notMarque/RomiOnSpeed/BOM.md

# Hardware
[4x Encoders](https://www.amazon.com/WWZMDiB-Measurement-Module%EF%BC%8CMainly-Information-Progressive/dp/B0CM3C8KFT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)
[20x V-Groove Bearings](https://www.amazon.com/uxcell-V623ZZ-Bearing-3x12x4mm-Bearings/dp/B0DBQWDBWD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)
[20x Support Bearings](https://www.amazon.com/uxcell-Groove-Bearing-1080095-Bearings/dp/B07FVYR9S5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)
[10x Axle Bearings](https://www.amazon.com/uxcell-R168ZZ-Groove-Bearing-Shielded/dp/B0CLVFJ4CR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)
[M4 Countersink Bolts](https://www.amazon.com/HELIFOUNER-Countersunk-Screws-Kit-Threaded/dp/B0BKSH8MDN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)
[M4 Socket Bolts](https://www.amazon.com/Kadrick-Assortment-Metric-Washers-Upgrade/dp/B0BZ6XG8PT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)
[Grub Screws](https://www.amazon.com/Matrelt-Assortment-Stainless-Precision-Instrument/dp/B0CN1JYRY8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)
[O-Rings](https://www.amazon.com/uxcell-Rings-Nitrile-Rubber-Diameter/dp/B07DG6CW6R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)
