notMarque/RomiOnSpeed/Mechanical/Diffy Swerve v1 Notes.md

# Assembly
## Bearing Stack
More vertical clearance
Expand horizontally
## Super frame
Make Holes for bearing bolts self-tap diameter
## Standoffs
Make holes self-tap diameter
