notMarque/RomiOnSpeed/Mechanical/CAD Process.md

# Diffy Swerve Module
## Wheel + Axle
Small Bevel Gear: 11t 1.5mm module
### Bearings
#### 1/4 x 3/8 x 1/8 In bevel gear
[R168ZZ](https://www.amazon.com/FOCMKEAS-R168ZZ-Industrial-Mechanical-Equipment/dp/B0BMW2P61D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)
[Other Option](https://www.amazon.com/uxcell-4-inchx3-8-inchx1-Shielded-Bearings/dp/B0828JXX4N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)
#### 1/4 x 1/2 x 3/16 in main wheel
[R188ZZ](https://www.amazon.com/uxcell-R188ZZ-Groove-Bearings-Shielded/dp/B082PQ9FSY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)
## Big Bevels
https://www.chiefdelphi.com/t/involute-gear-design-tutorial/387230
[Bearings](https://www.amazon.com/uxcell-V623ZZ-Bearing-3x12x4mm-Bearings/dp/B0DBQWDBWD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)
## Mounting Plate
[Bearings](https://www.amazon.com/uxcell-Groove-Bearing-1080095-Bearings/dp/B07FVYR9S5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)
