notMarque/RomiOnSpeed/Electrical/Top down requirements.md

# Main stuff
- ESP-32 Based, likely using an esp-32 s3 Wroom
- using an rp2040 for low level control of motors and encoders at high speed
- broken out connectors for line sensors, ultrasonic, at least a few servos, and everything else that we have room to break out
- 4x fuckass motor controllers to make romi go brrrr
- leds and oled diplsay
- Enough sensors to know where tf you are
