notMarque/RomiOnSpeed/PCBs/ModuleBoard/Motor Controller Board Design.md

# Parts
## Drivers
[DigiKey(shipping?)](https://www.digikey.com/en/products/detail/texas-instruments/DRV8244HQRYJRQ1/18182849)
[DigiKey12a](https://www.digikey.com/en/products/detail/texas-instruments/DRV8243HQDGQRQ1/18159292)
[Simpler Controller](https://www.digikey.com/en/products/detail/stmicroelectronics/VNH7100BASTR/7691017)
[Two in one](https://www.digikey.com/en/products/detail/texas-instruments/DRV8262DDVR/23331378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)
[DRV8263-Q1](https://www.ti.com/product/DRV8263-Q1)
[Real](https://www.ti.com/product/DRV8245-Q1/part-details/DRV8245HQRXZRQ1)
## Connectors
[XT30](https://www.digikey.com/en/products/detail/sparkfun-electronics/PRT-10474/8258064)
# Driver Settings
Diag: LVL5 Off-state Diagnostics disabled
Slew Rate: LVL5 Randomly Chosen
# Notes
gpio 6-9 for encoders
GPIO 10 for n_sleep
# BOM
- [x] 100x 100nf 0603 Caps
- [x] 6-12x [10uf Electrolytic Cap](https://www.digikey.com/en/products/detail/nic-components-corp/NACE100M35V5X5-5TR13F/22320440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)
- [x] 3x [DRV8245HQRXZRQ1](https://www.digikey.com/en/products/detail/texas-instruments/DRV8245HQRXZRQ1/15926671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)
- [x] 3x [NCP1117 Lin Reg](https://www.digikey.com/en/products/detail/onsemi/NCP1117IST33T3G/14545464)
- [x] 3x [W25Q128JVSIQ](https://www.digikey.com/en/products/detail/winbond-electronics/W25Q128JVSIQ/5803943)
- [x] 10x [RP2040](https://www.digikey.com/en/products/detail/raspberry-pi/SC0914-13/14306010?s=N4IgTCBcDaIEoAUwAYAsyQF0C%2BQ)
- [x] 4x [ABM8-272-T3](https://www.digikey.com/en/products/detail/abracon-llc/ABM8-272-T3/22472366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)
- [x] 10x [Micro USB horizontal modified](https://www.digikey.com/en/products/detail/amphenol-cs-fci/10103594-0001LF/2350351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)
- [x] 5x [XT30 these ones are 60A peak]()

[Digikey Order](https://www.digikey.com/short/719qh9n4)
