notMarque/RomiOnSpeed/Camera Improvements.md

Try finding black blobs because all walls are white
Trying to call numerical values
Can set diff frame sizes. If don't find full size tag, double resolution and search sub-area
