notMarque/RomiOnSpeed/Goals.md

# Mechanical
## Performance
Top Speed: $8mph$ or $3.6\tfrac{m}{s}$
Twist Speed: $150rom$   ($100-300rpm$ /$0.6s-0.2s$ per rev)
