notMarque/RomiOnSpeed/Code Shit/IRP I2C Communication.md

# Sources
[Pico to Pico Communication via I2C](https://forum.dronebotworkshop.com/raspberry-pi/pico-to-pico-communication-via-i2c/https://forum.dronebotworkshop.com/raspberry-pi/pico-to-pico-communication-via-i2c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)
