notMarque/RomiOnSpeed/PCBs/Main Board/Notes.md

Just started, nowhere near done
# Sizing
(8mm + 20mm)*2=56mm
# Shape
==Looks goofy as fuck, please advise==
![[Pasted image 20250424031044.png]]
