notMarque/RomiOnSpeed/Excalidraw/RomiOnSpeed Horizontal Lower.md

---

excalidraw-plugin: parsed
tags: [excalidraw]

---
==⚠  Switch to EXCALIDRAW VIEW in the MORE OPTIONS menu of this document. ⚠== You can decompress Drawing data with the command palette: 'Decompress current Excalidraw file'. For more info check in plugin settings under 'Saving'

# Excalidraw Data

## Text Elements
Rigid Caster ^bgVhg6Tt

Compliant Caster ^HxKlhEez

Swerve Modules ^P1vYqv42

## Embedded Files
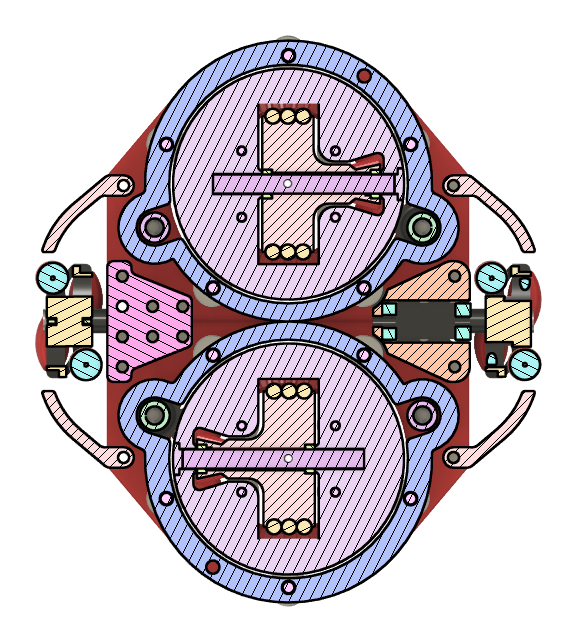
[picture p1: Pasted Image 20250506162951_264.png]
f13c5fbc5453cff97808ef78f08e42022ff3a2b7: 

%%
## Drawing
```compressed-json
N4KAkARALgngDgUwgLgAQQQDwMYEMA2AlgCYBOuA7hADTgQBuCpAzoQPYB2KqATLZMzYBXUtiRoIACyhQ4zZAHoFAc0JRJQgEYA6bGwC2CgF7N6hbEcK4OCtptbErHALRY8RMpWdx8Q1TdIEfARcZgRmBShcZQUebQBGeO0ABho6IIR9BA4oZm4AbXAwUDBSiBJuCAAtKuIAaXoABRgAZQBmAEcANQBZGABWAE0AUQBxABkADgA5UjTSyFhESsJ9

aKR+MsxuZx4AdgBObT34/p59vb2eSb3kgBY2zcgYHbb45O0DycmANniD/ptZInA5tfpPCAUEjqbh3SZ3bQ3QHxQ6JO4/MEQyQIQjKaTcQH9bR3E7JZJtHj9G7ovYQ6zKYLcZIQ5hQUhsADWCAAwmx8Gw5hI2dZmHBcIEcvMyppcNgOcp2UIOMRefzBehhRxReLslApZAAGaEfD4FqwRkSQQefUQVnsrkAdWhkm4fCKAjZnIQZpgFvQVoqEMVeI44

TyaHiELYYuwaheEbJEIVwjgAEliOHUPkALoQg3kLLp7gcIQmiGEZVYSq4VJB4TK0PMTMlsvu20IBDEbjxHinclAu7MtuMFjsLgJ2nDpisTjTThibuTA77SYovY/cvMAAiGSgne4BoIYQhmnrxGGwSyOUzhQWxXdZQqEn6pEIAHlxph9Mw38QfgAhN9BgAKw5fRMHhKp9TKJZxHQcV2SoB8AF8nnvO9ICfDV/zuTRuQQDkAA0AFVxjqPYAAl6DgRo

zUCABFaDFngOCIAQtgkLvZD3VzNshDgYhcD3LsIz2dF+gxO4eGXB4ISIDgOWLUt8Dktg5X3NBD3wY821ZIShEzCBEGVCtlBtI1giLCQDXiNpsH6A1NHsu5AWwA0DQOPZJmSSYEANLyDR8hApOSc53LaXAeE0PYbWYdw4NvBZIwfeIeIhbB2TgJSTSKVCihKR8RPQTRlC6SRlB+AAVPUIVgyo90wGq222NBnBcvYUh+ZdTh+MT4juUEIXjVBnB7Dr

QQeULewODFJjdBZIWdbtB20H5KSxHE8T1NAeDuOkOAZOChwWu0vVVAVKgAYniBAbpum0ZTlZMlRVPkLqFcgtTFCUmoWizTXNViAy7FlPUdJadtB+1vUBypgZtYNJEbTNkoW6NZTjbtEzbZ60wzApeL+gsECs1AWxUtsK2IKsJFweIEbPZHsopk6OyK2z4S+ZIZohEcZ3HVB0UeKdR1nec4P+H4fJ8gaN0p7ddw01AtJ0hbTxei9Ml1G8HwKhasOg

HC8IIkiyMo6jaLZBBGLQ5jllp0hEIgFC0r4gShKVlFxIxM5ubOOSK0UtBydU9SipVhBaqwbb0AAJVxEhUG5UI9zmINKEq6PKnj1RiCTlOmHMzgoBaQgjDgnhjrKA1i4AMVwfRjWG4WFoaqAAEEiGUAWIGCA1frKEcoHMAhO9xHuoGjG09ByXAKyYUmQ7bAUE44AhM8a7OE7z5PWULukhEn2PwjLuC2SESO23khAKM2/EI20Hhcs2PXyiKiAKMwOp

8EkYYECMG0dUhRZwhC1XgZxPg+RuHsM4bQKQohbmUYazg1raH6O8XaPxAReX6ugiEUJiAwgjDcNBG1cT314HtNs9I/RVw9NDc66oIDXVuqwh6sp5SKmVIw+qn1tQ/XMsaAGvogZ8kDLpMGCAnSEJdJDCR0MfR+ltGIkGbZEZMwjFGGMmMEx0IgLjdMN5CbV2JovZS5ZKxgLYjwBmL0NFk3MbpNmBJyRzS6suXm04xzcClnLBafMxxzg4AuCMvZxI

uR7JuHcwRhIHiPJfNWZ5NZXlyAUXWD5MLvxfO+T835fwASAqBcCkEmLQBYtWR2HFnZcVdgtfiglYmiW9m0AaldBwBwUszUOXJw7xKjpvCQvJ9A+CcFAfOe805qIzlnQZBgRnWDGbvVORccil3Lq6PRNccj10bvgZu/SO5dx7n3AekAh4j3wGPbu9Up7pWLnPUMpAzGtjRq+fw68ZnoCGfMnI4zlkHyPifdZaBz4JLKNfW+5CY5JCfqUPKpRX4G2y

R+L8P4/yARAmBCCdwoK1XKQ7J2oDXRSQSHcAa651w/DhFSRBzwdhkoSFSB4tkrhwJ4GtfBENUB/FWucS4bQ5rSUmOg3aZCtqwkRIkGa/R1zcy8skSJ1CDq0KhmdN6TCWF3Q2G2R6nCzw8I+iKb6upBEmkUaI60qrwYyNdFamGIi4YqNsSGMMTItEY1gFjPRBj8ZoBzHmUxRUl760sdWNotiGyurQHrO2Fd3TwrKGET2kw2iXEuH8Pxg8vGcG7FcT

xosOBBJCagfqA5bJkkmFExWvTtJgsgOrZUyTtZdLdg0z2YksGSQBDSjpQcHEvPBWpHpcTa0QjgGwCsqS/UPkSgsOhpRkgPmMaUWdpQUFJDWhcAV5wvgiqoRhBEq5JYyqlp5byPYl21PBSnIZjcZCdkaBOyUwdHEnSiKQKA/4qamW4DGjAl5dSkw/l/H+f8AFoQgDXbABkdgfD+G8ZcPlK4Ah4KmzNZRlC4CygmY4GIDhkhgT8FN/RQSTHjRCbIxA

v0mQOr+h8/6tY5CAzUeoTRWidF6AMEYEwZiTLvJBtSMG0AfGBNJCSyQqTxFXCmgcEHMPYcoatVN3wQT9G5qhg45GJHig7pUig2JcBBtfWUSj7c9MGffuxKgFH8CngoErCOz98qU3fp+3C+EiKkXIlRGidFraAPxfBPTNowHODeBuyWLSri/DmjKoaOx3htERLcLBwqXKoYVfusoBCiGoAgecSkbQDiJErhS2lUg74x36Ie641wSSEd6kR/ah03Xy

LVWqK6Wr7ong4c9bh6reFGp1JKPMQjzWOstW161uX5qJskeNy0Tq6x+CRlG1Aej0axk9bopMio8ZGIDQ3EmRmB2YVDbTO4EbiD2L/UA3gWnWaexI+WqlcJ83827P0cEIt+ZForq4taWDFX6wVjEhzfSdVJIA9eFtdT3aNJLR2iSYJdpzUrVfQOsPB1hxHarMo47J06zvKusA87SdLrQiT/L5xATFZ7MCXqtLSjVcRLV+ElwJKNbI3ebMV7ID4BvQ

YO9wlH2Tqxx6HT1HHC0ejfRjIKSgMlTKhVaq0EBPQczM4D4ew4FgkBCSa4SJ0f8fkxKuaLlvIHBcuiH4tu7gPZM8qKXP7Zf8fl4B9+LGGjNHaN0PoQwxhTFmGrqDQmRofAeNVikanki29OHA9DkBTc7Q+G8Vc8CJLspcjNB3EuP1mcQhZ8XGBlQF44kXglVSbN2fB7WpzCKXOVEaPEeggwOj0CkgF+2GoQHNVhLtFIZxVylYeFLcryCeyTGOAcTy

qGThfbTehxaNqIxUs6utNs2IoXEuayqqbPIBsSE1WwnrT0uGvQ64ar6w3TmQbG7DRbk233Q2kTNu1C3/RLbUcIF1TZuzuq22GneG9T20MQJkO0LBOxZkfHO3gn6Cu3sWDUTWcQnB7DeFCiyzOWzQFlwXe0CXFm7F6hTS6nhD0UIFBwQARwjhPCh0YynSzHSQwjfkqAeHwAAH0eh4hmBcAqhKpJgWh25+g6h/wDQhBa58BTkYJAs2JgsUI0IY1MlK

gOQORbh/wHQOgqNxgKJiBsBRh/wfgWhlA2hiJw1bYylu8ZCnYXYFhl0IB6kPZ2YkcfZbIENe1i9+QcdNIIdW5PkIAWh7NSBGBUAeg2BiBSxwgEZpkBl0B/CmAgiQiwjgg8g8xi41l/sUjtkG4m5uBys24rljk/Jb9zl3B8ibkso7lZ554nkoCow3kKwPloi/CAj4jQjwjkjqFD42Bj5WBgVUBQUOkb5KtuxH5690JCoWC2h2DODuDeD+DBDhDRDx

Db87tLCq8+80A1MER0RzgM1Msvhx8dgAQEgxJQpbchULcl8ctZFUABUp9ThDgqQvgHgYFUYygt9xUU8fhksXCvJ8M1pvsFoaEjo7UDV0Bj9usdVetz9QToA+FjURs2x/oP9lEn85sX8uVZt6EvRkT4Zltf9MwNttFtsS1sYFofUDtETA1i8qYaZ4IfgEC1tbtAtYU4UWQUDUAdcx8MtMCGBsDXQ8Eft8DgkJYh8+xzgeTyDolKDa88d61aCUlmxj

NIB7CEcvZO0wRgQE83CX1Tte4h0ZS60jIn16DV0ScydF0edKcMldgOp7hepPJ8NpJfEWlbYXCUhBxQRexyRStdoKcZ1rTbjGUHilx4RU0BSMJK4vibgfilxY9KRL0bC5JBd9BhcH1jS0k7wwtvggyAQQznjwyFhIzvi4Ffi4z+g+dbR31P1v0ZdUA/13cmN35m9W929O8INQ9NcRMKR2d2U2lK4aVMSk8sNuAjh/iupbhhUdd/hc8S8qMayzIdTo

C89dNC8Qgai2xTNzM1yKlCUNzbMOIDTRjEV35lDVD1DNDtDdD9DDDjDTC2wVirMQsCREhjgrgoF8M7gexPIl8J8WlVp6t3hSDU1exLiuUpIktvzAQiMyQvhGsxUKElwEhh900s8isURd9gT98YTwTtU1YoT9VD8NQ4Sb9TVhElFcT99X9rjMTKyFEH9P9UTIB1E1tCSPUgDSSMNQDfUsxbD8wjtnklzyhYC2IYpltI0/9XdW5mSZyk0ipoKJNQQl

8Akc1Qljcs0C0/tYQh9PJuyq0wca1ZSIAG1zxod6CkDlT4d21ml0E4F/htT+1BKPDh0vDR02wCcYdp1icMlzS/SvKMJRoBVEQVMO1SQzhE8wBnA5pVpQo3hPyZpbIBpfKFgSc2pUNPh1woLvJuZfh1xbZIqjgpMxp1xULis9gEzShbCBdWRb01ARd0zPKFhUqIKMq2h5LYLcqHx8qkKirAcHhSqKy9IP1ndaz6zTKgNmy28O8bF2zBMCTtAWllw7

dyRyQvJUMN8TdhyNjEQSQvgThdpDgyUZzKNhqFyHLQYdMy99NtzFyKNS8tzDMdy1iFogga8DKEBcpwBCY2I4A4AzQPY6MYJsQshKgu58RNgGBCAEAKB/x8KXpsL3IEaDQpQIBoNHZAM9x9A6J2t3owSutcLIBUafpUwMaYaz8CLL8iKhsBFwbCb0bMha578HVH9xEyhaamMMasbptqKaaRAiaOb5t6KUSWaCbea6b9BY4f9VsJL1sea0b2bMg3wi

T2Kq4UbRb5b9Ba464si9kcjZa+b6bUjT4Nk9axaN5Dlx4QbCjka2aoBibMg/r897r1zWa1bbaMbhg7rVyHrK9rMihVa5a3bMhLrKppDz9ka4p2QTRCJuBDg4h0FQQoKZ92UJJwaI6+R8BBhYRELU1FL9hbc1NOdwajA2ADAAbB4CAL4mRjhyzWS/aba7bxbGY1sIAw7waFQSA0jja/b27iAzQEAFMASk9XxiAEiEAPbcBNBgg3q27h7QTX5/w+R3

5SBlAZQAAKXsWkXgdCrezej4foAAShtGPmUFLHFEqGXrXoy2oF4CBGvqvvWzQUPtGP9p+k5oQEVuHk4EVIHUg2JmPkrFfBGo3LXknqVn6LbGwCIAU3AYWjXmBpBVIAvijEPmvm4FBWfrsGAgQGwFyBaDXjgFHvHtAenr9tlGHkYEqhLvwDLtjThgyBwe8XSgMknn0BDu73Mr1M8L6MQcNPzAMBaHoc/oFmoKvhTnbgYYoaoeZg+rAHhTvySN/W4m

QiAA
```
%%
