notMarque/RomiOnSpeed/Excalidraw/RomiOnSpeed Side Profile.md

---

excalidraw-plugin: parsed
tags: [excalidraw]

---
==⚠  Switch to EXCALIDRAW VIEW in the MORE OPTIONS menu of this document. ⚠== You can decompress Drawing data with the command palette: 'Decompress current Excalidraw file'. For more info check in plugin settings under 'Saving'

# Excalidraw Data

## Text Elements
Battery ^UHLA0zpS

Mainboard ^HnPc4Sg0

OpenMV ^pUpjU26c

Rigid Caster ^xbQSwX9h

Compliant Caster ^qkthdMDI

## Embedded Files
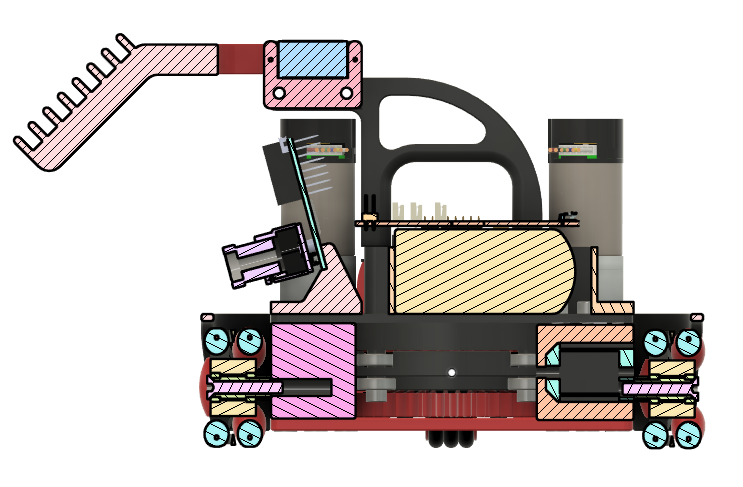
[picture p2: Pasted Image 20250506162554_531.png]
9ef8d6fa3cdbedeb506a24360c639e40fbb60c4d: 

%%
## Drawing
```compressed-json
N4KAkARALgngDgUwgLgAQQQDwMYEMA2AlgCYBOuA7hADTgQBuCpAzoQPYB2KqATLZMzYBXUtiRoIACyhQ4zZAHoFAc0JRJQgEYA6bGwC2CgF7N6hbEcK4OCtptbErHALRY8RMpWdx8Q1TdIEfARcZgRmBShcZQUebQBGeO0ABho6IIR9BA4oZm4AbXAwUDBSiBJuCABmXABNAGsADnrSGAoAOQBxAE5iABkKACUAdmVOgGVhtNLIWERKwn1opH4y

zG5nKsa44caq4eSANmGAVm7kqpPh1cgYDfjDw5ThqvieYeGAFkOT7YubiAUEjqbhXYbaRrxRrJHhbQ7dQ5VKrdAGSBCEZTSbj7RraF7xKo8bqwxrdN7xAHWZTBbjJAHMKCkNj1BAAYTY+DYpEqjOszDguECOWmZU0uGw9WUTKEHGI7M53IkvI4/MF2SgIsgADNCPh8ONYDSJIIPJqIAymSyAOrAyTcPhFASM5kIA0wI3oE0VAHSzEccJ5NAUx0QN

gC7BqO5B5J0kNS4RwACSxEDqHyAF0AVryFlk9wOEI9QDCLKsJVcKkfcJZf7mKmC0WQ2EEMRuA9PrCCR3PgDGCx2Fw0J9gzMGExWJx2pwxPaCcNiYTocXmAARDJQFvcLUEMIAzTV4gAUWCWRyqYzAKEcGIuA3raDXx+iKJVUOPFjo6IHHq+cL+ABnISpuaDbvgu5NlEUBCKmECILKJbKGaOrBHmEjdAgWqNMQhzblU2DEJoLYIJoJxHLgPCfK+yTY

Ii6GfMkWqaJohzUZ8rb0u44hpo6YAjjM8SOpmIbYEycC/nqRQAL6rCUZQVBIACqAASfQAILJEYcDjGacxcdAWAagC6wPsk2ivgSb6fFc7wnD2IZRqgmxJOchyfI0PyJLCySfNcIZAsQIJoNsKSvDwJyouimIamgFGUhw1JcR+ZQWi68pcpUADE8QINl2VmmKErxjKcoculSrkCqApCoZIbIfqhp6V67EQZaCA2gFdoxfSzosm6Hrmhy3ohr6ki1q

mfGQGG4qRm2MYAkVSYpgUQmjtmuC5veqANv+IYlsQZYSORZrSjWAbiTto7Npt8TdLZWyfJRDqjn2E6DqgN2+c944DlOHAzkG8RHMS3kIsua7BHeW47gge4HsemTquePGyaO8noAAUjAuCHgFABWJwUKp3Toyc2CJiukhKQAYmSmplLp5akEyVA8ZJgmXtet7Ae9j4nM+8LbOFIZfj+aDbQBbBAZtoHgaOG6YNF6AAEK3hurTHZQAAqBmVCrMhMHc

WacFA4yEEYXHvkbORU+tuoOVUALy1AqlEMob0QMEWo1V9pBQOYBAuxi7tQGGZp6DkuAlkwqFbX+AJchiJYENrCu66rBtmrgQgh4M4Rm1xjJCDDwtR0pkVYkG2g8FJMm7ZtEBKRwAAK2CfOMyiViGDNKjrRnYtoHnvN0D3D2+pJHACDnOFC3QpFZlzHKRbnbI0AL+YF73JCc2jfI0pwRRiFe8HZo5Uh6SVOq1aWKugWU5ff+XipKJ0lQqPIVaq1VI

bq9Xuo1g3NUuj1Nqtp7TdVan1f+poqx+FGmdIM8dwwzWjBfCAC1kznhWmUNaG1zrFlLMZdAuAqjHQPGNPBTYEDcyJIib4yRV4hhegOWchxezfUnNOLihwCTxF2EcE+clVzrm5jLYuo59zFXhqeXIBRkY8UgGjCAVMrTEGwAAWUkIcNgSsyaEAQAAeU+EYGALQ2CdDprMeAelBTMwgKzdmIYrw3khg+b4fNCTDB4I8VhJdvwUM/JLFk0toaOx1hIN

RkcOD7kFIAso5AKAp0VhACJJZomkFidqY2ptzb2lQVqY2Nt9B22xKEhWgc3aVE9t7MofY/buHKcHUOAJw5RCjqQGO4sQwJ38MnMJ6AUlRLYDEzO2c2C51YDktAhcxFlC/AgMuh9FZJGrqUaSRQUblHrnABScBcYKS8dgHSVieS9xDIQpy4I96uTJLZR4VR6E+NHA5HguJXhXDBCceI3w3IPTXqAtABwzJvCFqONEiz7QCMgGfRK4DUqlRvhAO+uU

VghgKs/A819358iquqb+epIGVCamaFK1p/m8Fhb1BqhKAGkNgeQhBXSkGwFmqg9BS00AXlqjmBAHS467QIeWT4tLTp1n8clKh11ugfHxC81BTDOD2mJGw/sHC/pcShAcGELzXJg2EcEsCMzIASNlFIxGsiZjFHkZsyoMB2iJlxs4eg6NaiqVIFqdoTdDxN1xu0ZwmtboWOgMcw6TM2AswtWzGYWDIBOK5tdXm/MKJ8wAiWUWsdGwBKllDA1pSkn6

LgmogAahrBJfSID5uyEWpCWT865KtlAQpxS0AOy7gZBplSMLVMgLU/2+B21KiacJY2kTo6bU6aObpSd8CJMqBWjgVbKSjPGbWqZpAi4pv9AsqKbYq413WXXSomBNAAEVxgUAABrdDtI7YN6AnZmnOe+XE8RbIviOBcGELxJ72l+BCYYbwtgHEaJ8BEE1ARkq+aZN8IKyhgu3TFSFEBoW0gpWyeFmVkV5T3E/IqspMXlWxWqYUWYf4EuNDS1D7UN5

PWSsAsjnoKPDWEH6eB71EHTWZSg+a0pFqYKzNy3lGa5ICsOicYVxB6XpouuK6hFkTheMaAwn2r1uD0Rg929hHBfr/Xetcliw9Yq7SERDERITUVwxPGajlciLUKPrkpJShxL36GGFABSzhhia1kIeK8iZlCfCboG7uRDQ3hpmJG0o0aICxpcTzNxz5GifPohutN47ZmBNMzm1tqcJCDETsQVArJQhqxLTO3L+XCvFaYNWnI2SLZ5IKbbfA9tc39vQ

FUs0Pb6mu0aWJZpw62mCek5NUgicOC9Jy+gPLqgCtFYZNVxdOc86TNQNMjd8zy5LN3as2uqN64AEd6jqGIGolciYjnzB7qnPuaBTJ70uPQ+er4yT0UeWUZ5LEq4sR4BZV4vDkgoj8hBve2h1NSE2xCuKCUUMtThW/CQSKH7YcKi/fDd6P44uI7VUjVLyPQNh6SjqYCCeulxwx/Ho4RqSbA1NCMnHN6sp4xg5a/H1o8rHXy1GImiGHHE5JtLAgJWz

VeIl35jDNOqbfMq162muJVEoj8WynjdUmf1bLUUFmEZnnNTMFGcl67dETOMVkh5C31HPckVkzgYAnFIJoT4gxj1CEOM4ILt6kOhbsRGhxo4Yvc14fFwk3RoTK98alzn6Ws0gTM3LMt7J9A+CcFASr83uQ+i1nHgwifrDJ7myV+tdW621Ua0U5rJTsvOx6x2r2nWmB1IDlXgdfWh0R0GxzoTI2xsTaSfH7POQU/55DFnJbEyC5rsNR7UuEPK4rLAG

s0oGzFG2vtY651rr3Weu9b6/1Ymb2XZC7Ym7jkKKmS3icS4pFPEwi+Up972JZ5vgJKSB4K8LgttHOvTqvBcQ+R4H/84FwLkYUB88GqAUGw8HYXw5wsIlE+8Q+8U58qGaOiKmGKK4iOGqO6GBGlURGXaEAdU9GA0FOtGrUVGX+NGl8LohBRKMCLGoqt27GdODkgMjOCYzOHKUWOC7OYqCi3OSGUwMCIqqYeuQa++s+c+9IQuQYpEUIi8hwt+GmKqb

0YuymP0nCbYpIiIiWXwiGhAxmCAsWoisMkilm2uYsEeManMsWAeT48u849CgOn4qaPBHsGWauE+cAbAJYMi1mFqhQtmF8pQyQPE0aYA/hFqLyO8ni/+MYyIRwwB8i4BD07wIGMI8u+wJwIRPusyxW8eRS+sxATcXhwo5hHe5oUQvsSse0CE3AIhGQ0iMcsEOyeyBydM+Bks0EGwpkXY3Q+w8uXi/6dhjwNwkAyguAYkAKoODyr4PkdCvRpwjo8+Z

Q2QxAVR8E8ULhDIgozsoWaIuA7ew2GAsorqzMex9cNiYaZoQQ+4FAmWYQe6C+B6EgmM2MeMBMRMJMZMFM1MtMe+1inuR+7YCQiQ9yXyf+iQL236aA084IhI9y8hewt0hIvCfyRO0h28JwmJtkN0xIGqYOcGR8rkoOew6RpEvwZwWwUOiBJOyBiOWGqKGBGKWB6OhGX8JG+KZORBQ0QCpBZKFB5RECnJNBTGdKrGqCtOyCDO3GbB7KaYnBAmBx+C+

0hCSGjQfOrGIhwW4hSxgu/u842w8hUqb2ihKmaA5+0uahaq3A0I8m3kCJKuBhdxE+xqR4phPhUmHMziepgePk5wpIKWLhgEQS2a6ukAnh3hSMfhiRIxYAwRFqoR4RMw08mJoOWJw43QuJe86mpQRJvwSIlEZJiWvRjQWRUaAEuRBg+Rd4RR3hmxFRUAaxjgGxaAdRbpjRykakGkWkbR+S2AnRt2xJBwbwim5+Xy+IE0ox4x3ATwYUMY3CFwnyfMY

UixAIKxjZNRpRhxWxvsJxYaZxLhKxu5FA+5Iah+IY1xYaTpDxlqe2lQyiqiGiWiOiiYeihixipi5ifxjMZ5o4hCrwURJItk/Cw8XyUJjkL64ILE9CyIewS5Zw/Jn+qms89ymJ6ZmZcBoK0+70nyZkimI5IG0Iu8ChSGCBMKNJzJKB989J6BKOTJ8OLJOBbJ2OHJf81KxBlBhO1GqG1BjGlOzGcC9BYBjBkpLB0pvmspnKq0CpLhe0B0RC3Q6pglm

pt62pkh3MnipIIGNCFpCqQ4YG8qWm6hZpZImlLwxp5Q+hhhMeGuJhWu7pAu0WVh3pthvpDhAZm5EsUeqARhIY4ZZh3EUZARMZcZZZPEiZpQzgIGZkZ+aFP2WZMZL6SQWweFtkwedpimpZkW5ZDIeRag1ZxRisDl25DZ1RzZqArZdljRjcLcbcHcPZHRqYpki4MImhL63wN03kIxaCU5kxD0VkDwL27ksIb4K555so65ZVRV9ZR5J5HpY1xAM1IQ5

xAJ55+ANxV5O2+6t5aERuJuZuFuVuNuduDuTuLuF2/xP5aw3AxIQKdy7w3kf+eFYFYUs8Xi1+r4f2BwjhZQiFQYVQ0VrwSIf+Pw7kLwxFBJisIOVk9EiWoUew+pVJZFPJcOZUt8qBj8tFxUyByon8uK7Jv8/UwpyNnF5B3FQpvFcS/Fkm4pTKzBc0cYTOEl8pbOQ2SpclSGqkilwhPEohFso1l0Uh70j18uwGOq4uSh2IyW4tMuRl2FiWUID0Ytq

MllTpxhJqbp9YFhjlXp8aPp9h/pYegZbhIZHhBVkZMw4VsZwVIRIxltBIANBIhIXivwxwlJ8izgUNQFsNw5+wwemVYAUW+AFZ+gVZLYNZJRc1QC2xE1iELZPN9R6ojRh2x2p252XVvZ/Zjkp+D02w0Rc5FJjwt0XVYxEx70/Nyx41pVsdkdtG2xi1+xB5xxuxS135lxq5a1l57h15i+9mjmzmrm7mnm3mvm/mgWX5p5bdZy9wiIVcbwINABlwC4z

18mEIEF7kkGvRjwiGv1PMq9bko8VwGZFw4NWFXw0VqFOJcVpw5lyGDB5F9FlFyKGN6KWNFFONmOeBBB5N7FApLoZBxOxNpOrFeO3JlNopglNNHGdNrB4lfGXKLNip/Kyp5YSsXNtRPNWp5dup10I8yIweya0tzCMU8mOlhlVpAMgM8hyQuwuhKt7hatrpdlmtZRfuutLl+t31kAIsRtXlPlo4fl7p4VltgRsZNtYV7tvCe9mlPw845wbttmHmnw5

92JGZV9fM/tgdwdodhRBVdZ0dVd6DFqGAbZ9cR6p6F6V69VfZqYzgpkLypwc5mqXiN0Sto4Jd05KQqF8mfMpwZwnyVQWDRxqxBjHlEEddzdDdoTo4h5ETy1l1kAF5txXdqy4AK0SGcAWkkEXEsk0AaIWQlS4KqwDAeiFAKsmNeGFFGUWo1TNTIoEAfZTMidG4+gBoV8lT6NRTDT1UiYzTZTL9FTD979uBdTXTTTmQVMOOwD5OoD9TIg3TzTrTf9f

JnTczYzLTdG39MzozOQPTmQgwVNYpKzjTOzzT+aUDLKRz8z4zJeTaqA7+kA2zUAuz+gVMNaK2lsRQszxzTzzTiSbWHsnaIzqzJzmQBo4TpxLdUTDzwLPzmQh4TdELkTB+k9ZQjzzzR5ms7uL8dTzAIkHI+A5605KZkIW8u8GFAgeLeotQ2IbwCQ+pYUpIbyPkn0kARgbABghjNSBARcbY15XzVz+g+zxUkmEA2LRTUoJAheMUSUaCo2xABoCApdM

GsrJAaibA+08LuAmgwQ9DnzErr8qNGySsHI9cpAygYoAAFD9tcLwCibaza6ZCcAAJRmi5zKCFiCiVBmuWteTUC8D3J+u+tgGg4ut8uPOLMsj5p+ycDMPSb4Hcq5ylijZlUbLZBas6vcBrbCRECl1Zujjjb5OrrrpdLZxzKZvj58t2C4wIDYC5DjDjZwBqsavjbauq2fPih+yMCazsv4CcuWL77mgZC1vMLNLQQhz6CYv74OVBncx5vYJMgtNDvRt

vR8M5EMiqTDtds9vnRSTgDz74G6jhC1FsySRAA==
```
%%
