notMarque/RomiOnSpeed/Pasted image 20250407233751.png

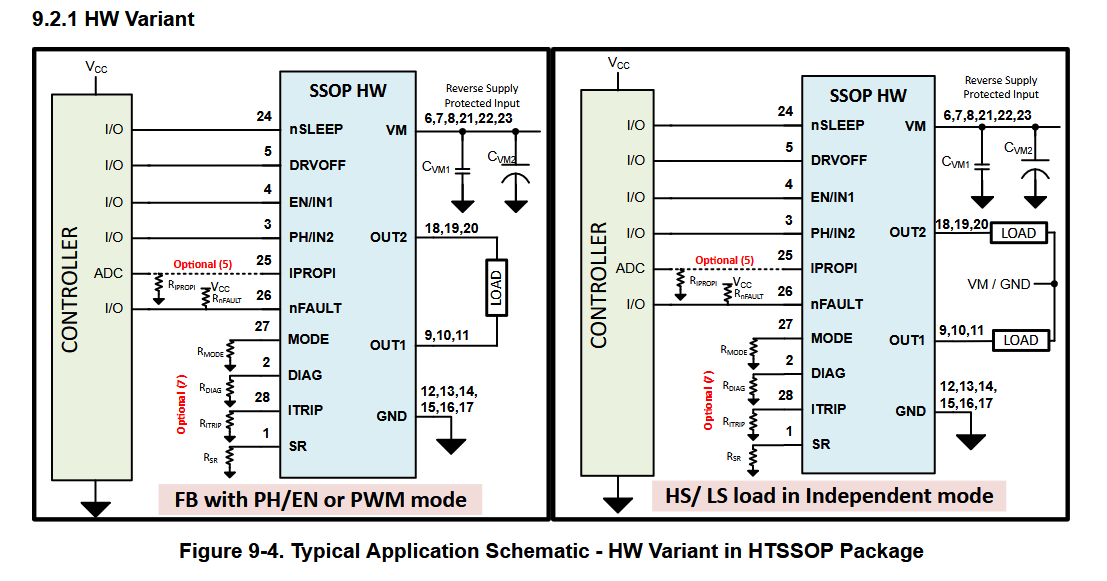
Pasted image 20250407233751.png
