notMarque/RomiOnSpeed/Pasted image 20250424031044.png

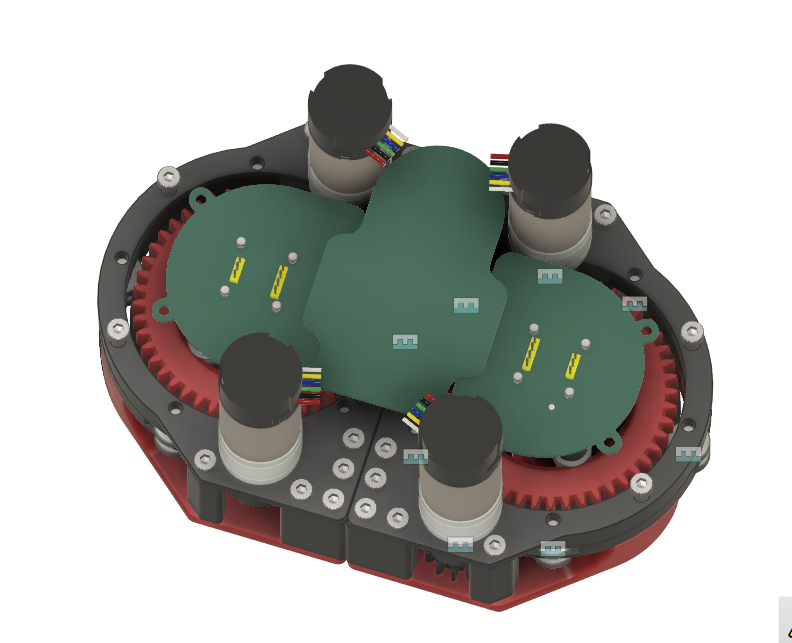
Pasted image 20250424031044.png
