notMarque/RomiOnSpeed/Pasted image 20250506014508.png

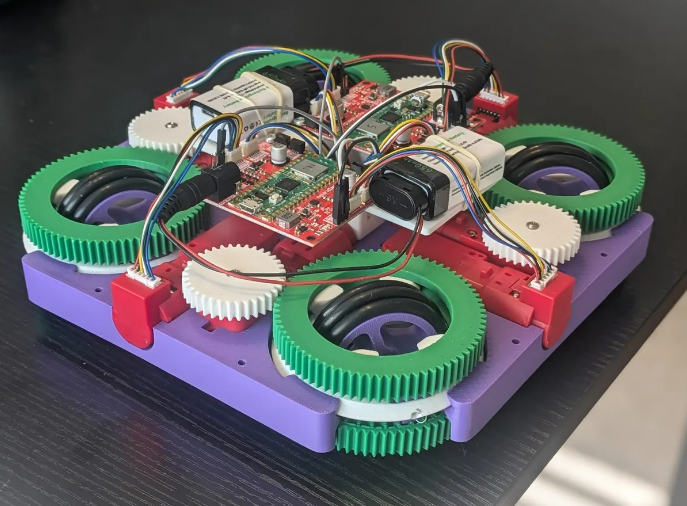
Pasted image 20250506014508.png
