notMarque/RomiOnSpeed/Pasted image 20250506014532.png

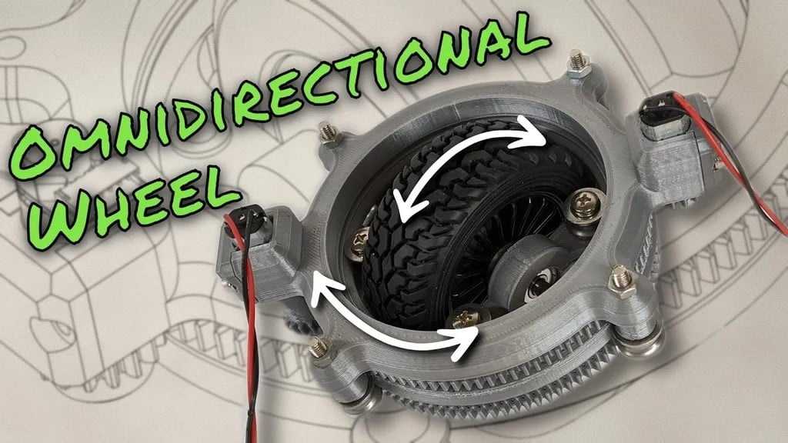
Pasted image 20250506014532.png
