notMarque/RomiOnSpeed/Pasted image 20250506014714.png

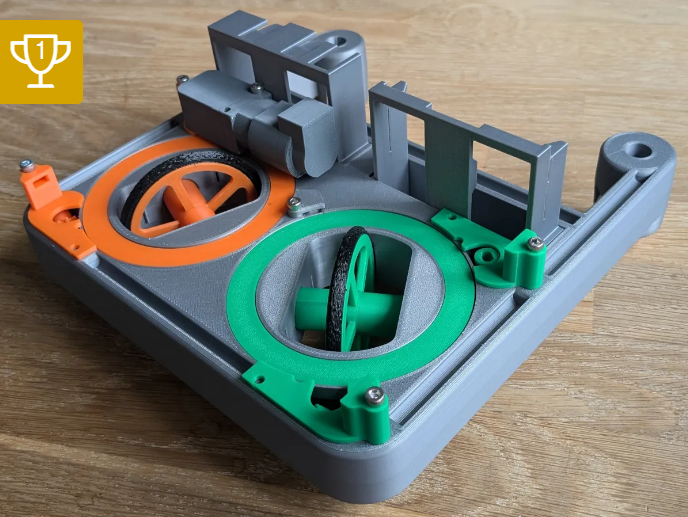
Pasted image 20250506014714.png
