notMarque/RomiOnSpeed/Pasted image 20250506021302.png

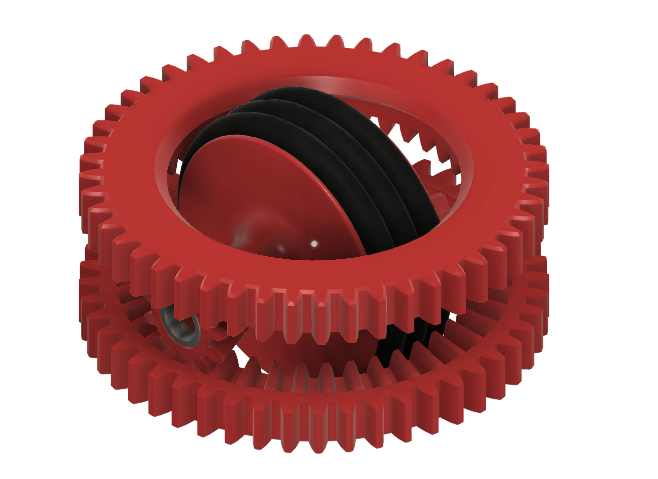
Pasted image 20250506021302.png
