notMarque/RomiOnSpeed/Pasted image 20250506021351.png

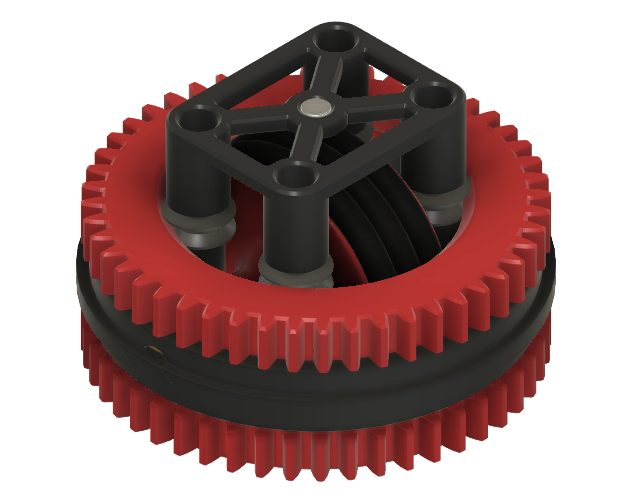
Pasted image 20250506021351.png
