notMarque/RomiOnSpeed/Pasted image 20250506021433.png

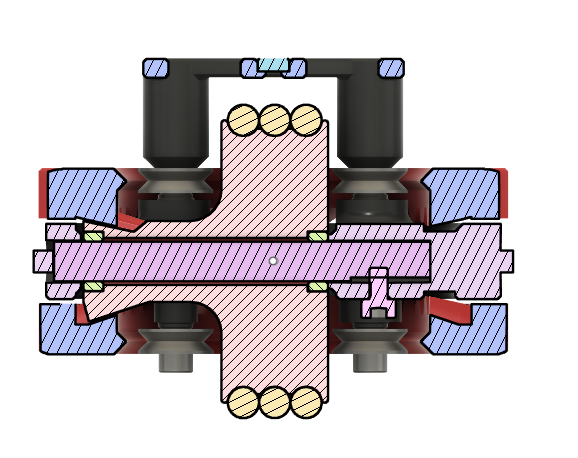
Pasted image 20250506021433.png
