notMarque/RomiOnSpeed/Pasted image 20250506124521.png

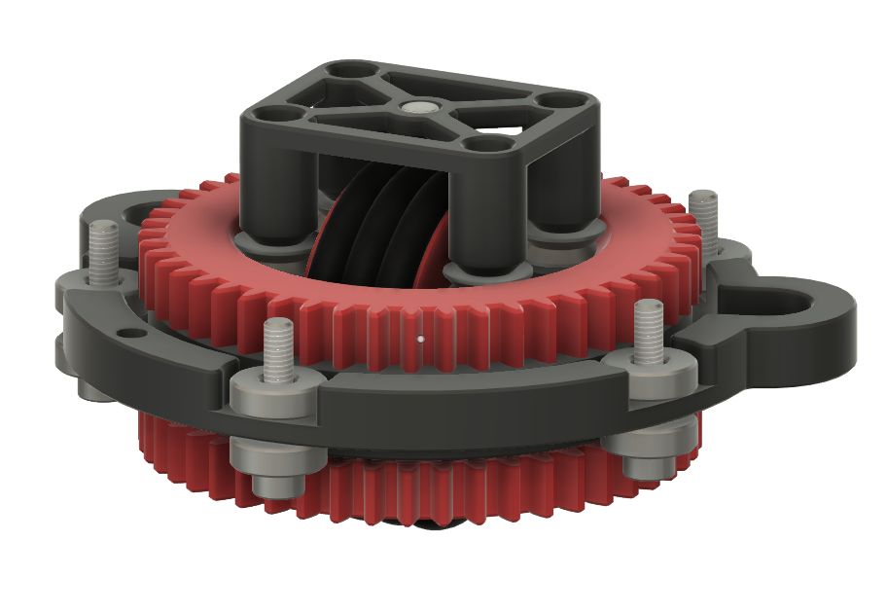
Pasted image 20250506124521.png
