notMarque/RomiOnSpeed/Pasted image 20250506124746.png

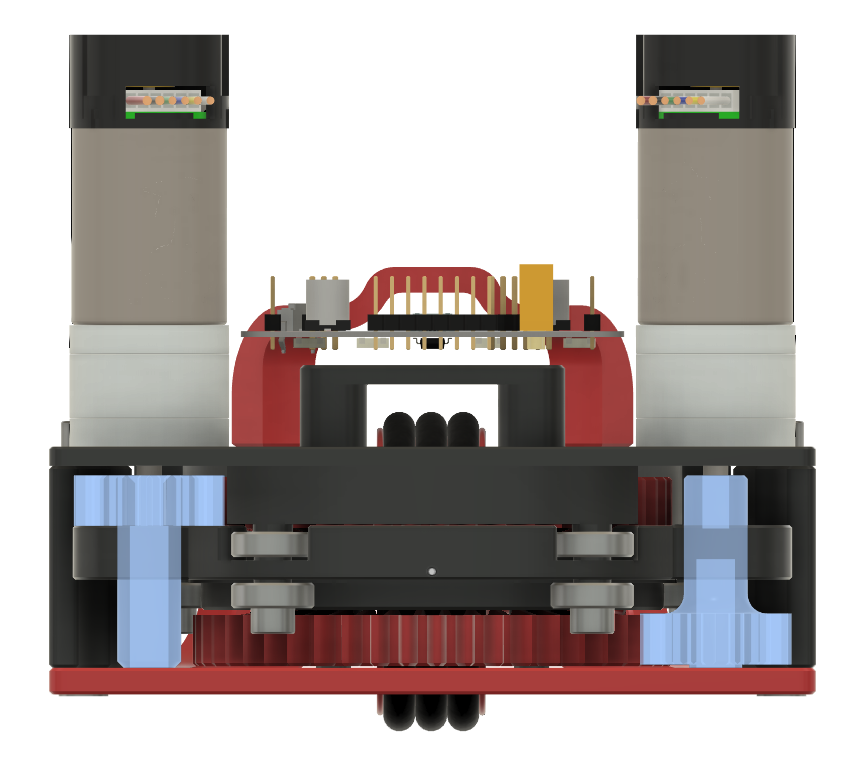
Pasted image 20250506124746.png
