notMarque/RomiOnSpeed/Pasted image 20250506153958.png

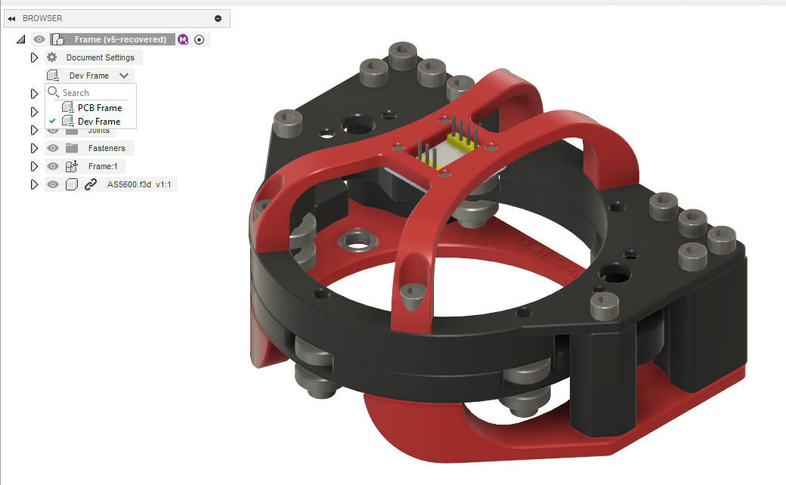
Pasted image 20250506153958.png
