notMarque/RomiOnSpeed/Pasted image 20250506154139.png

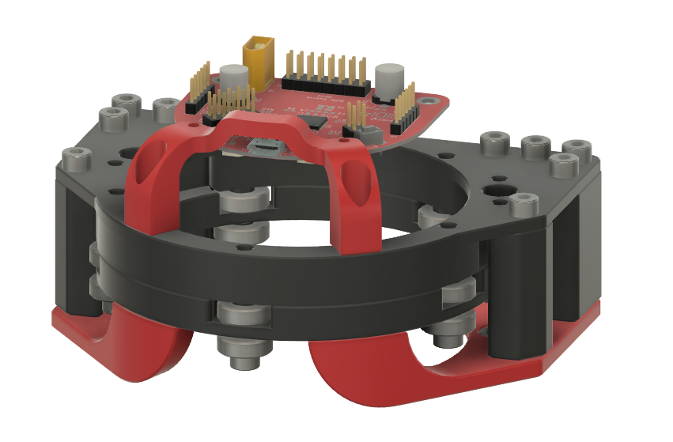
Pasted image 20250506154139.png
