notMarque/RomiOnSpeed/Pasted image 20250506154311.png

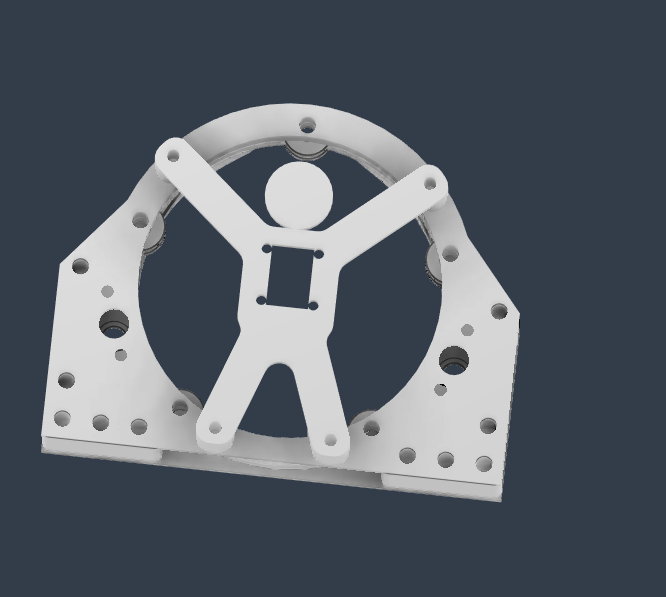
Pasted image 20250506154311.png
