notMarque/RomiOnSpeed/Pasted image 20250506154807.png

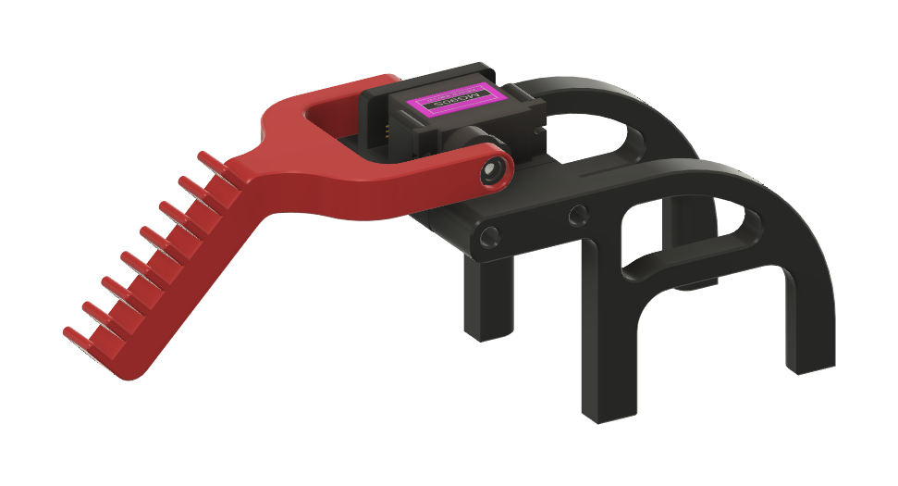
Pasted image 20250506154807.png
