notMarque/RomiOnSpeed/Pasted image 20250506155516.png

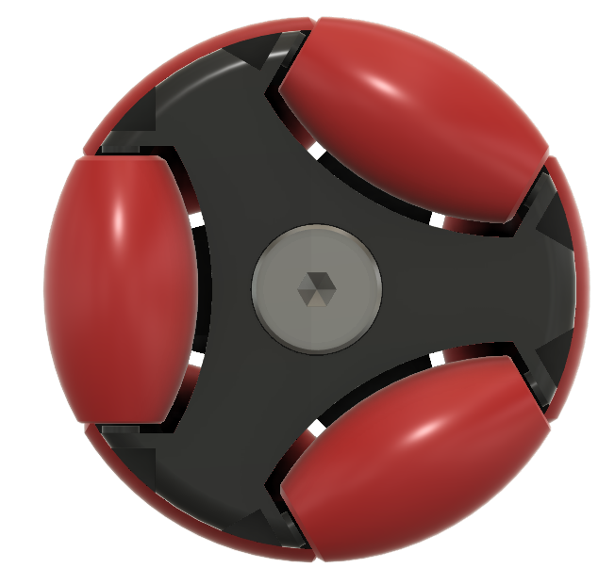
Pasted image 20250506155516.png
