notMarque/RomiOnSpeed/Pasted image 20250506160151.png

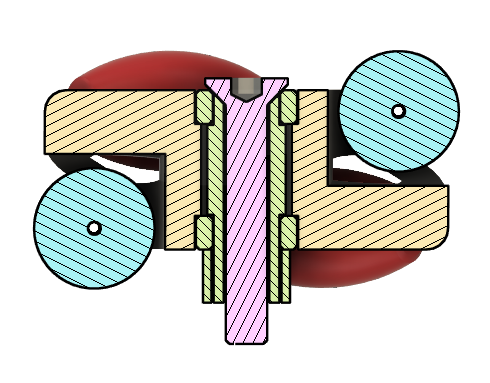
Pasted image 20250506160151.png
