notMarque/RomiOnSpeed/Pasted image 20250506160838.png

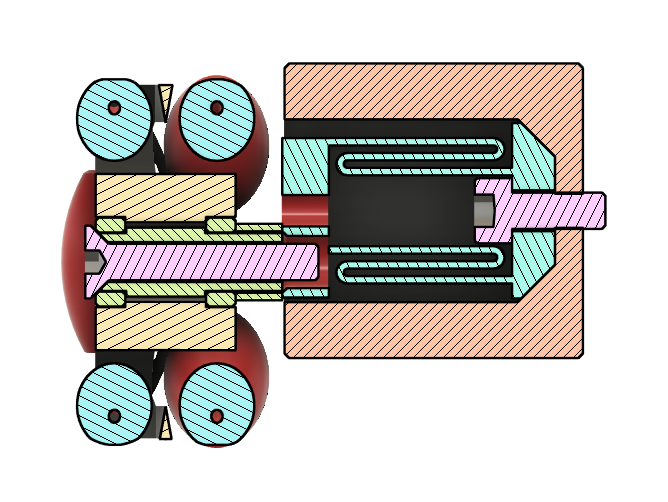
Pasted image 20250506160838.png
