notMarque/RomiOnSpeed/Pasted image 20250506160932.png

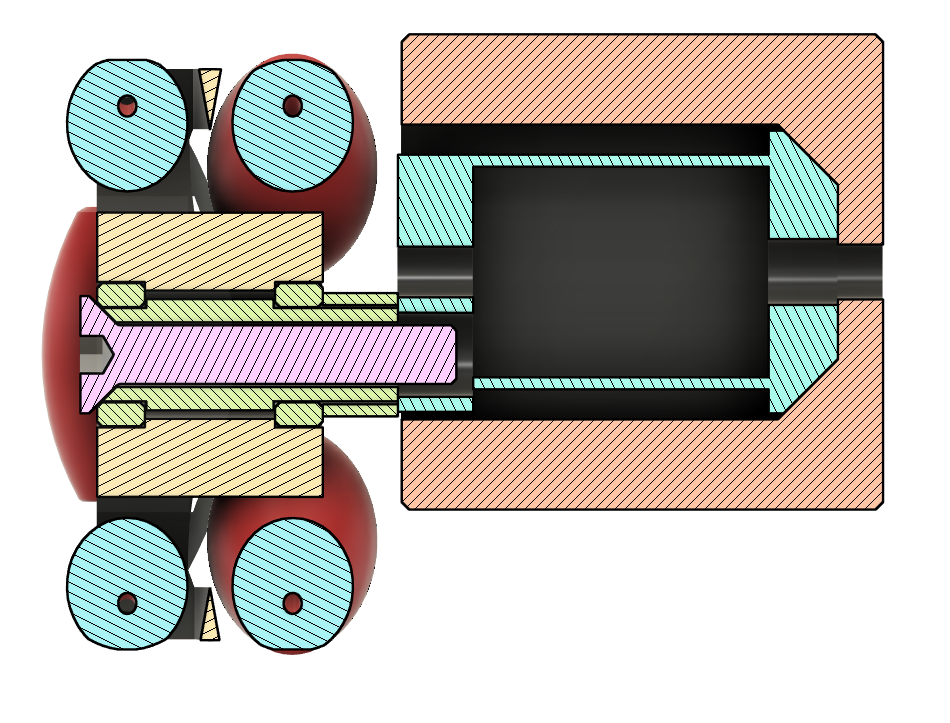
Pasted image 20250506160932.png
