notMarque/RomiOnSpeed/Pasted image 20250506161116.png

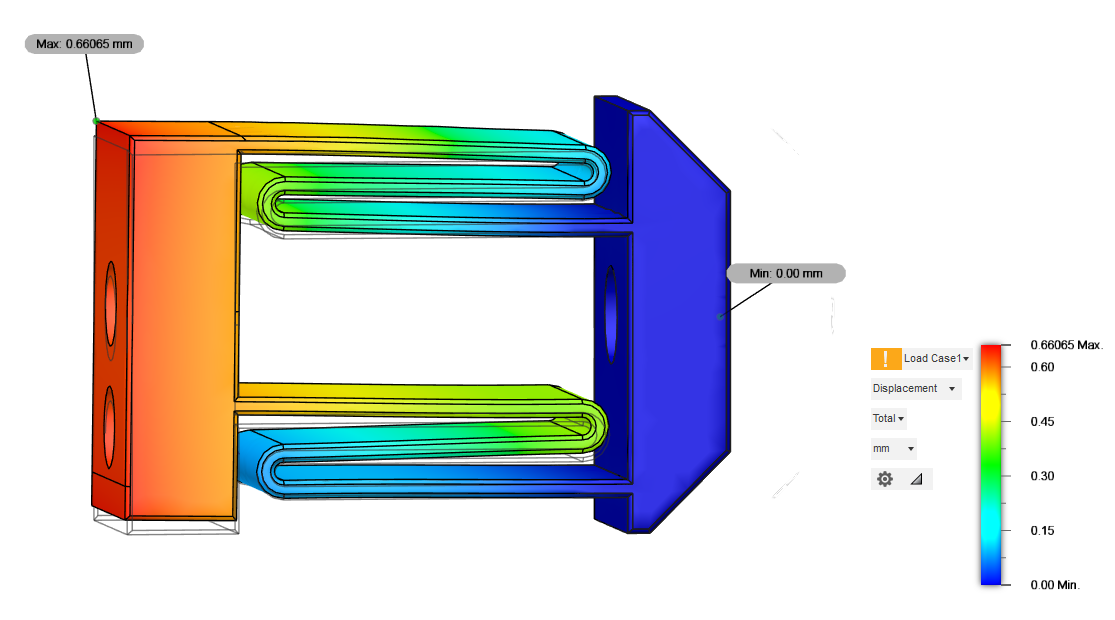
Pasted image 20250506161116.png
