notMarque/RomiOnSpeed/Pasted image 20250506161520.png

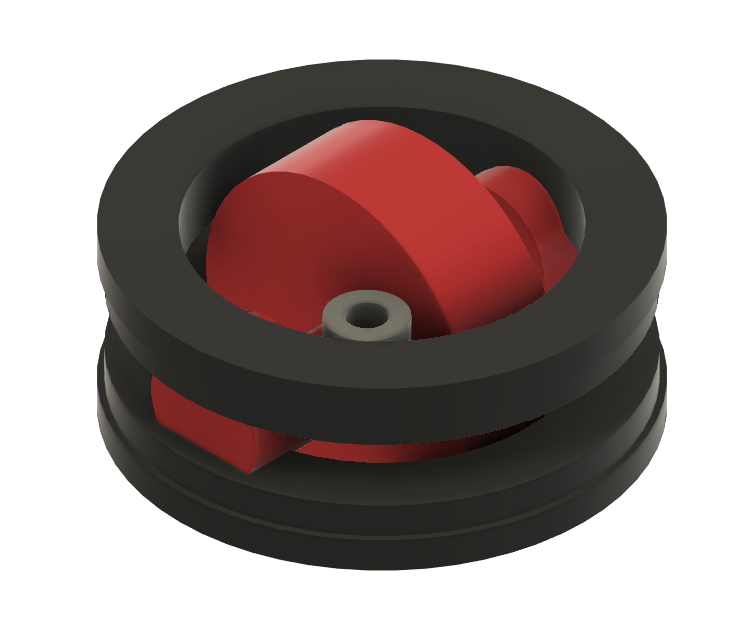
Pasted image 20250506161520.png
