notMarque/RomiOnSpeed/Pasted image 20250506161541.png

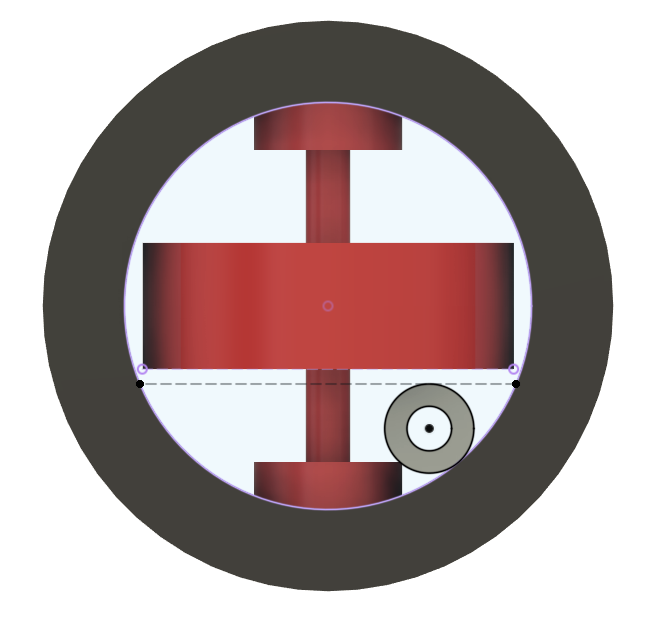
Pasted image 20250506161541.png
