notMarque/RomiOnSpeed/Pasted image 20250506161708.png

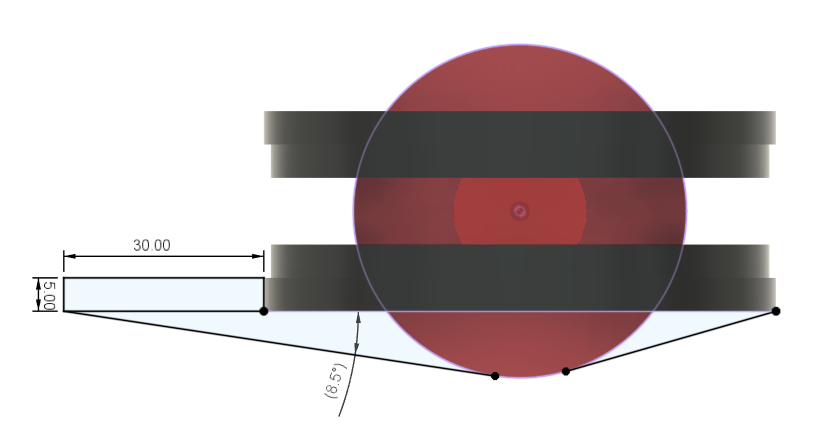
Pasted image 20250506161708.png
