notMarque/RomiOnSpeed/Pasted image 20250506162141.png

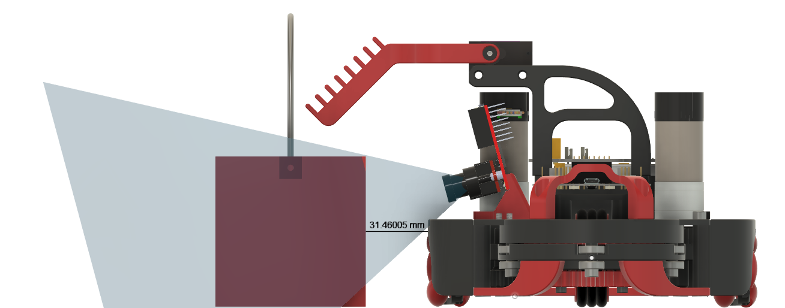
Pasted image 20250506162141.png
