notMarque/RomiOnSpeed/Pasted image 20250506163248.png

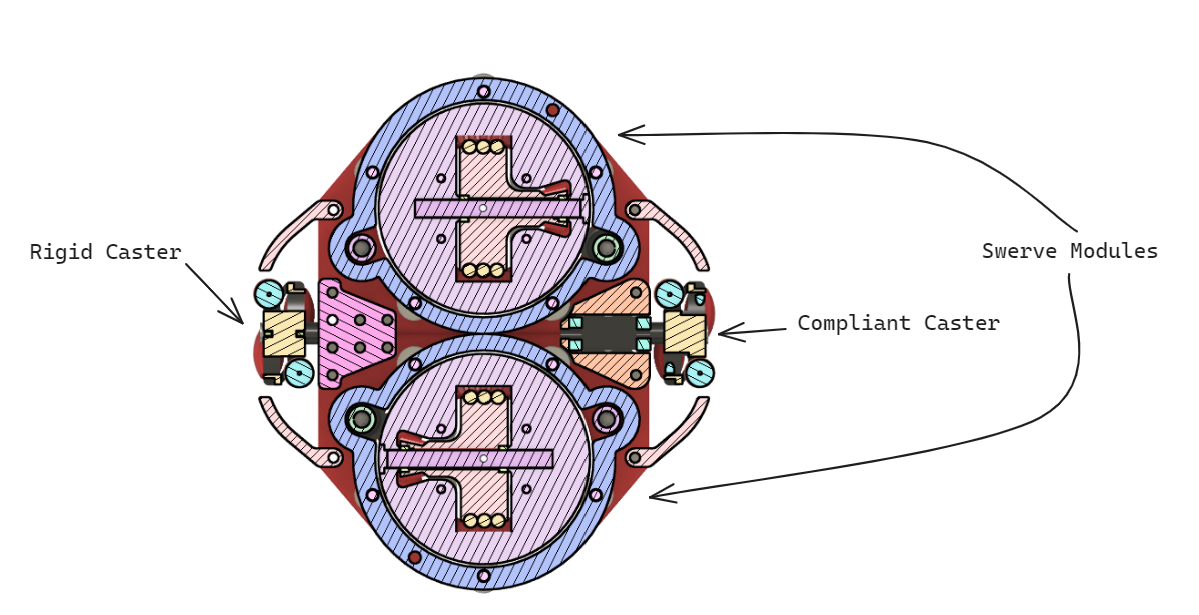
Pasted image 20250506163248.png
