notMarque/RomiOnSpeed/System/Images/Pasted image 20250407162528.png

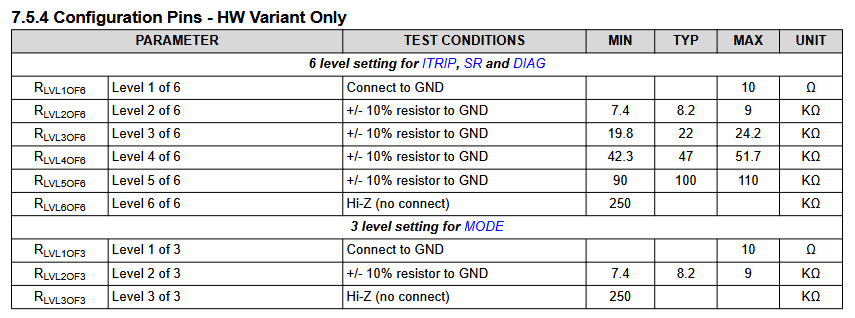
System/Images/Pasted image 20250407162528.png
