notMarque/RomiOnSpeed/System/Images/Pasted image 20250407211738.png

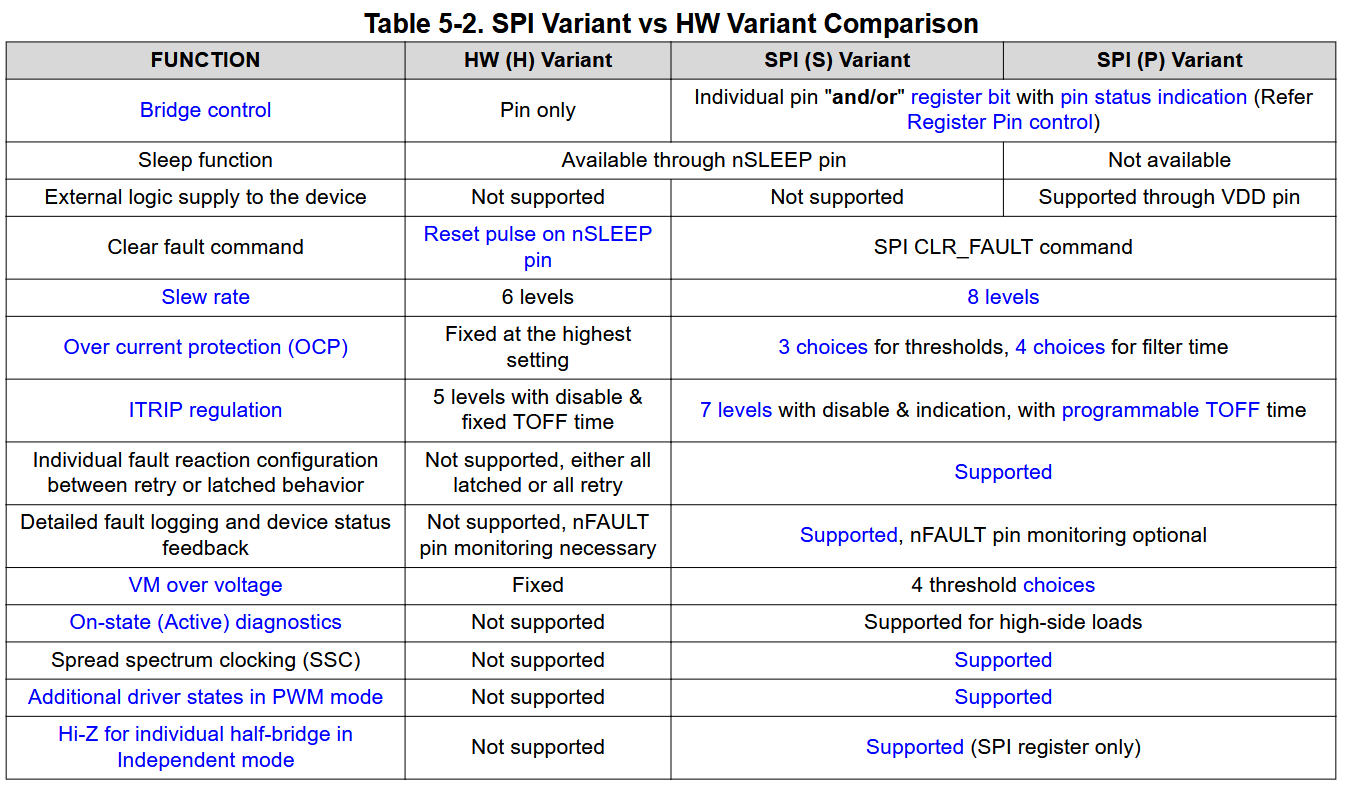
System/Images/Pasted image 20250407211738.png
