notMarque/RomiOnSpeed/System/Images/Pasted image 20250407212306.png

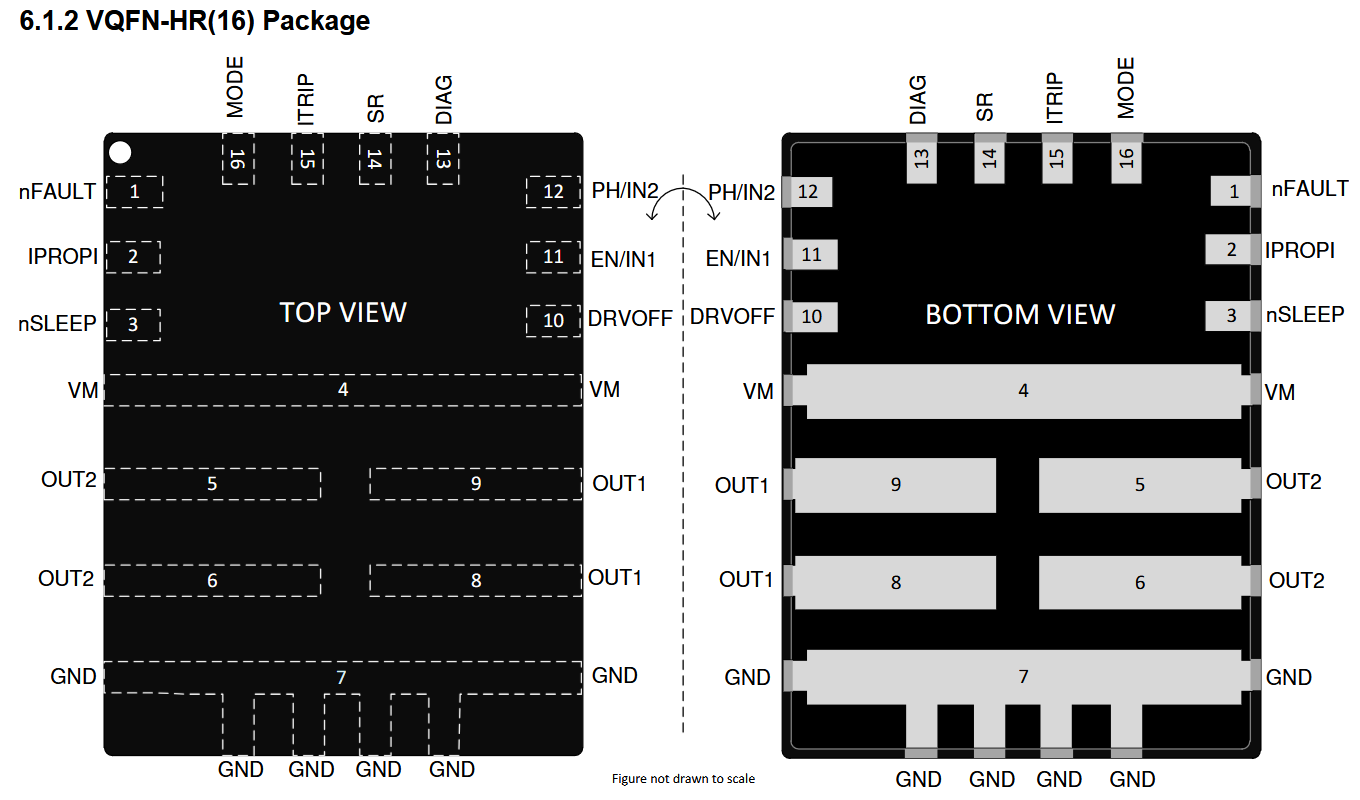
System/Images/Pasted image 20250407212306.png
