notMarque/RomiOnSpeed/System/Images/Pasted image 20250407212355.png

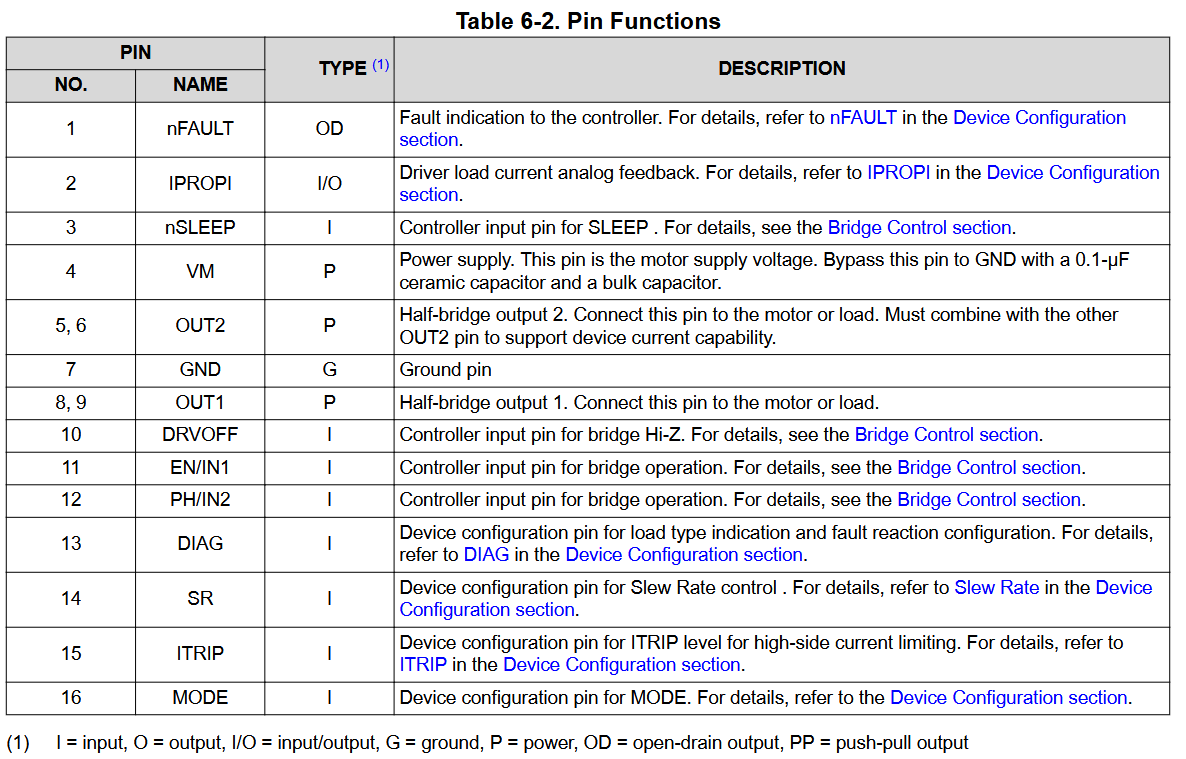
System/Images/Pasted image 20250407212355.png
