notMarque/RomiOnSpeed/System/Images/Pasted image 20250407212842.png

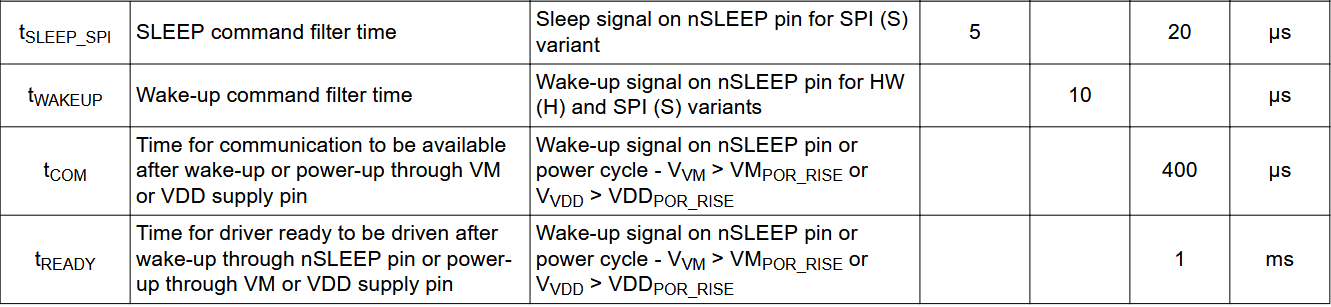
System/Images/Pasted image 20250407212842.png
