notMarque/RomiOnSpeed/System/Images/Pasted image 20250407213141.png

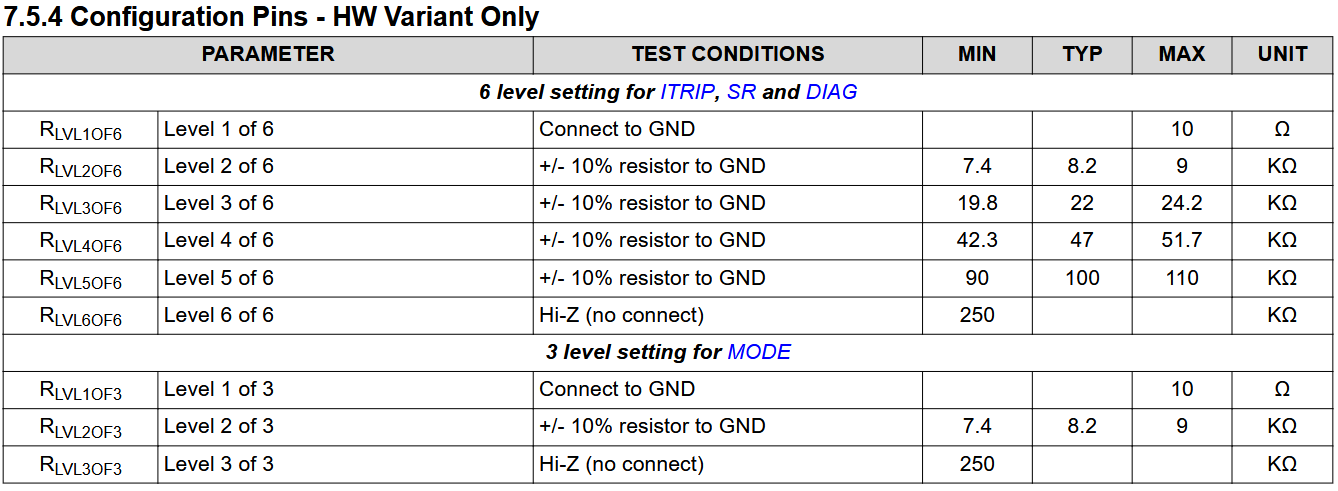
System/Images/Pasted image 20250407213141.png
