notMarque/RomiOnSpeed/System/Images/Pasted image 20250407213203.png

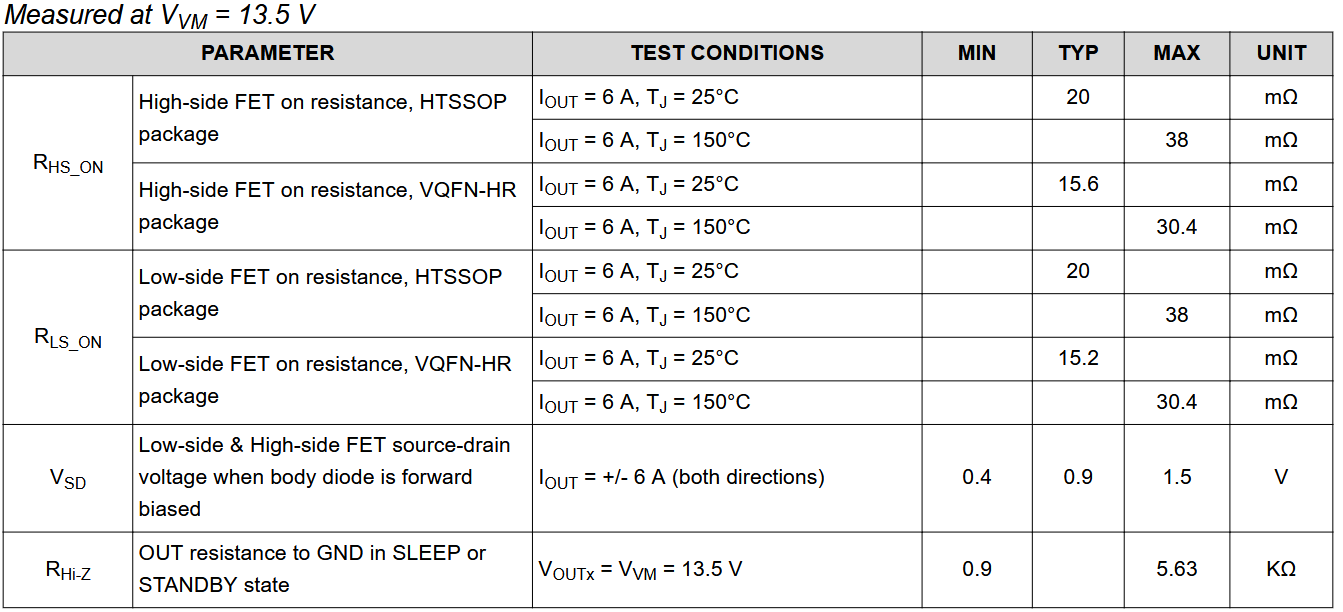
System/Images/Pasted image 20250407213203.png
