notMarque/RomiOnSpeed/System/Images/Pasted image 20250407213224.png

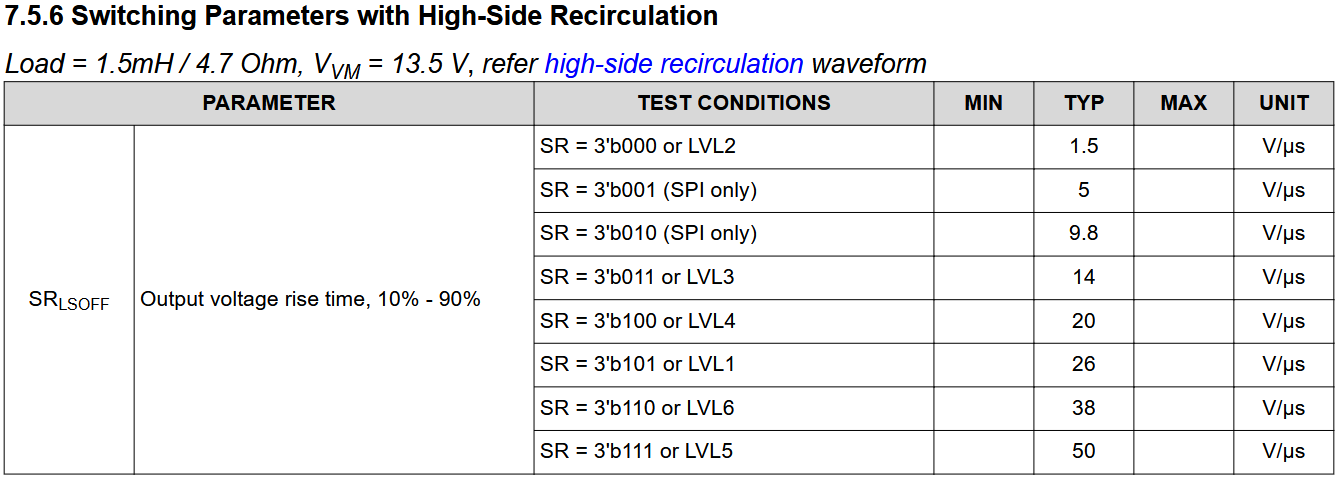
System/Images/Pasted image 20250407213224.png
