notMarque/RomiOnSpeed/System/Images/Pasted image 20250407213239.png

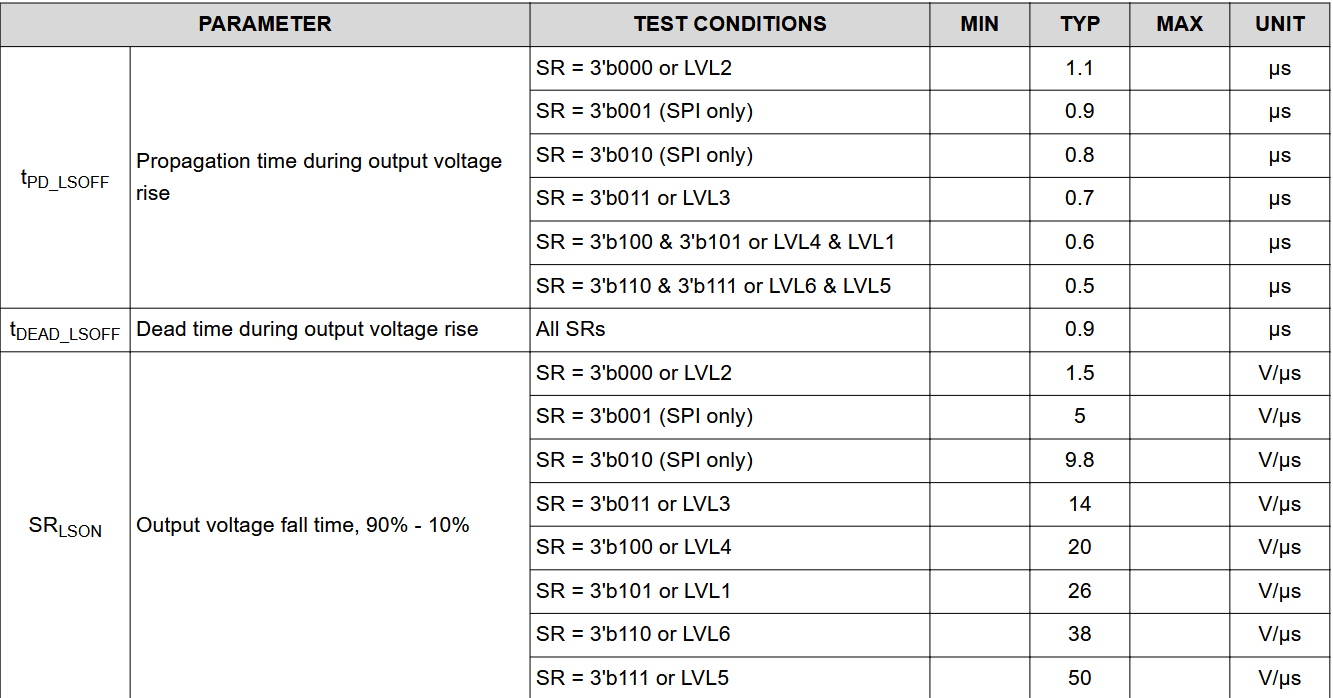
System/Images/Pasted image 20250407213239.png
