notMarque/RomiOnSpeed/System/Images/Pasted image 20250407213257.png

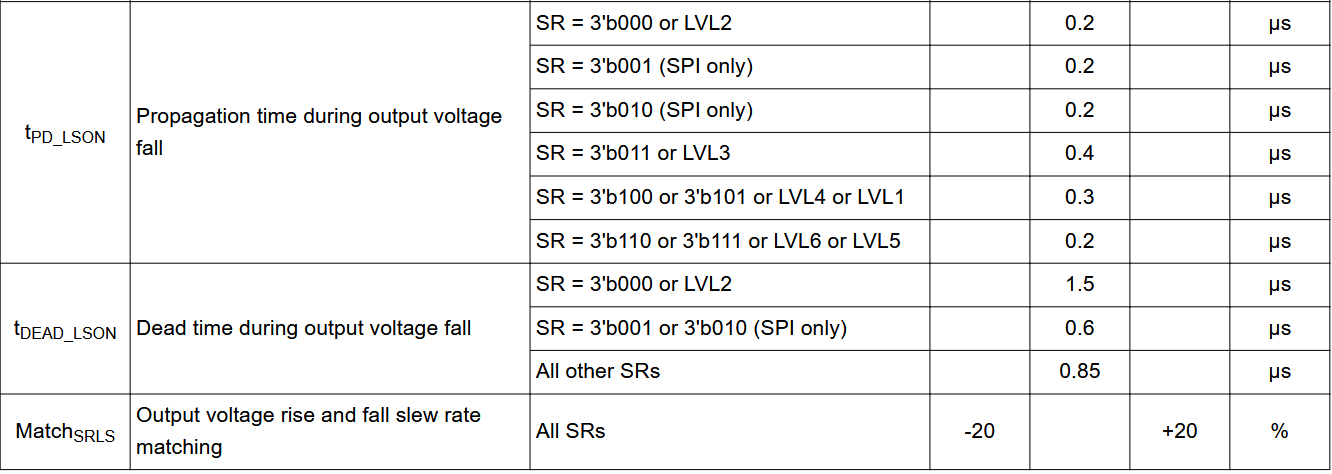
System/Images/Pasted image 20250407213257.png
