notMarque/RomiOnSpeed/System/Images/Pasted image 20250407213844.png

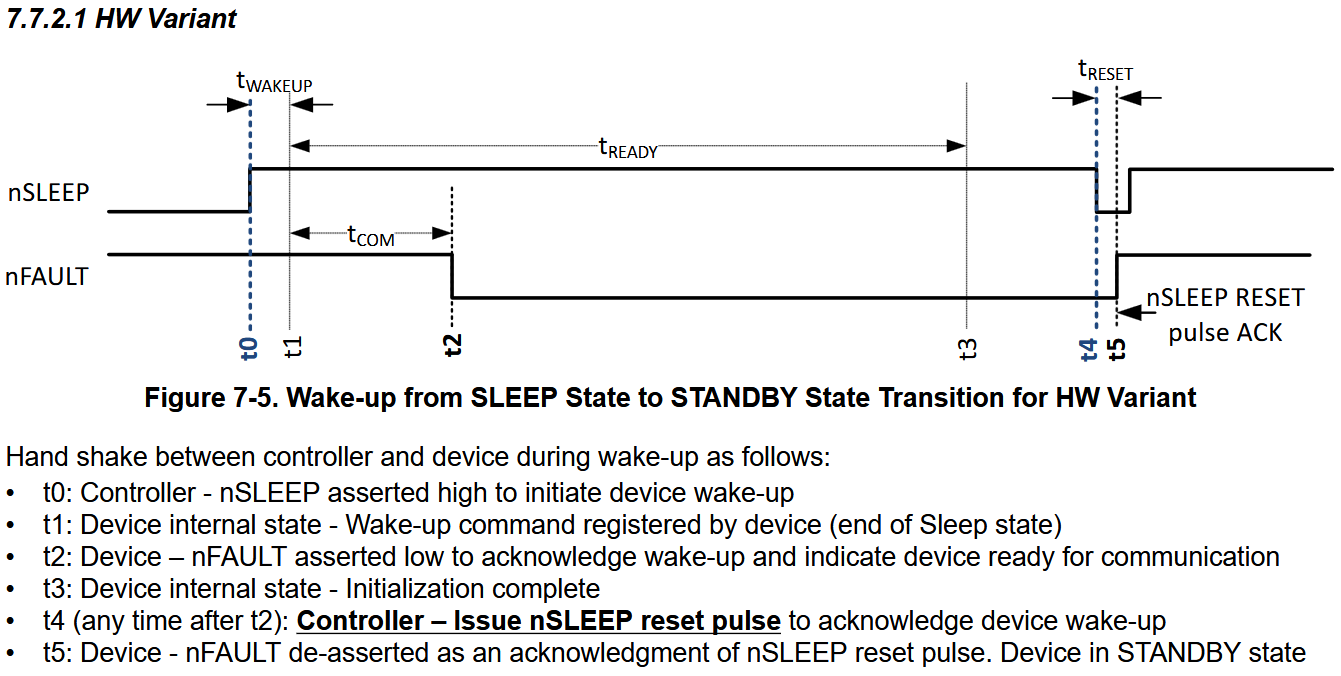
System/Images/Pasted image 20250407213844.png
