notMarque/RomiOnSpeed/System/Images/Pasted image 20250407214241.png

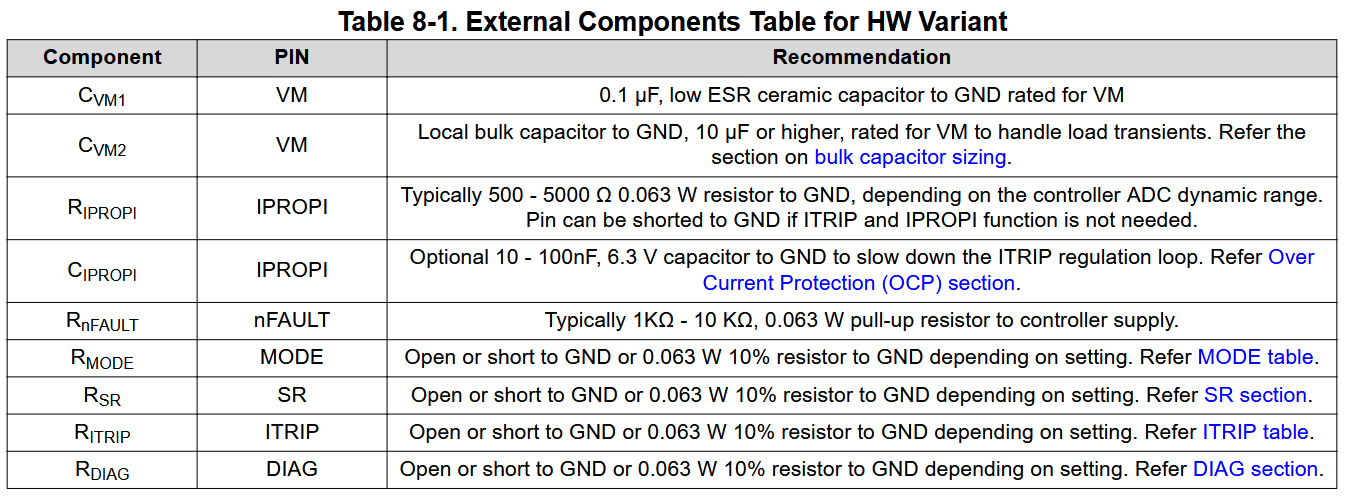
System/Images/Pasted image 20250407214241.png
