notMarque/RomiOnSpeed/System/Images/Pasted image 20250407214331.png

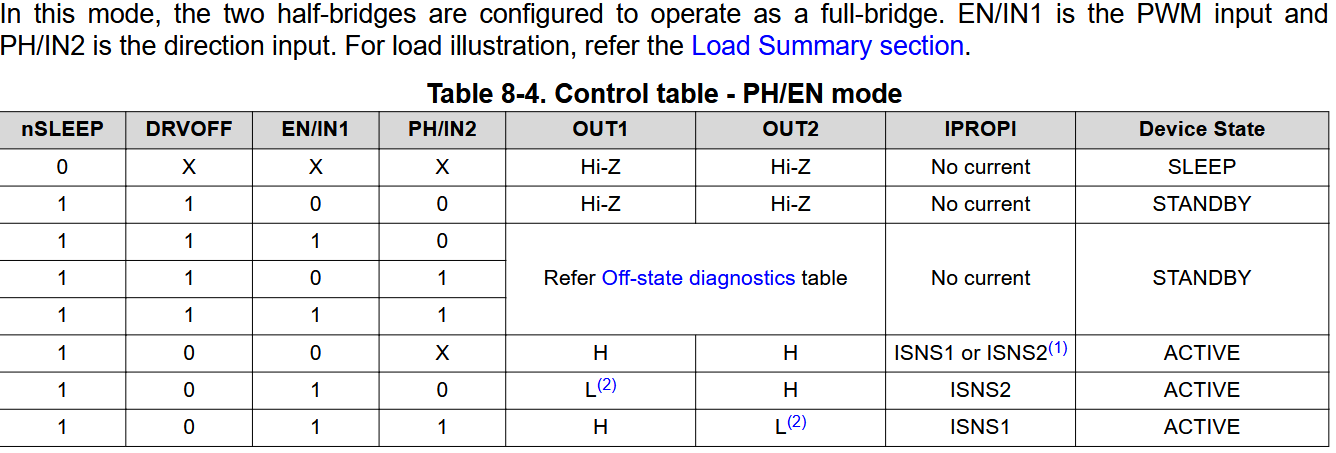
System/Images/Pasted image 20250407214331.png
