notMarque/RomiOnSpeed/System/Images/Pasted image 20250407214352.png

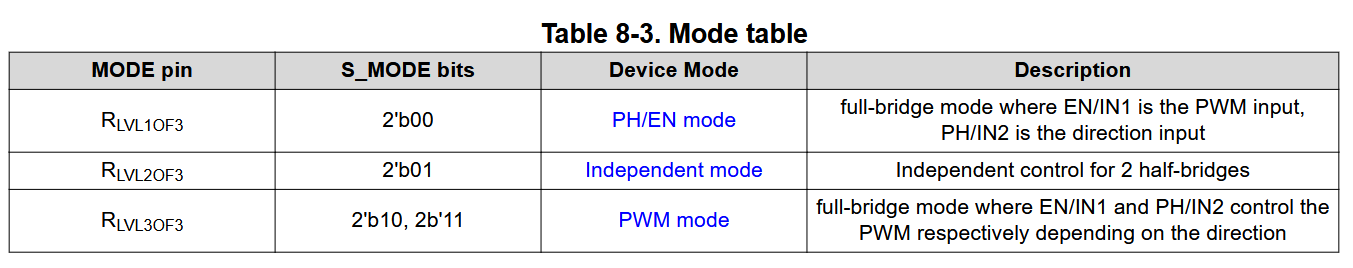
System/Images/Pasted image 20250407214352.png
