notMarque/RomiOnSpeed/System/Images/Pasted image 20250407214416.png

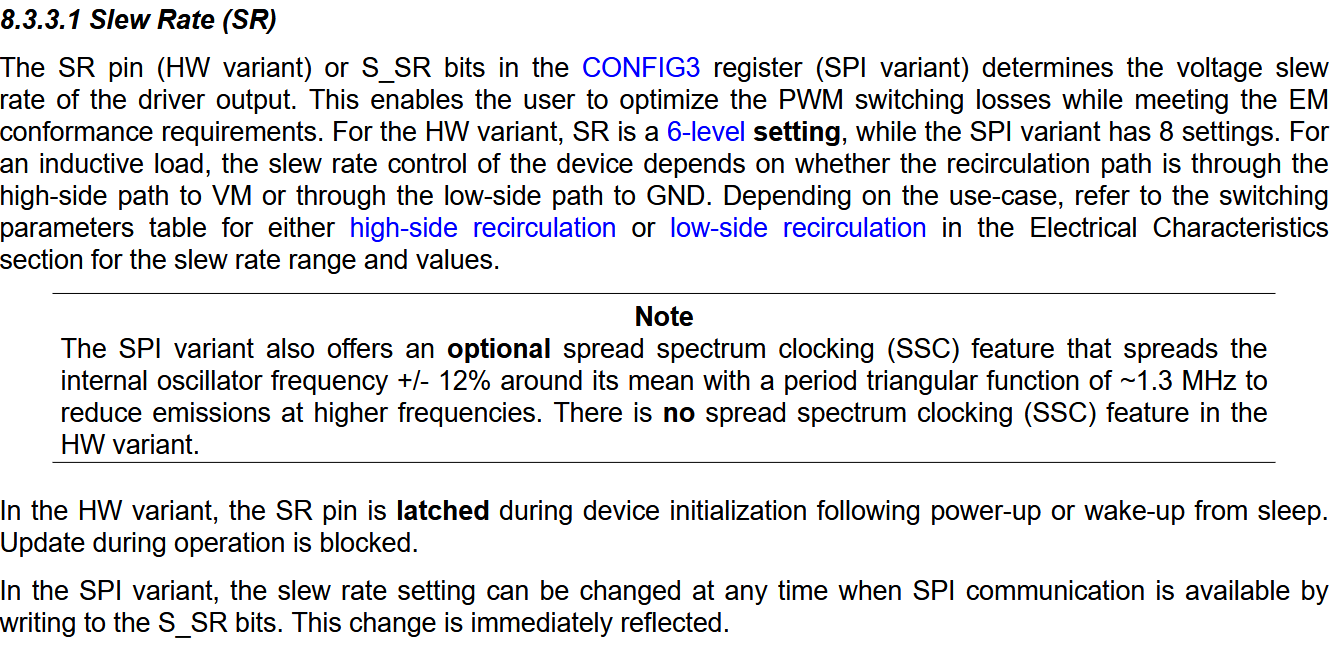
System/Images/Pasted image 20250407214416.png
