notMarque/RomiOnSpeed/System/Images/Pasted image 20250407214719.png

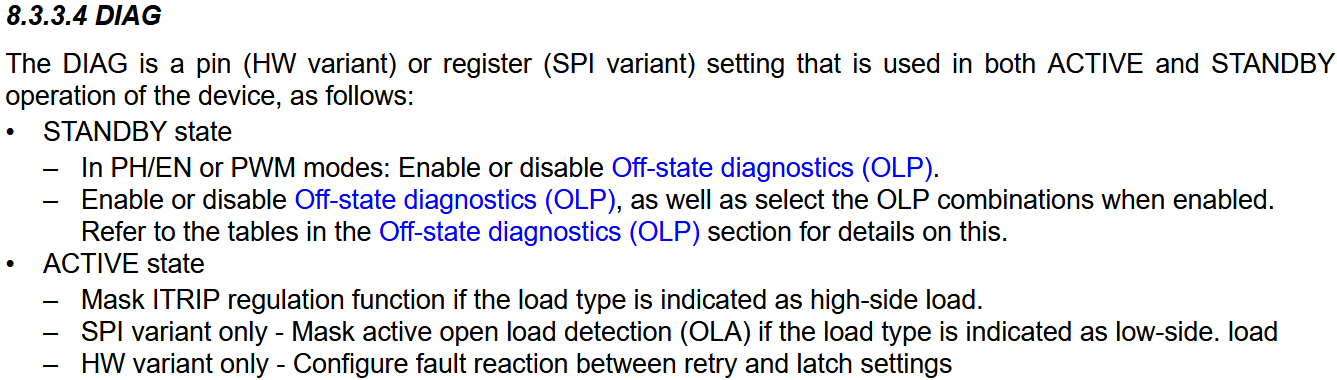
System/Images/Pasted image 20250407214719.png
