notMarque/RomiOnSpeed/System/Images/Pasted image 20250407214734.png

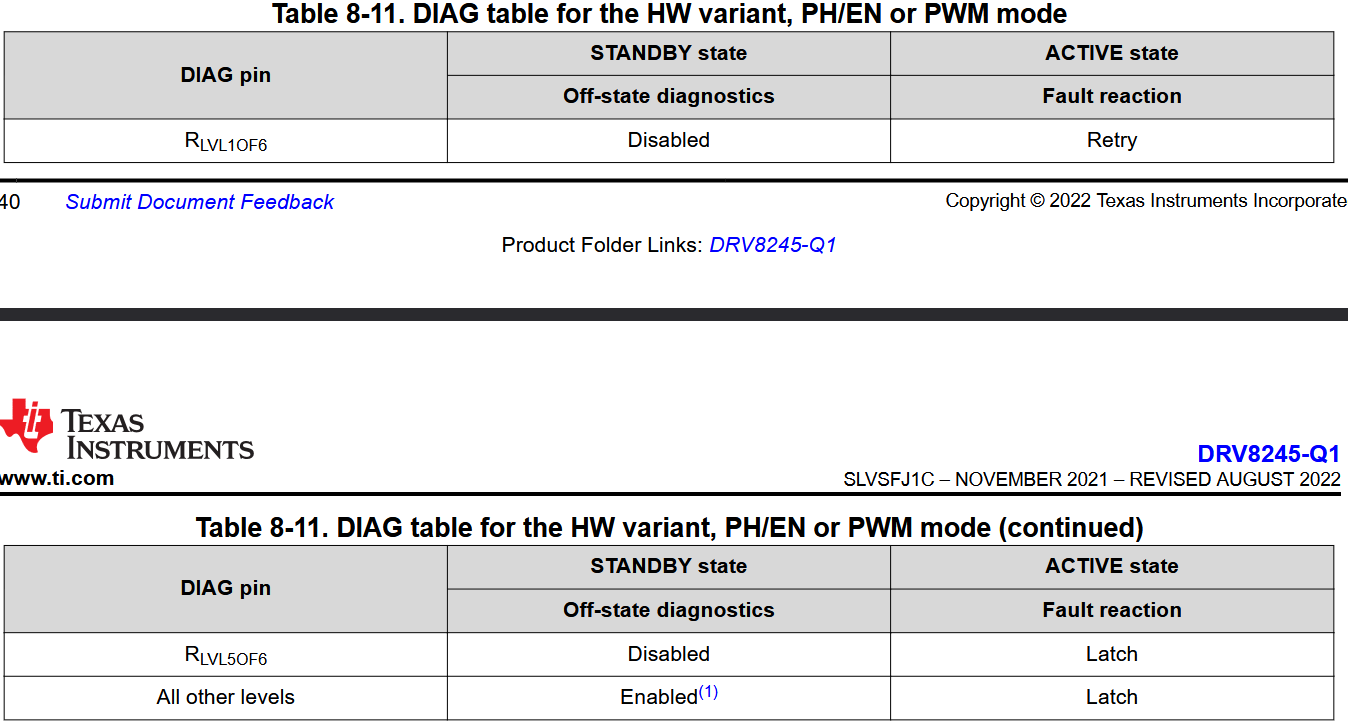
System/Images/Pasted image 20250407214734.png
