notMarque/RomiOnSpeed/System/Images/Pasted image 20250407221133.png

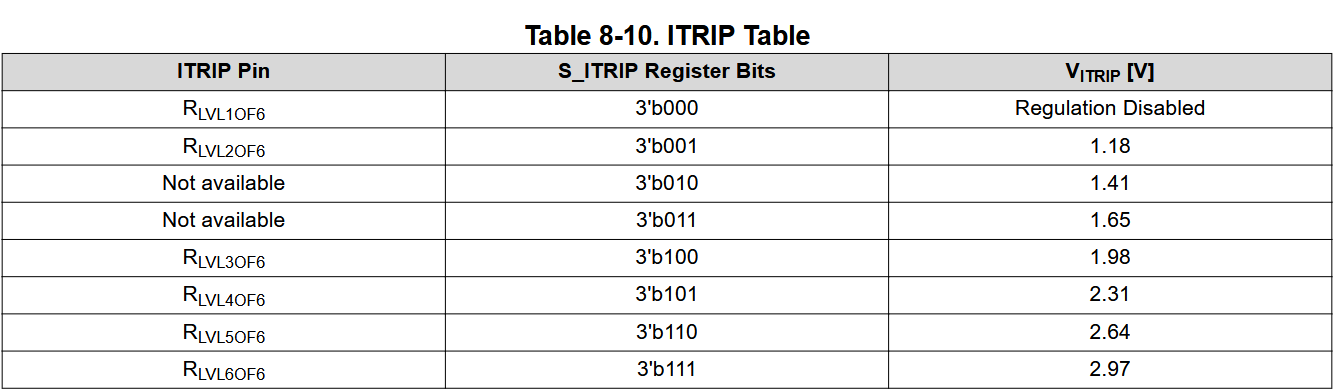
System/Images/Pasted image 20250407221133.png
