notMarque/RomiOnSpeed/Mechanical/Manufacturing Files v1/1xMain Plate(Seperate)(Support) v1.step

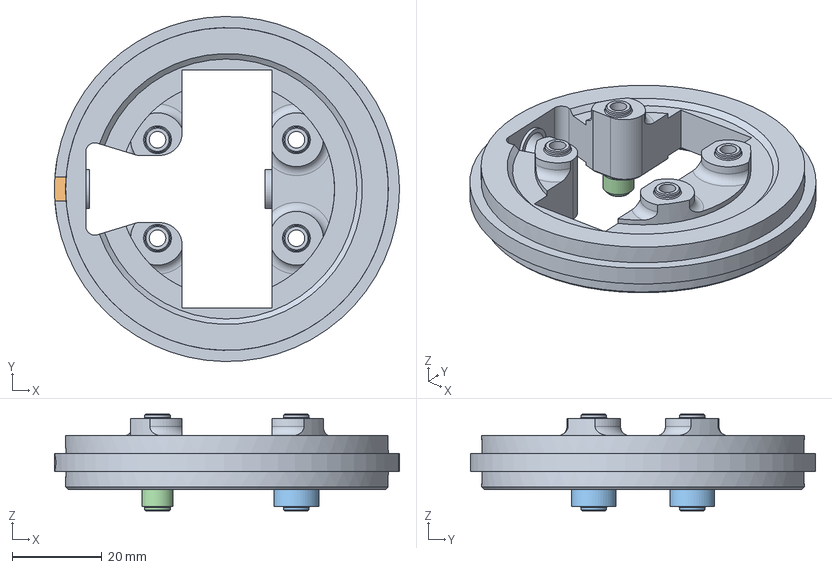
[picture p45: CAD file, 2025-04-14]
Mechanical/Manufacturing Files v1/1xMain Plate(Seperate)(Support) v1.step
77.0 x 77.0 x 21.6 mm
