notMarque/RomiOnSpeed/Mechanical/Manufacturing Files v1/1xPlate Standoff(Seperate (4 total))v1.step

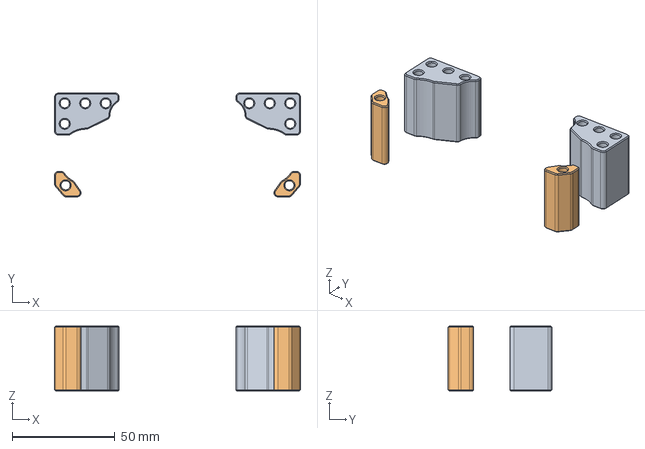
[picture p46: CAD file, 2025-04-14]
Mechanical/Manufacturing Files v1/1xPlate Standoff(Seperate (4 total))v1.step
120.0 x 50.7 x 31.6 mm
