notMarque/RomiOnSpeed/Mechanical/Manufacturing Files v1/1xEncoder Mount(Support)v1.step

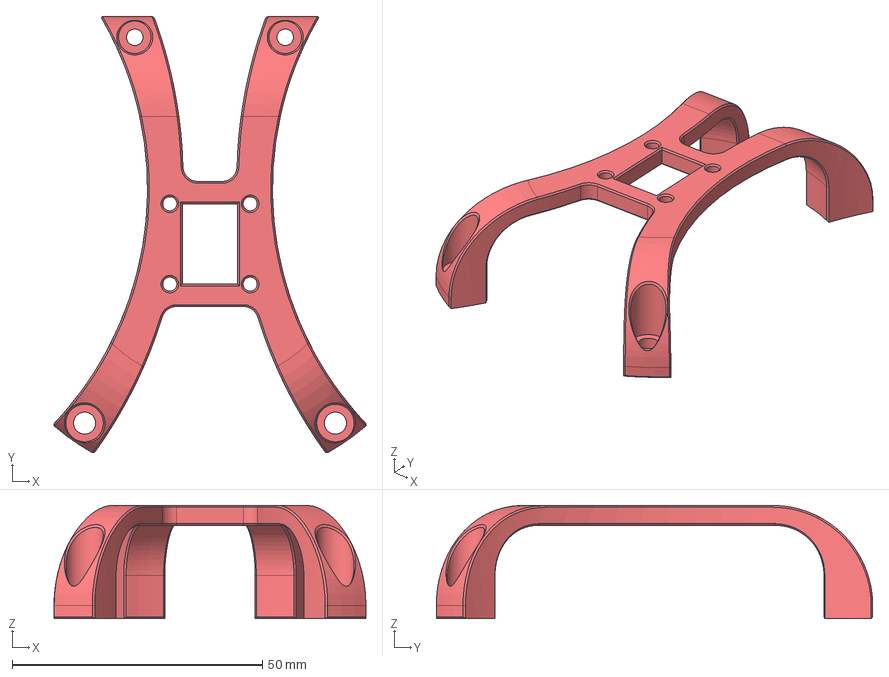
[picture p47: CAD file, 2025-04-14]
Mechanical/Manufacturing Files v1/1xEncoder Mount(Support)v1.step
62.3 x 87.2 x 22.6 mm
