notMarque/RomiOnSpeed/PCBs/Main Board/MainBoardPCB/3dModels/ESP32-S3-WROOM-1-N8.STEP

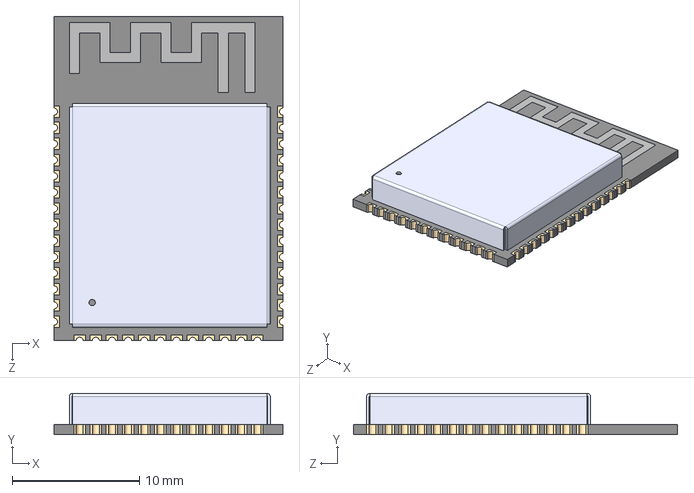
[picture p48: CAD file, 2025-04-26]
PCBs/Main Board/MainBoardPCB/3dModels/ESP32-S3-WROOM-1-N8.STEP
18.0 x 3.25 x 25.5 mm
