notMarque/RomiOnSpeed/PCBs/ModuleBoard/3dmodels/APXE160ARA101MH70G/CAP_E61_CHC.step

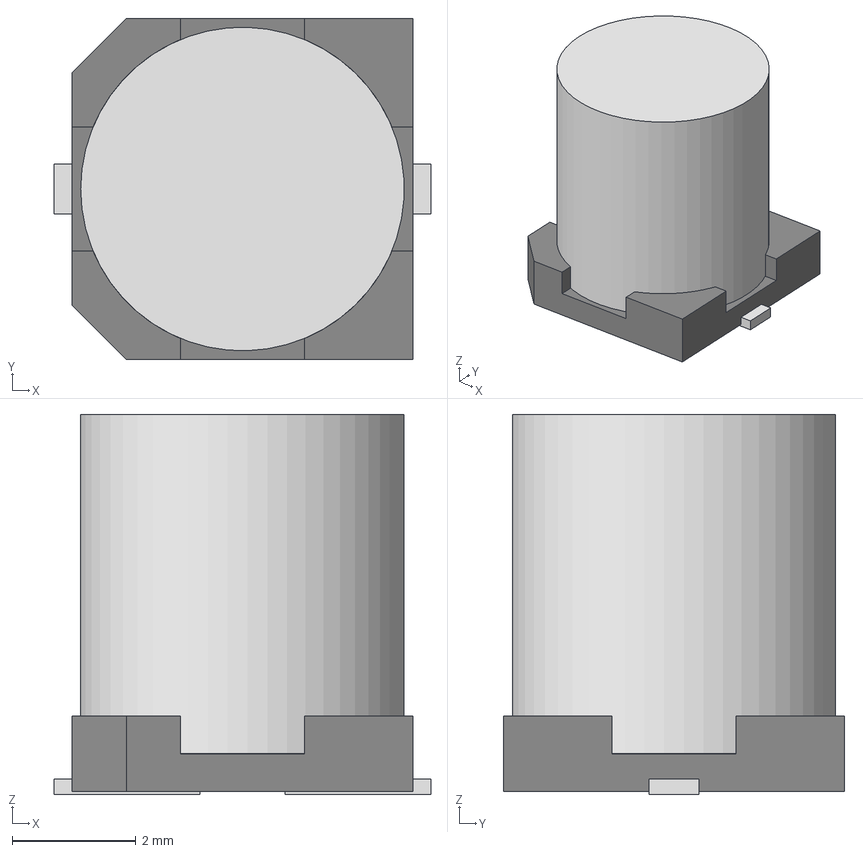
[picture p49: CAD file, 2025-04-26]
PCBs/ModuleBoard/3dmodels/APXE160ARA101MH70G/CAP_E61_CHC.step
6.10 x 5.51 x 6.15 mm
