notMarque/RomiOnSpeed/PCBs/ModuleBoard/Lubraries/AS5600-ASOT/AS5600-ASOT.step

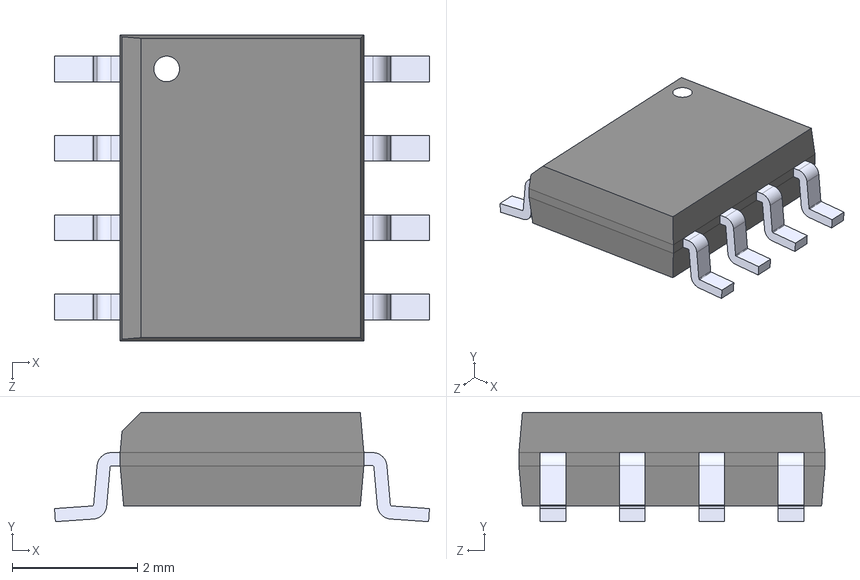
[picture p50: CAD file, 2025-04-26]
PCBs/ModuleBoard/Lubraries/AS5600-ASOT/AS5600-ASOT.step
6.00 x 1.75 x 4.90 mm
