notMarque/RomiOnSpeed/PCBs/ModuleBoard/Lubraries/DRV8243HQDGQRQ1/RXZ0016A.stp

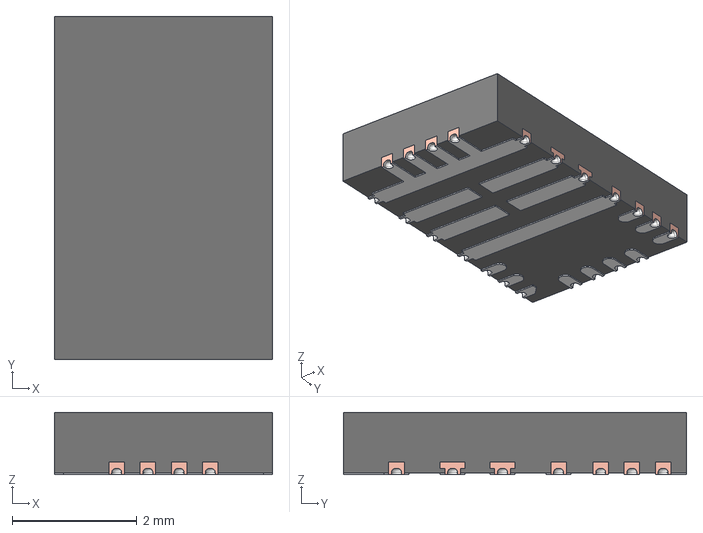
[picture p51: CAD file, 2025-04-26]
PCBs/ModuleBoard/Lubraries/DRV8243HQDGQRQ1/RXZ0016A.stp
3.50 x 5.50 x 1.00 mm
FRAME
MOLD
