notMarque/RomiOnSpeed/PCBs/ModuleBoard/Lubraries/TPS63051RMWR/RMW0012A.stp

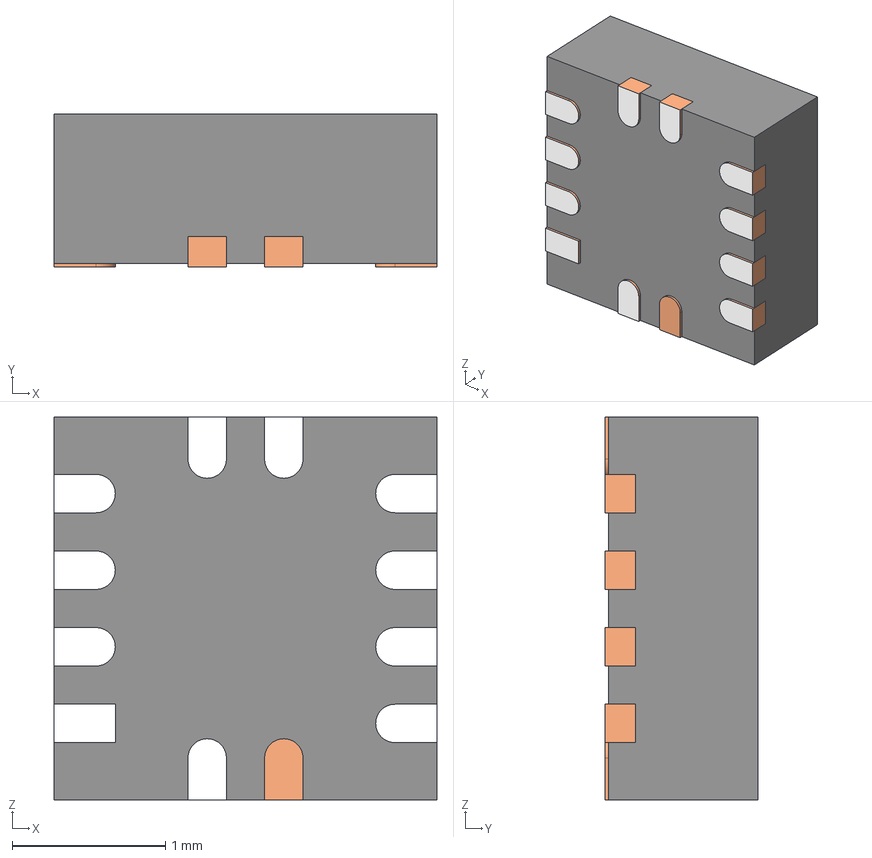
[picture p52: CAD file, 2025-04-26]
PCBs/ModuleBoard/Lubraries/TPS63051RMWR/RMW0012A.stp
2.50 x 1.00 x 2.50 mm
FRAME-RMW0012A
BODY-QFN
