notMarque/RomiOnSpeed/PCBs/Main Board/MainBoardPCB/3dModels/SOT-23-5_M5_MCH.step

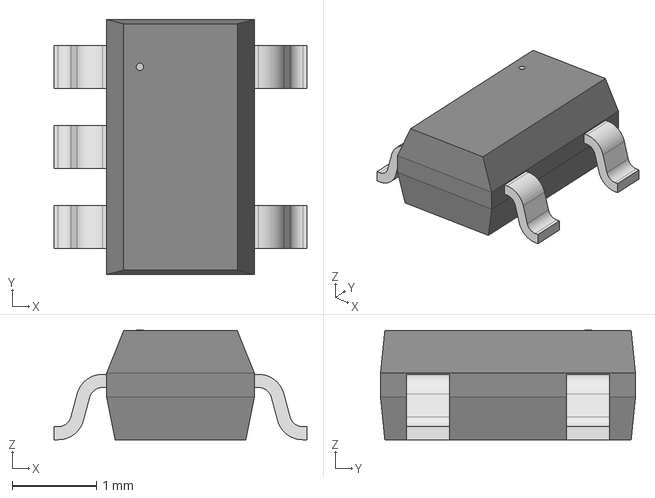
[picture p53: CAD file, 2025-04-26]
PCBs/Main Board/MainBoardPCB/3dModels/SOT-23-5_M5_MCH.step
3.00 x 3.02 x 1.30 mm
