notMarque/RomiOnSpeed/Mechanical/Manufacturing Files v1/1xTop Pinion v1.step

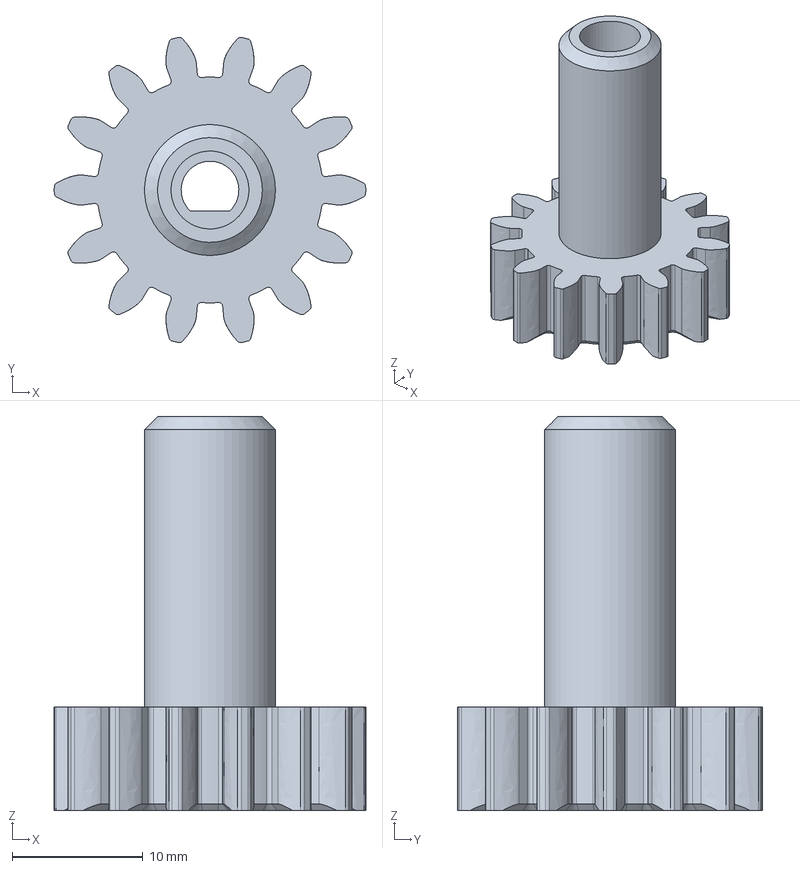
[picture p54: CAD file, 2025-04-14]
Mechanical/Manufacturing Files v1/1xTop Pinion v1.step
23.8 x 23.3 x 30.1 mm
