notMarque/RomiOnSpeed/PCBs/Main Board/MainBoardPCB/3dModels/AMASS_XT60-M_1x02_P7.2mm_Vertical.step

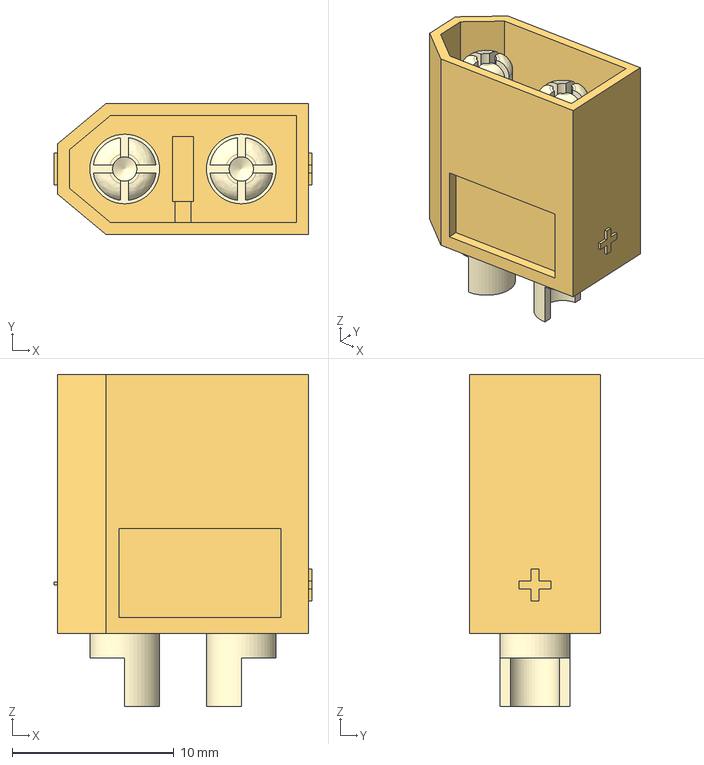
[picture p55: CAD file, 2025-04-26]
PCBs/Main Board/MainBoardPCB/3dModels/AMASS_XT60-M_1x02_P7.2mm_Vertical.step
15.9 x 8.10 x 20.5 mm
