notMarque/RomiOnSpeed/Mechanical/Manufacturing Files v1/1xMagnetHolder v1.step

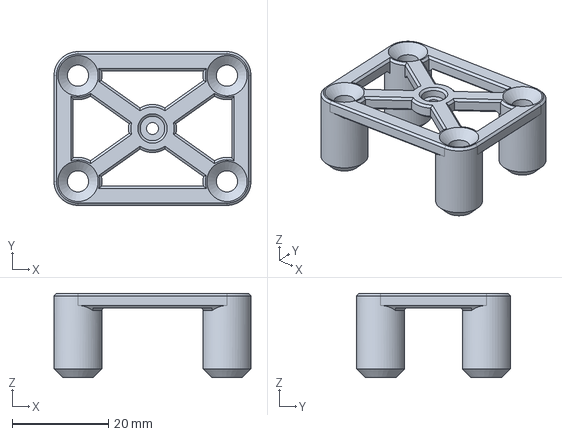
[picture p56: CAD file, 2025-04-14]
Mechanical/Manufacturing Files v1/1xMagnetHolder v1.step
41.0 x 32.0 x 17.5 mm
