notMarque/RomiOnSpeed/PCBs/Main Board/MainBoardPCB/3dModels/SOIC_128JVSIQ_WIN.step

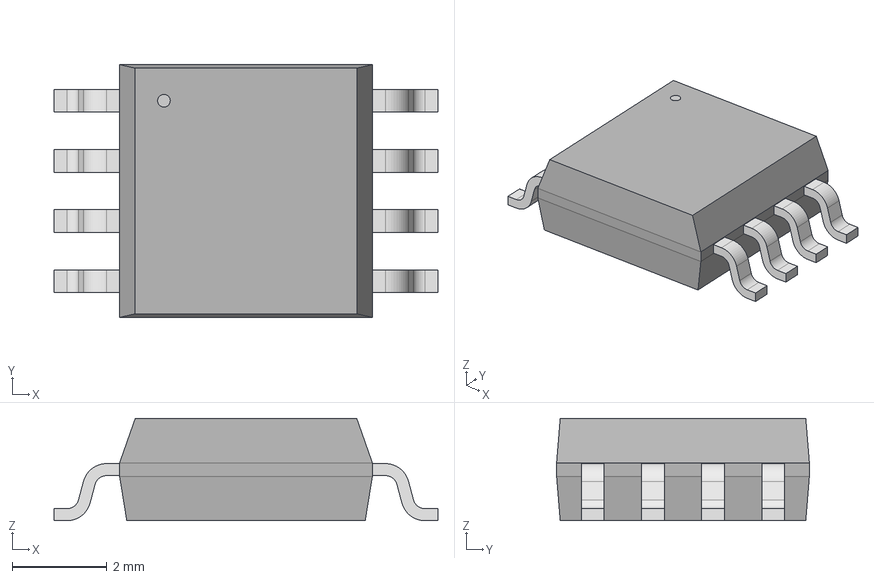
[picture p57: CAD file, 2025-04-26]
PCBs/Main Board/MainBoardPCB/3dModels/SOIC_128JVSIQ_WIN.step
8.10 x 5.33 x 2.16 mm
