notMarque/RomiOnSpeed/Mechanical/Manufacturing Files v1/1xWheel Body v1.step

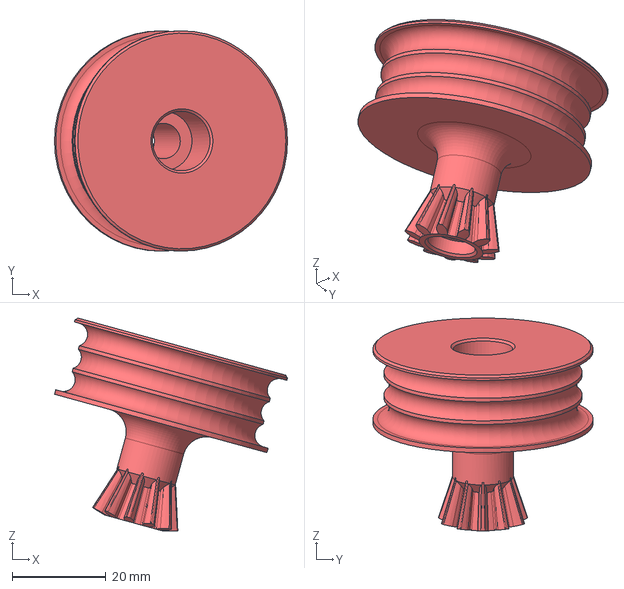
[picture p58: CAD file, 2025-04-14]
Mechanical/Manufacturing Files v1/1xWheel Body v1.step
49.7 x 47.0 x 45.4 mm
