notMarque/RomiOnSpeed/PCBs/Main Board/MainBoardPCB/3dModels/LGA14-L_2P59X3P1X0P5_STM.step

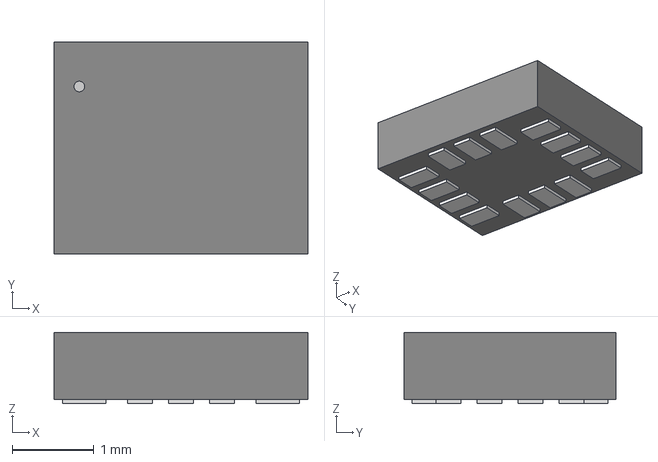
[picture p59: CAD file, 2025-04-26]
PCBs/Main Board/MainBoardPCB/3dModels/LGA14-L_2P59X3P1X0P5_STM.step
3.10 x 2.59 x 0.866 mm
