notMarque/RomiOnSpeed/PCBs/Main Board/MainBoardPCB/3dModels/spm6530.step

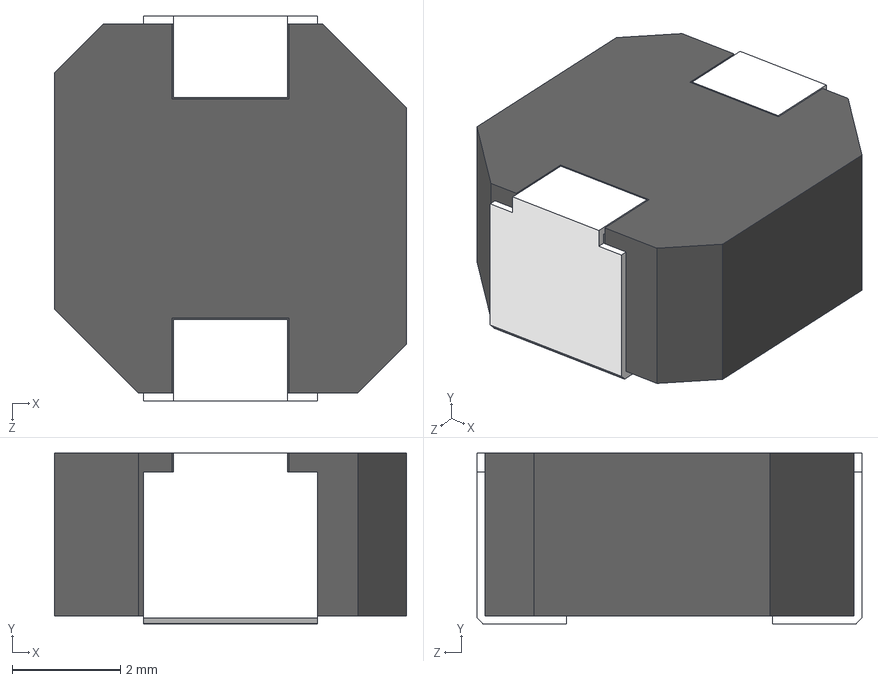
[picture p60: CAD file, 2025-04-26]
PCBs/Main Board/MainBoardPCB/3dModels/spm6530.step
6.50 x 3.15 x 7.10 mm
