notMarque/RomiOnSpeed/Mechanical/Manufacturing Files v1/10xBearing Holderv1.step

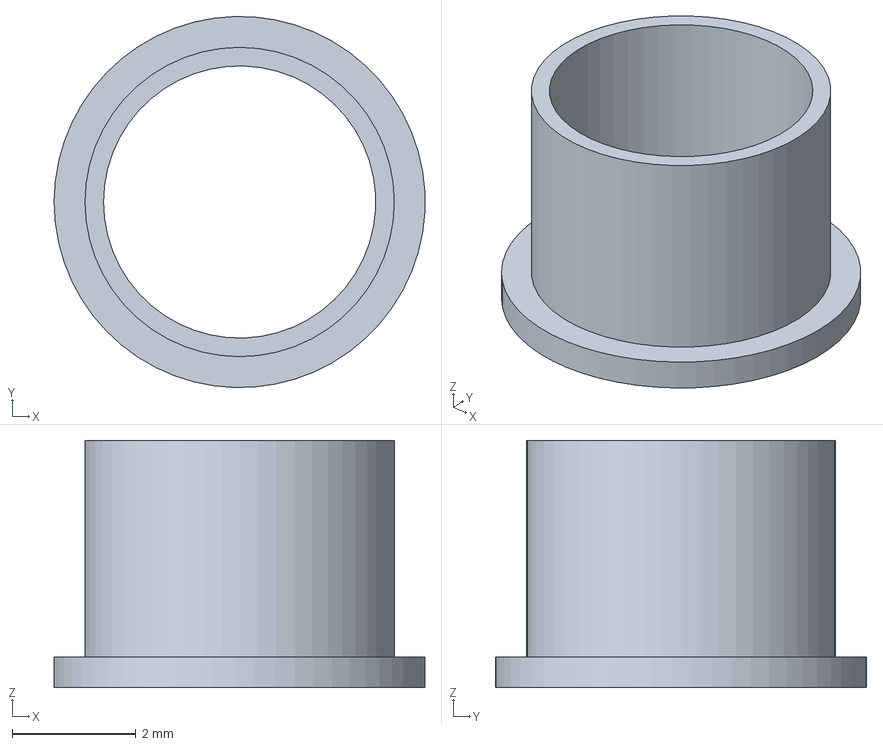
[picture p61: CAD file, 2025-04-14]
Mechanical/Manufacturing Files v1/10xBearing Holderv1.step
6.00 x 6.00 x 4.00 mm
