notMarque/RomiOnSpeed/Mechanical/Manufacturing Files v1/1xSub Frame(Support Maybe)v1.stl

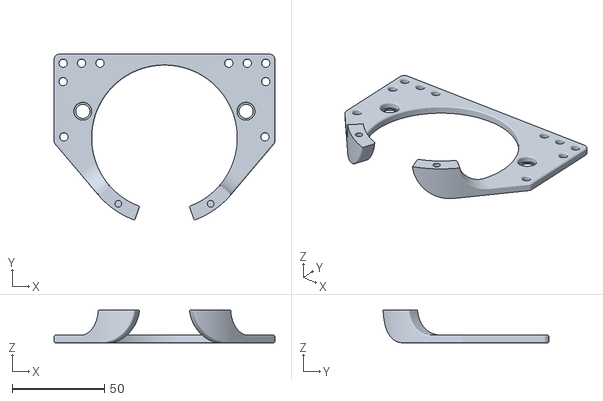
[picture p63: CAD file, 2025-04-14]
Mechanical/Manufacturing Files v1/1xSub Frame(Support Maybe)v1.stl
120.0 x 90.0 x 17.8
