notMarque/RomiOnSpeed/PCBs/Main Board/MainBoardPCB/3dModels/RQF0009A.stp

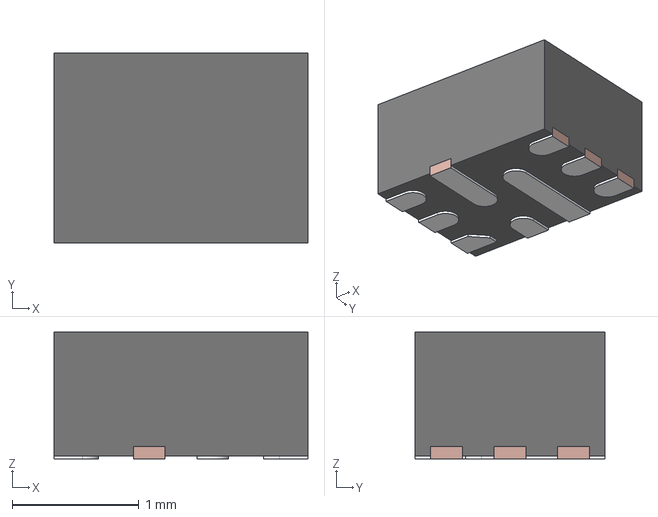
[picture p64: CAD file, 2025-04-26]
PCBs/Main Board/MainBoardPCB/3dModels/RQF0009A.stp
2.00 x 1.50 x 1.00 mm
FRAME
MOLD
