notMarque/RomiOnSpeed/Mechanical/Manufacturing Files v1/1xBase Framev1.step

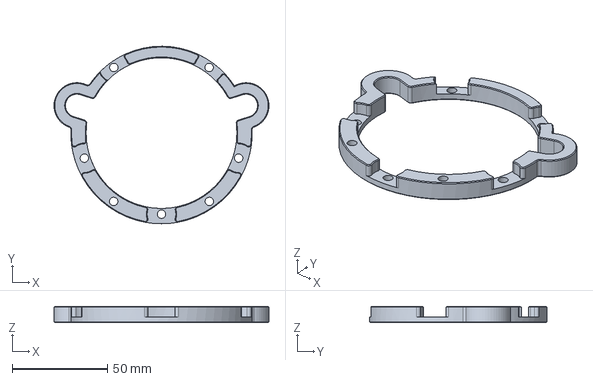
[picture p65: CAD file, 2025-04-14]
Mechanical/Manufacturing Files v1/1xBase Framev1.step
112.6 x 93.0 x 8.50 mm
