notMarque/RomiOnSpeed/PCBs/Main Board/MainBoardPCB/3dModels/PTS636SM43LFS.stp

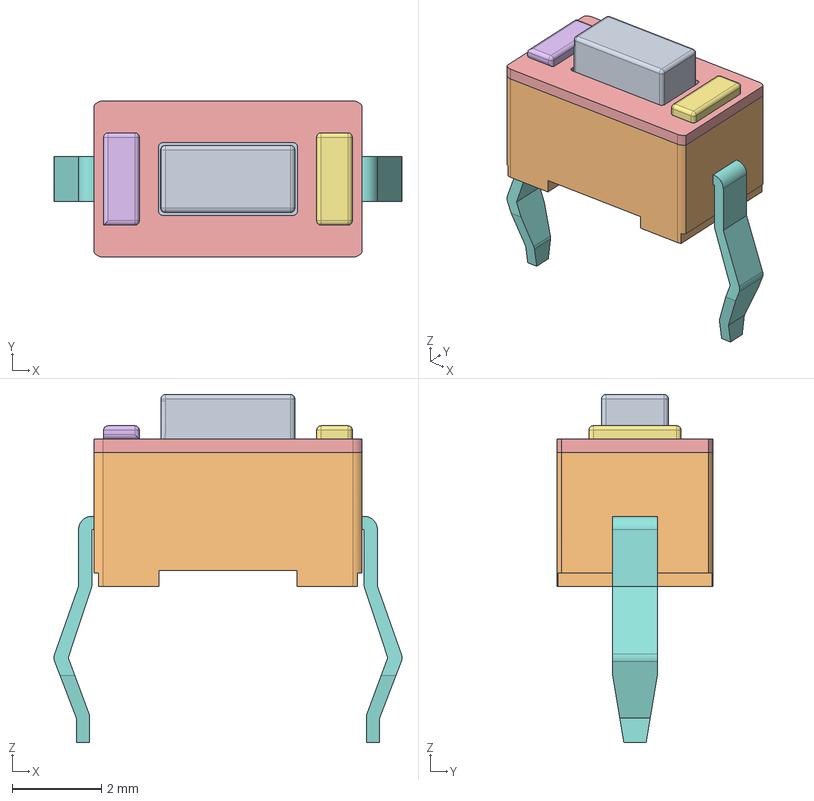
[picture p66: CAD file, 2025-04-26]
PCBs/Main Board/MainBoardPCB/3dModels/PTS636SM43LFS.stp
7.80 x 3.50 x 7.80 mm
PTS636SM43LFS_PART1
PTS636SM43LFS_PART2
PTS636SM43LFS_PART3
PTS636SM43LFS_PART4
PTS636SM43LFS_PART5
PTS636SM43LFS_PART6
PTS636SM43LFS_PART7
PTS636SM43LFS_PART8
PTS636SM43LFS_PART9
PTS636SM43LFS_PART10
