notMarque/RomiOnSpeed/Mechanical/Manufacturing Files v1/1xSuper Framev1.step

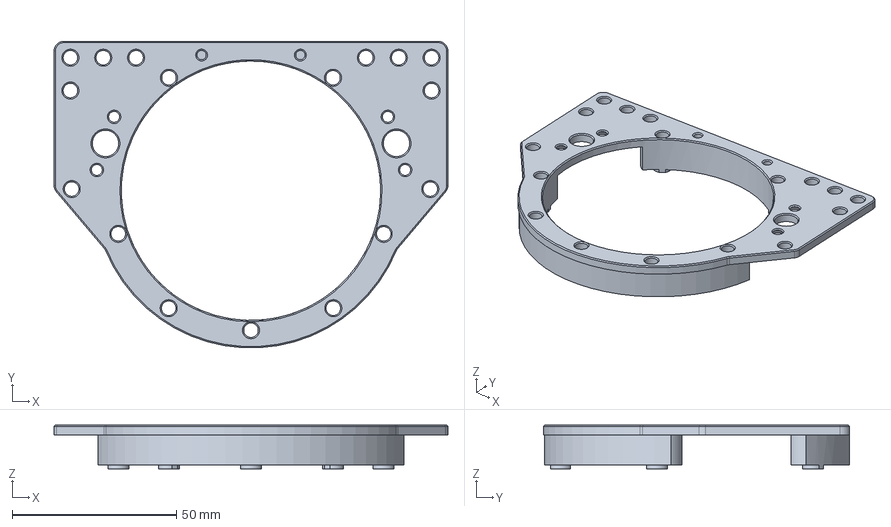
[picture p67: CAD file, 2025-04-14]
Mechanical/Manufacturing Files v1/1xSuper Framev1.step
120.0 x 93.3 x 13.3 mm
