notMarque/RomiOnSpeed/(list of files, cad)

Other CAD files:
Mechanical/Manufacturing Files v1/1xBottom Pinion(Seperate Parts) v1.step
PCBs/Main Board/MainBoardPCB/3dModels/10103594-0001LF.step
PCBs/ModuleBoard/Lubraries/TPS63051RMWR(1)/TPS63051RMWR.step
PCBs/Motor Controller Board/Lubraries/TPS63051RMWR(1)/TPS63051RMWR.step
