notMarque/RomiOnSpeed/Mechanical/Manufacturing Files v1/Wheel Shaft Drawing v1.pdf

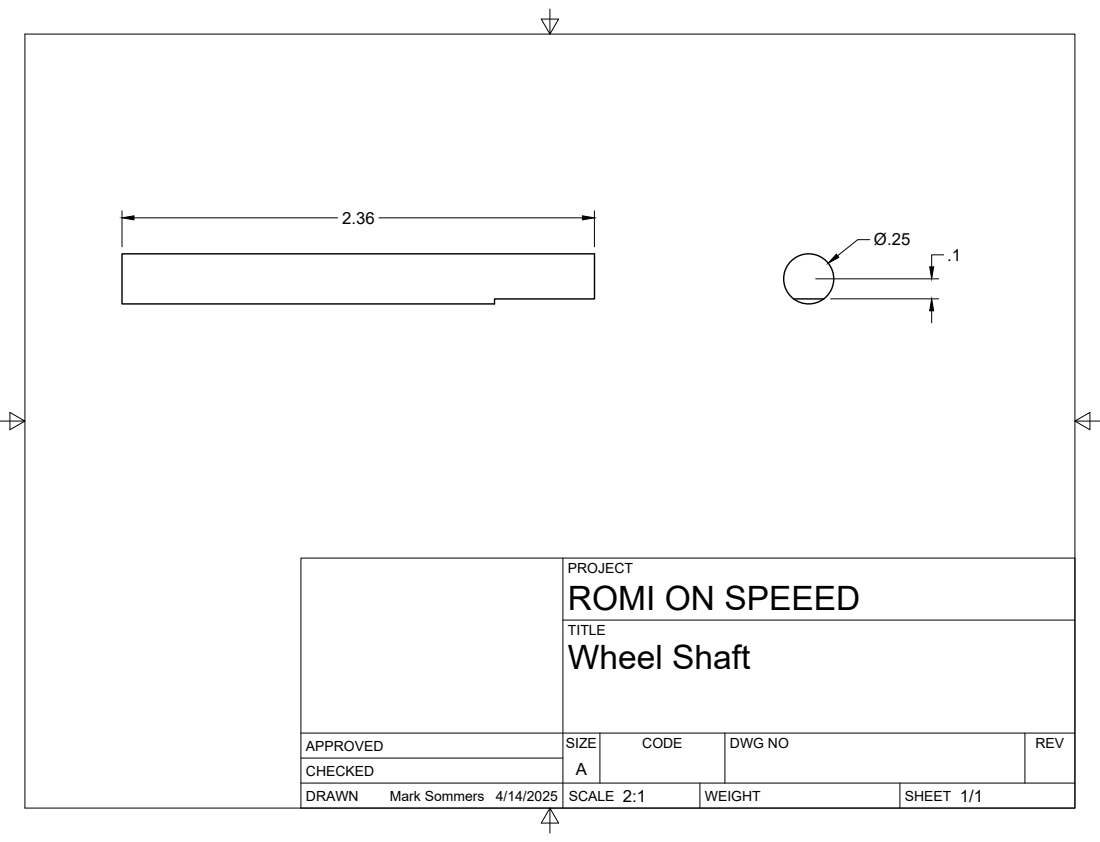
[picture p68: page 1]
SIZE; CODE; DWG NO; REV; Mark Sommers 4/14/2025

PROJECT
ROMI ON SPEEED
Wheel Shaft
