notMarque/RomiOnSpeed/PCBs/RP2040DriverTestBoard/RP2040Driver.kicad_pcb

## KiCad design PCBs/RP2040DriverTestBoard/RP2040Driver.kicad_pcb (2026-10-28)

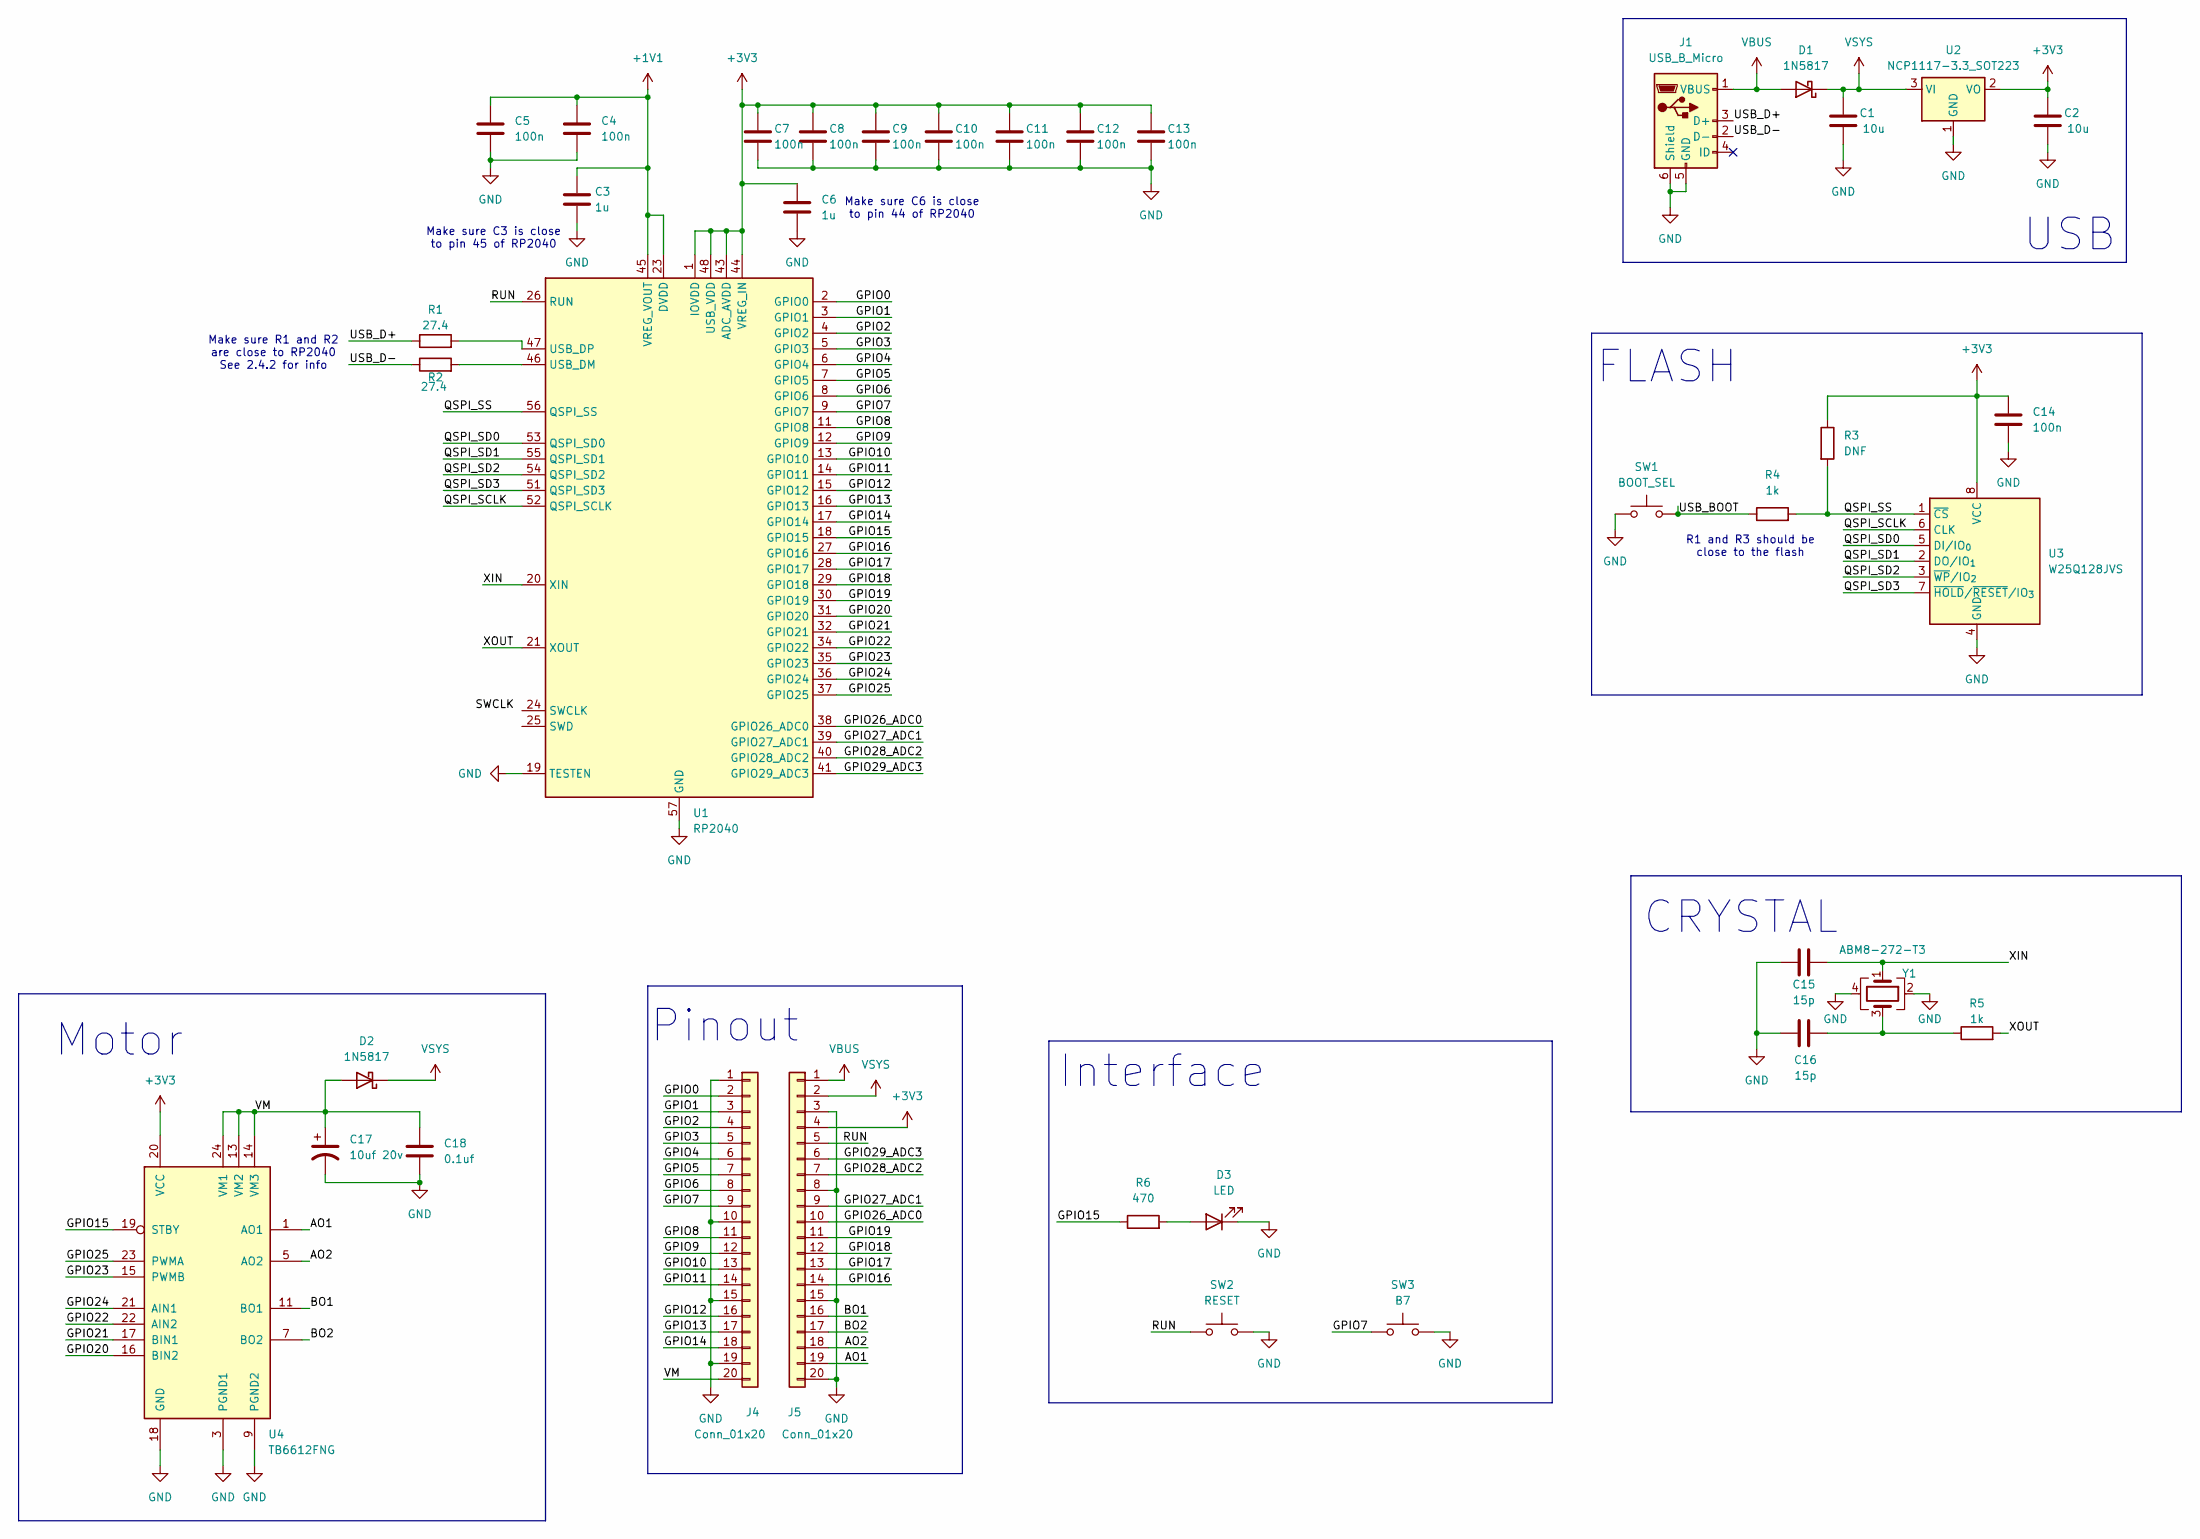
[picture p69: schematic RP2040Driver.kicad_sch, RP2040 Motor Controller]

Parts:
C1, C2: 10u; C_0603_1608Metric_Pad1.08x0.95mm_HandSolder
C3, C6: 1u; C_0603_1608Metric_Pad1.08x0.95mm_HandSolder
C4, C5, C7, C8, C9, C10, C11, C12, C13, C14: 100n; C_0603_1608Metric_Pad1.08x0.95mm_HandSolder
C15, C16: 15p; C_0603_1608Metric_Pad1.08x0.95mm_HandSolder
C17: 10uf 20v; C_0603_1608Metric_Pad1.08x0.95mm_HandSolder
C18: 0.1uf; C_0603_1608Metric_Pad1.08x0.95mm_HandSolder
D1, D2: 1N5817; D_0603_1608Metric_Pad1.05x0.95mm_HandSolder
D3: LED; LED_0603_1608Metric_Pad1.05x0.95mm_HandSolder
J1: USB_B_Micro; USB_Micro-B_Amphenol_10103594-0001LF_Horizontal
J4, J5: Conn_01x20; PinHeader_1x20_P2.54mm_Vertical
R1, R2: 27.4; R_0603_1608Metric_Pad0.98x0.95mm_HandSolder
R3: DNF; R_0603_1608Metric_Pad0.98x0.95mm_HandSolder
R4, R5: 1k; R_0603_1608Metric_Pad0.98x0.95mm_HandSolder
R6: 470; R_0603_1608Metric_Pad0.98x0.95mm_HandSolder
SW1: BOOT_SEL; SW_Tactile_SPST_NO_Straight_CK_PTS636Sx25SMTRLFS
SW2: RESET; SW_Tactile_SPST_NO_Straight_CK_PTS636Sx25SMTRLFS
SW3: B7; SW_Tactile_SPST_NO_Straight_CK_PTS636Sx25SMTRLFS
U1: RP2040; QFN-56-1EP_7x7mm_P0.4mm_EP3.2x3.2mm
U2: NCP1117-3.3_SOT223; SOT-223-3_TabPin2
U3: W25Q128JVS; SOIC-8_5.3x5.3mm_P1.27mm
U4: TB6612FNG; SSOP-24_5.3x8.2mm_P0.65mm
Y1: ABM8-272-T3; Crystal_SMD_Abracon_ABM8G-4Pin_3.2x2.5mm

Connections:
+1V1: C3.1, C4.1, C5.1, U1.23 (DVDD), U1.45 (VREG_VOUT), U1.50 (DVDD)
+3V3: C2.1, C6.1, C7.1, C8.1, C9.1, C10.1, C11.1, C12.1, C13.1, C14.1, J5.4, R3.1, U1.1 (IOVDD), U1.10 (IOVDD), U1.22 (IOVDD), U1.33 (IOVDD), U1.42 (IOVDD), U1.43 (ADC_AVDD), U1.44 (VREG_IN), U1.48 (USB_VDD), U1.49 (IOVDD), U2.2 (VO), U3.8 (VCC), U4.20 (VCC)
/AO1: J5.19, U4.1 (AO1), U4.2 (AO1)
/AO2: J5.18, U4.5 (AO2), U4.6 (AO2)
/BO1: J5.16, U4.11 (BO1), U4.12 (BO1)
/BO2: J5.17, U4.7 (BO2), U4.8 (BO2)
/GPIO0: J4.2, U1.2 (GPIO0)
/GPIO1: J4.3, U1.3 (GPIO1)
/GPIO2: J4.4, U1.4 (GPIO2)
/GPIO3: J4.5, U1.5 (GPIO3)
/GPIO4: J4.6, U1.6 (GPIO4)
/GPIO5: J4.7, U1.7 (GPIO5)
/GPIO6: J4.8, U1.8 (GPIO6)
/GPIO7: J4.9, SW3.1, U1.9 (GPIO7)
/GPIO8: J4.11, U1.11 (GPIO8)
/GPIO9: J4.12, U1.12 (GPIO9)
/GPIO10: J4.13, U1.13 (GPIO10)
/GPIO11: J4.14, U1.14 (GPIO11)
/GPIO12: J4.16, U1.15 (GPIO12)
/GPIO13: J4.17, U1.16 (GPIO13)
/GPIO14: J4.18, U1.17 (GPIO14)
/GPIO15: R6.1, U1.18 (GPIO15), U4.19 (STBY)
/GPIO16: J5.14, U1.27 (GPIO16)
/GPIO17: J5.13, U1.28 (GPIO17)
/GPIO18: J5.12, U1.29 (GPIO18)
/GPIO19: J5.11, U1.30 (GPIO19)
/GPIO20: U1.31 (GPIO20), U4.16 (BIN2)
/GPIO21: U1.32 (GPIO21), U4.17 (BIN1)
/GPIO22: U1.34 (GPIO22), U4.22 (AIN2)
/GPIO23: U1.35 (GPIO23), U4.15 (PWMB)
/GPIO24: U1.36 (GPIO24), U4.21 (AIN1)
/GPIO25: U1.37 (GPIO25), U4.23 (PWMA)
/GPIO26_ADC0: J5.10, U1.38 (GPIO26_ADC0)
/GPIO27_ADC1: J5.9, U1.39 (GPIO27_ADC1)
/GPIO28_ADC2: J5.7, U1.40 (GPIO28_ADC2)
/GPIO29_ADC3: J5.6, U1.41 (GPIO29_ADC3)
/QSPI_SCLK: U1.52 (QSPI_SCLK), U3.6 (CLK)
/QSPI_SD0: U1.53 (QSPI_SD0), U3.5 (DI/IO_{0})
/QSPI_SD1: U1.55 (QSPI_SD1), U3.2 (DO/IO_{1})
/QSPI_SD2: U1.54 (QSPI_SD2), U3.3 (~WP/IO_{2})
/QSPI_SD3: U1.51 (QSPI_SD3), U3.7 (~HOLD/~RESET/IO_{3})
/QSPI_SS: R3.2, R4.2, U1.56 (QSPI_SS), U3.1 (~CS)
/RUN: J5.5, SW2.1, U1.26 (RUN)
/USB_BOOT: R4.1, SW1.2
/USB_D+: J1.3 (D+), R1.1
/USB_D-: J1.2 (D-), R2.1
/VM: C17.1, C18.1, D2.2 (A), J4.20, U4.13 (VM2), U4.14 (VM3), U4.24 (VM1)
/XIN: C15.2, U1.20 (XIN), Y1.1
/XOUT: R5.2, U1.21 (XOUT)
GND: C1.2, C2.2, C3.2, C4.2, C5.2, C6.2, C7.2, C8.2, C9.2, C10.2, C11.2, C12.2, C13.2, C14.2, C15.1, C16.1, C17.2, C18.2, D3.1 (K), J1.5 (GND), J1.6 (Shield), J4.1, J4.10, J4.15, J4.19, J5.3, J5.8, J5.15, J5.20, SW1.1, SW2.2, SW3.2, U1.19 (TESTEN), U1.57 (GND), U2.1 (GND), U3.4 (GND), U4.3 (PGND1), U4.4 (PGND1), U4.9 (PGND2), U4.10 (PGND2), U4.18 (GND), Y1.2, Y1.4
unnamed: C16.2, R5.1, Y1.3
unnamed: D3.2 (A), R6.2
unnamed: R2.2, U1.46 (USB_DM)
unnamed: R1.2, U1.47 (USB_DP)
VBUS: D1.2 (A), J1.1 (VBUS), J5.1
VSYS: C1.1, D1.1 (K), D2.1 (K), J5.2, U2.3 (VI)

Notes on the sheet:
Make sure R1 and R2 are close to RP2040 See 2.4.2 for info
Interface
FLASH
Make sure C3 is close to pin 45 of RP2040
R1 and R3 should be close to the flash
CRYSTAL
Motor
USB
Pinout
Make sure C6 is close to pin 44 of RP2040

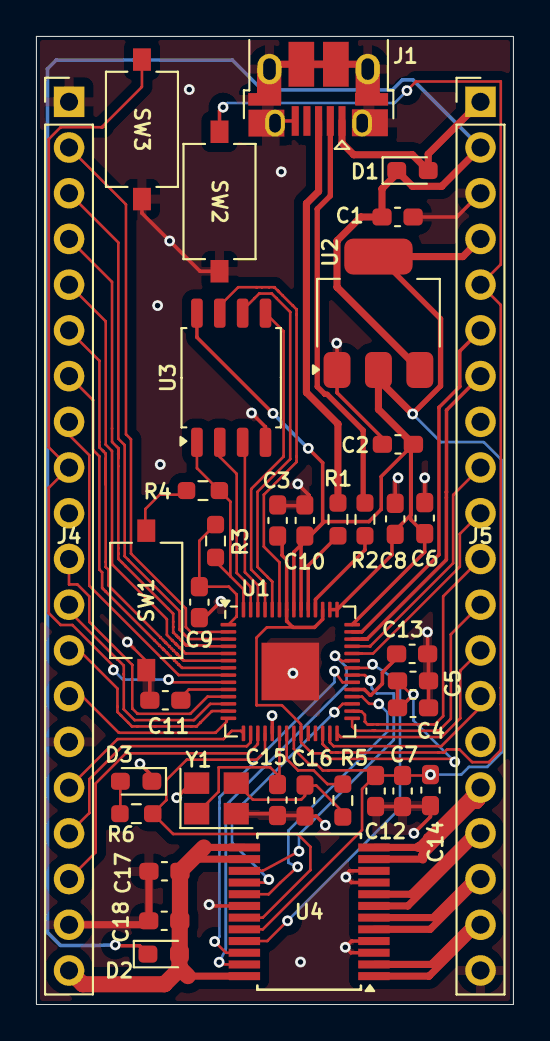
[picture p70: board RP2040Driver.kicad_pcb from above]

Board: 2 copper layers, 26.5 x 53.8 mm, 38 parts (0 on the bottom side), 56 nets.
