notMarque/RomiOnSpeed/PCBs/ModuleBoard/RP2040_minimal_r2/SwerveModuleBoard.kicad_pcb

## KiCad design PCBs/ModuleBoard/RP2040_minimal_r2/SwerveModuleBoard.kicad_pcb (2025-04-26)

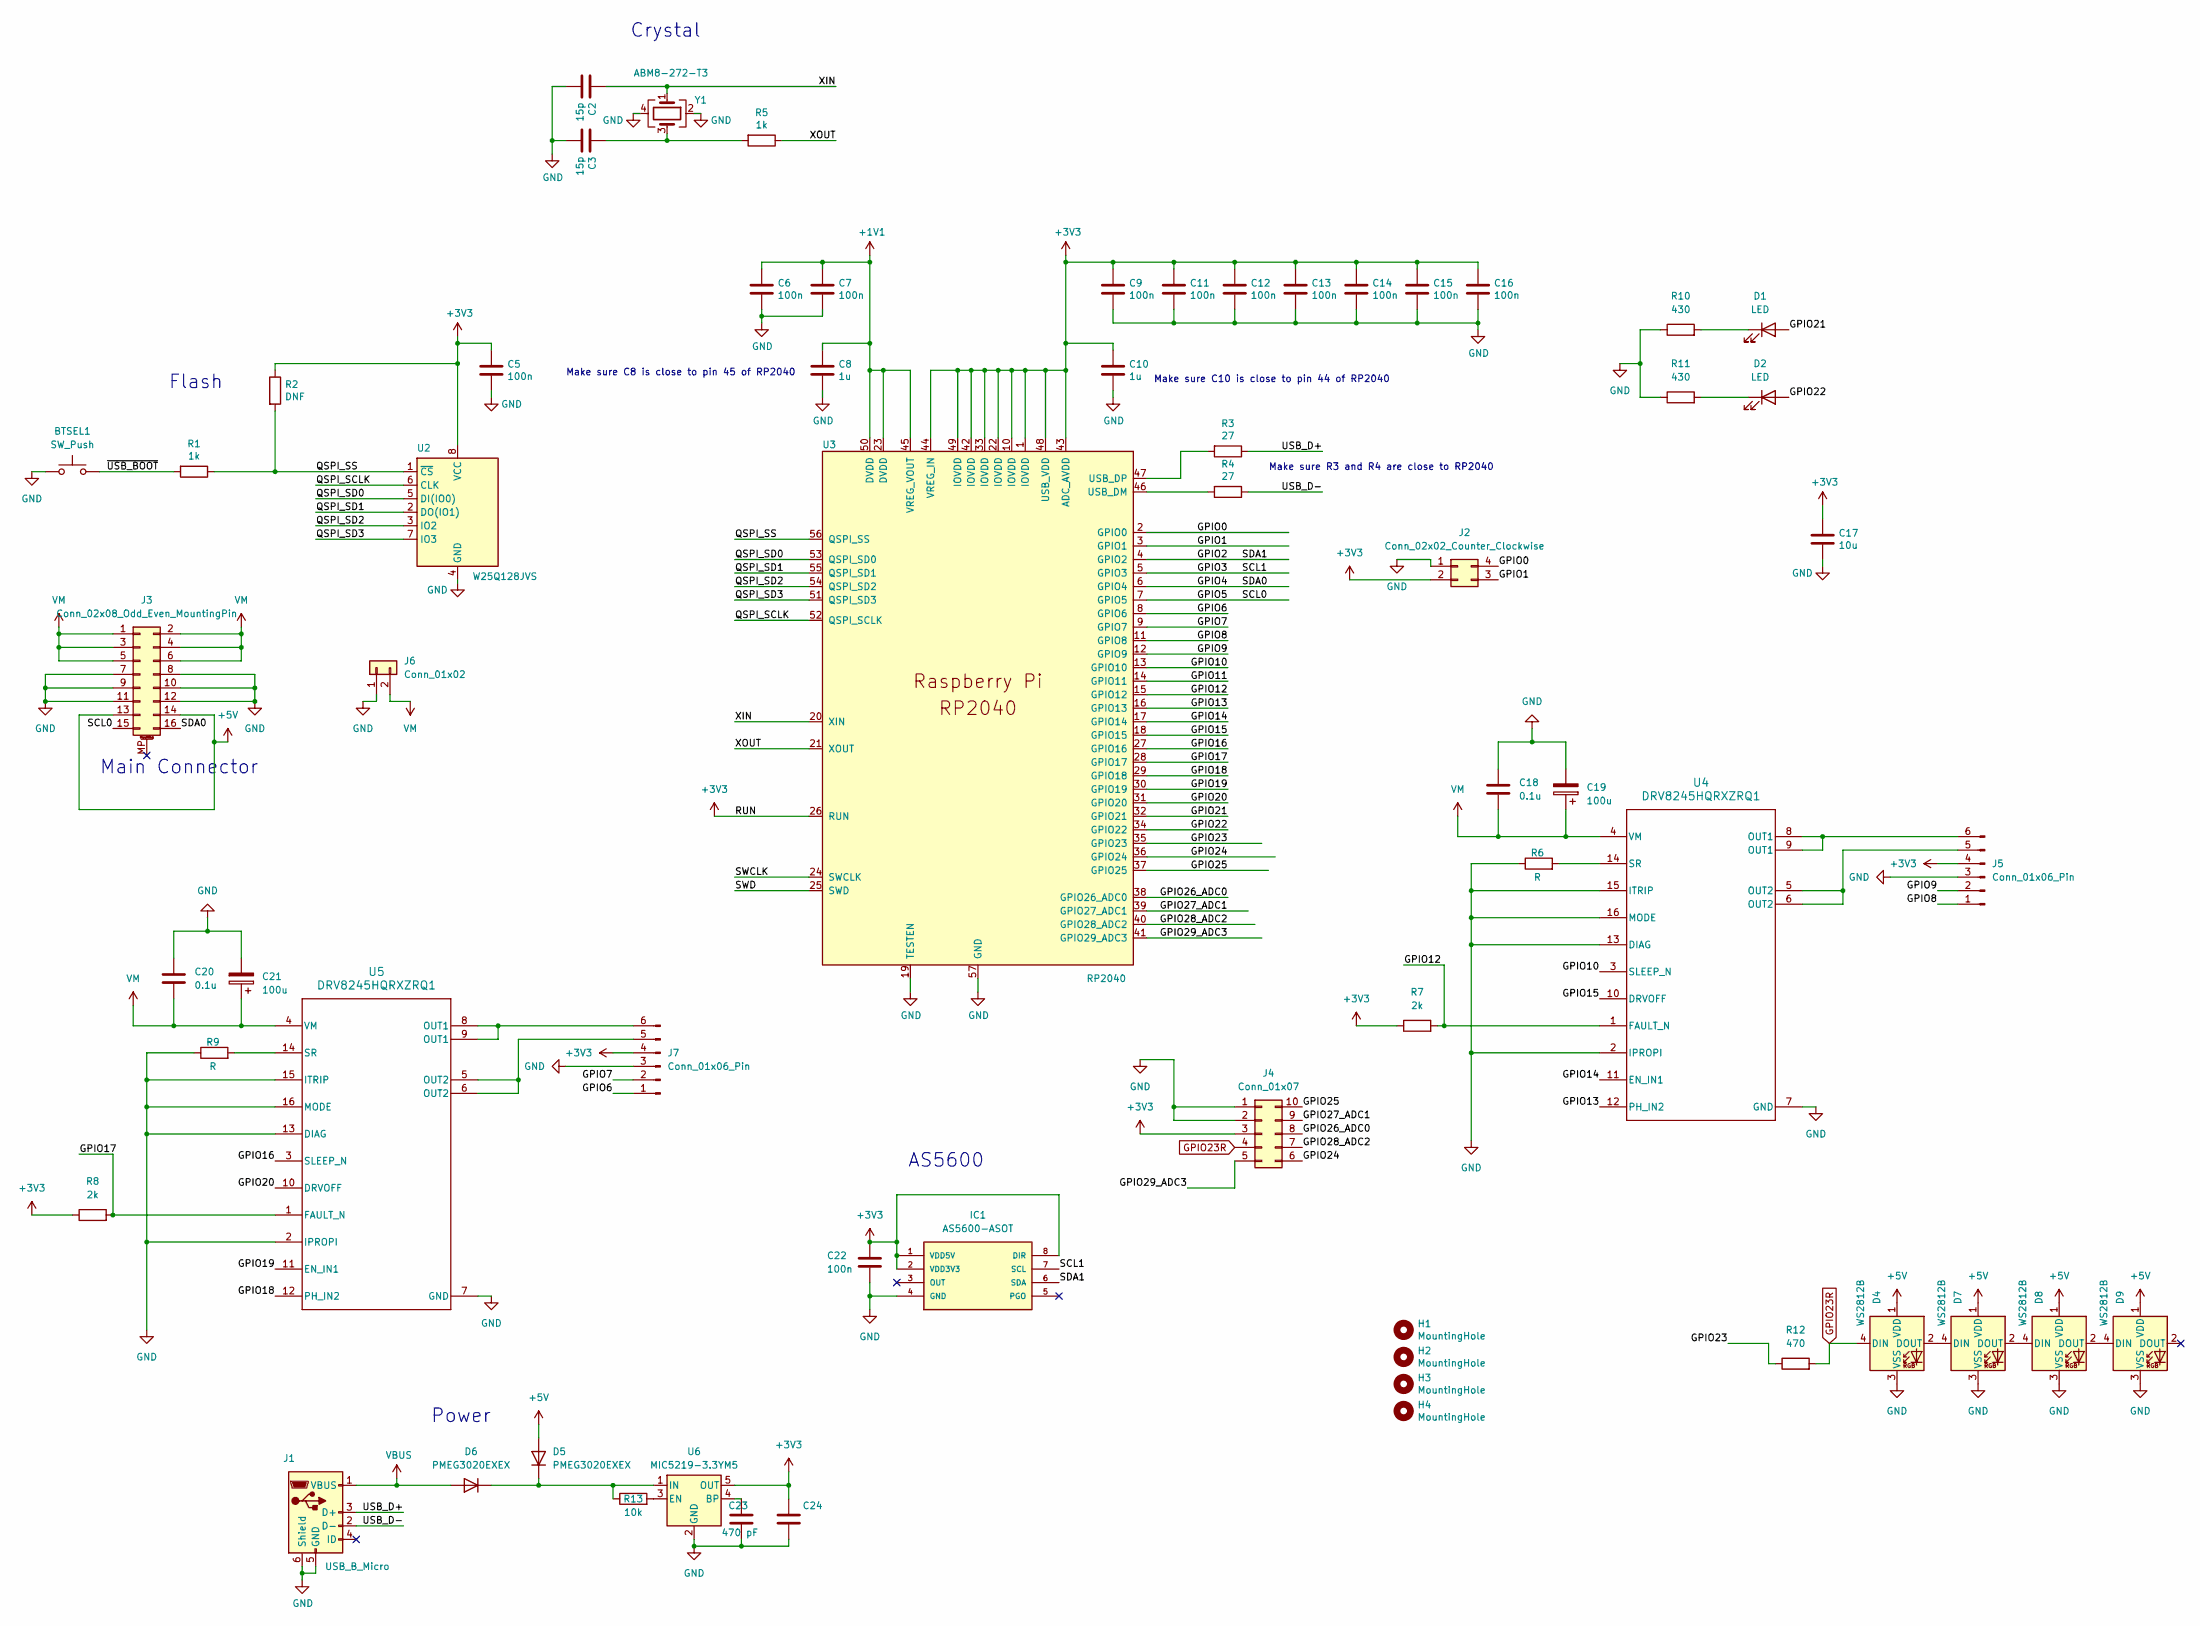
[picture p71: schematic SwerveModuleBoard.kicad_sch, RP2040 Minimal Design Example]

Parts:
BTSEL1: SW_Push; SW_PUSH_1P1T_6x3.5mm_H5.0_APEM_MJTP1250
C2, C3: 15p; C_0603_1608Metric_Pad1.08x0.95mm_HandSolder
C5, C6, C7, C9, C11, C12, C13, C14, C15, C16: 100n; C_0603_1608Metric_Pad1.08x0.95mm_HandSolder
C8, C10: 1u; C_0603_1608Metric_Pad1.08x0.95mm_HandSolder
C17: 10u; C_0603_1608Metric_Pad1.08x0.95mm_HandSolder
C18, C20: 0.1u; C_0603_1608Metric_Pad1.08x0.95mm_HandSolder
C19, C21: 100u; CAPAE800X700
C22: 100n; C_0603_1608Metric
C23: 470 pF; C_0603_1608Metric
C24: 22 uF; C_1206_3216Metric_Pad1.33x1.80mm_HandSolder
D1, D2: LED; LED_0603_1608Metric_Pad1.05x0.95mm_HandSolder
D4, D7, D8, D9: WS2812B; LED_WS2812B_PLCC4_5.0x5.0mm_P3.2mm
D5, D6: PMEG3020EXEX; D_SOD-123F
H1, H2, H3, H4: MountingHole; MountingHole_3.2mm_M3_DIN965_Pad_TopBottom
IC1: AS5600-ASOT; SOIC-8_3.9x4.9mm_P1.27mm; MOUSER_PART_NUMBER 985-AS5600-ASOT
J1: USB_B_Micro; USB_Micro-B_Amphenol_10103594-0001LF_Horizontal_modified
J2: Conn_02x02_Counter_Clockwise; PinHeader_2x02_P2.54mm_Vertical
J3: Conn_02x08_Odd_Even_MountingPin; PinHeader_2x08_P2.54mm_Vertical
J4: Conn_01x07; PinHeader_2x05_P2.54mm_Vertical
J5, J7: Conn_01x06_Pin; PinHeader_1x06_P2.54mm_Vertical
J6: Conn_01x02; AMASS_XT30U-M_1x02_P5.0mm_Vertical
R1, R5: 1k; R_0603_1608Metric_Pad0.98x0.95mm_HandSolder
R2: DNF; R_0603_1608Metric_Pad0.98x0.95mm_HandSolder
R3, R4: 27; R_0603_1608Metric_Pad0.98x0.95mm_HandSolder
R6, R9: R; R_0603_1608Metric_Pad0.98x0.95mm_HandSolder
R7, R8: 2k; R_0603_1608Metric_Pad0.98x0.95mm_HandSolder
R10, R11: 430; R_0603_1608Metric_Pad0.98x0.95mm_HandSolder
R12: 470; C_0603_1608Metric_Pad1.08x0.95mm_HandSolder
R13: 10k; R_0603_1608Metric
U2: W25Q128JVS; SOIC-8_5.3x5.3mm_P1.27mm
U3: RP2040; RP2040-QFN-56
U4, U5: DRV8245HQRXZRQ1; RXZ0016A-MFG
U6: MIC5219-3.3YM5; SOT-23-5
Y1: ABM8-272-T3; Crystal_SMD_3225-4Pin_3.2x2.5mm

Connections:
+1V1: C6.1, C7.1, C8.1, U3.23 (DVDD), U3.45 (VREG_VOUT), U3.50 (DVDD)
+3V3: C5.1, C9.1, C10.1, C11.1, C12.1, C13.1, C14.1, C15.1, C16.1, C17.1, C22.1, C24.1, IC1.1 (VDD5V), IC1.2 (VDD3V3), IC1.8 (DIR), J2.2, J4.3, J5.4, J7.4, R2.1, R7.1, R8.1, U2.8 (VCC), U3.1 (IOVDD), U3.10 (IOVDD), U3.22 (IOVDD), U3.26 (RUN), U3.33 (IOVDD), U3.42 (IOVDD), U3.43 (ADC_AVDD), U3.44 (VREG_IN), U3.48 (USB_VDD), U3.49 (IOVDD), U6.5 (OUT)
+5V: D4.1 (VDD), D5.2 (A), D7.1 (VDD), D8.1 (VDD), D9.1 (VDD), J3.13, J3.14
/GPIO0: J2.4, U3.2 (GPIO0)
/GPIO1: J2.3, U3.3 (GPIO1)
/GPIO2: IC1.6 (SDA), U3.4 (GPIO2)
/GPIO3: IC1.7 (SCL), U3.5 (GPIO3)
/GPIO4: J3.16, U3.6 (GPIO4)
/GPIO5: J3.15, U3.7 (GPIO5)
/GPIO6: J7.1, U3.8 (GPIO6)
/GPIO7: J7.2, U3.9 (GPIO7)
/GPIO8: J5.1, U3.11 (GPIO8)
/GPIO9: J5.2, U3.12 (GPIO9)
/GPIO10: U3.13 (GPIO10), U4.3 (SLEEP_N)
/GPIO11: U3.14 (GPIO11)
/GPIO12: R7.2, U3.15 (GPIO12), U4.1 (FAULT_N)
/GPIO13: U3.16 (GPIO13), U4.12 (PH_IN2)
/GPIO14: U3.17 (GPIO14), U4.11 (EN_IN1)
/GPIO15: U3.18 (GPIO15), U4.10 (DRVOFF)
/GPIO16: U3.27 (GPIO16), U5.3 (SLEEP_N)
/GPIO17: R8.2, U3.28 (GPIO17), U5.1 (FAULT_N)
/GPIO18: U3.29 (GPIO18), U5.12 (PH_IN2)
/GPIO19: U3.30 (GPIO19), U5.11 (EN_IN1)
/GPIO20: U3.31 (GPIO20), U5.10 (DRVOFF)
/GPIO21: D1.2 (A), U3.32 (GPIO21)
/GPIO22: D2.2 (A), U3.34 (GPIO22)
/GPIO23: R12.1, U3.35 (GPIO23)
/GPIO24: J4.6, U3.36 (GPIO24)
/GPIO25: J4.10, U3.37 (GPIO25)
/GPIO26_ADC0: J4.8, U3.38 (GPIO26_ADC0)
/GPIO27_ADC1: J4.9, U3.39 (GPIO27_ADC1)
/GPIO28_ADC2: J4.7, U3.40 (GPIO28_ADC2)
/GPIO29_ADC3: J4.5, U3.41 (GPIO29_ADC3)
/QSPI_SCLK: U2.6 (CLK), U3.52 (QSPI_SCLK)
/QSPI_SD0: U2.5 (DI(IO0)), U3.53 (QSPI_SD0)
/QSPI_SD1: U2.2 (DO(IO1)), U3.55 (QSPI_SD1)
/QSPI_SD2: U2.3 (IO2), U3.54 (QSPI_SD2)
/QSPI_SD3: U2.7 (IO3), U3.51 (QSPI_SD3)
/QSPI_SS: R1.1, R2.2, U2.1 (~CS), U3.56 (QSPI_SS)
/SWCLK: U3.24 (SWCLK)
/SWD: U3.25 (SWD)
/USB_D+: J1.3 (D+), R3.1
/USB_D-: J1.2 (D-), R4.1
/XIN: C2.1, U3.20 (XIN), Y1.1
/XOUT: R5.1, U3.21 (XOUT)
/~USB_BOOT: BTSEL1.2, R1.2
GND: BTSEL1.1, C2.2, C3.2, C5.2, C6.2, C7.2, C8.2, C9.2, C10.2, C11.2, C12.2, C13.2, C14.2, C15.2, C16.2, C17.2, C18.1, C19.2, C20.1, C21.2, C22.2, C23.2, C24.2, D4.3 (VSS), D7.3 (VSS), D8.3 (VSS), D9.3 (VSS), IC1.4 (GND), J1.5 (GND), J1.6 (Shield), J2.1, J3.7, J3.8, J3.9, J3.10, J3.11, J3.12, J4.1, J4.2, J5.3, J6.1, J7.3, R6.1, R9.1, R10.1, R11.1, U2.4 (GND), U3.19 (TESTEN), U3.57 (GND), U4.2 (IPROPI), U4.7 (GND), U4.13 (DIAG), U4.15 (ITRIP), U4.16 (MODE), U5.2 (IPROPI), U5.7 (GND), U5.13 (DIAG), U5.15 (ITRIP), U5.16 (MODE), U6.2 (GND), Y1.2, Y1.4
GPIO23R: D4.4 (DIN), J4.4, R12.2
unnamed: C3.1, R5.2, Y1.3
unnamed: D1.1 (K), R10.2
unnamed: D2.1 (K), R11.2
unnamed: D4.2 (DOUT), D7.4 (DIN)
unnamed: D5.1 (K), D6.1 (K), R13.1, U6.1 (IN)
unnamed: D7.2 (DOUT), D8.4 (DIN)
unnamed: D8.2 (DOUT), D9.4 (DIN)
unnamed: J5.5, U4.5 (OUT2), U4.6 (OUT2)
unnamed: J5.6, U4.8 (OUT1), U4.9 (OUT1)
unnamed: J7.5, U5.5 (OUT2), U5.6 (OUT2)
unnamed: J7.6, U5.8 (OUT1), U5.9 (OUT1)
unnamed: R4.2, U3.46 (USB_DM)
unnamed: R3.2, U3.47 (USB_DP)
unnamed: R6.2, U4.14 (SR)
unnamed: R9.2, U5.14 (SR)
unnamed: C23.1, U6.4 (BP)
unnamed: R13.2, U6.3 (EN)
VBUS: D6.2 (A), J1.1 (VBUS)
VM: C18.2, C19.1, C20.2, C21.1, J3.1, J3.2, J3.3, J3.4, J3.5, J3.6, J6.2, U4.4 (VM), U5.4 (VM)

Notes on the sheet:
Power
Crystal
Make sure C8 is close to pin 45 of RP2040
Make sure C10 is close to pin 44 of RP2040
Main Connector
Make sure R3 and R4 are close to RP2040
AS5600
Flash

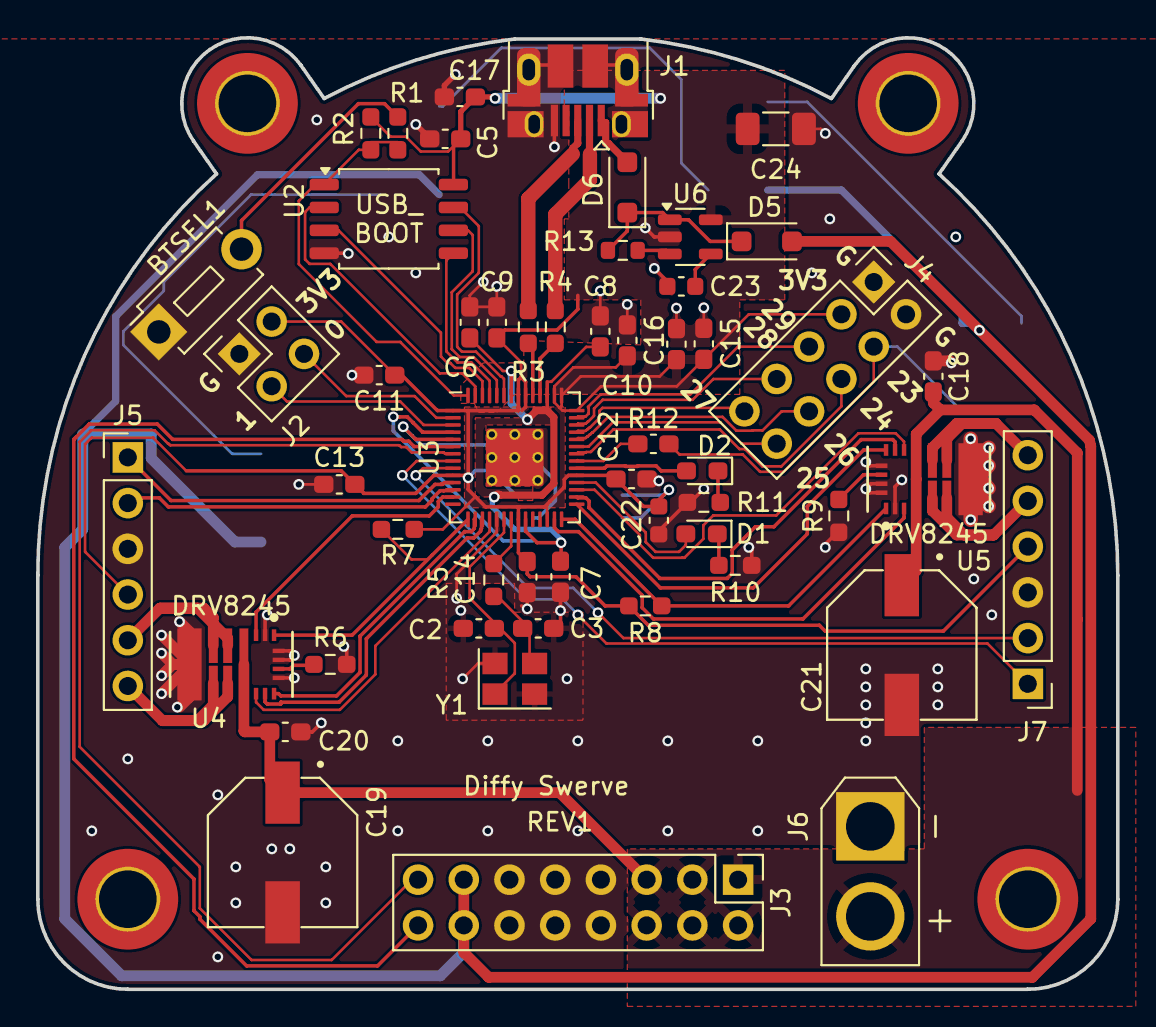
[picture p72: board SwerveModuleBoard.kicad_pcb from above]

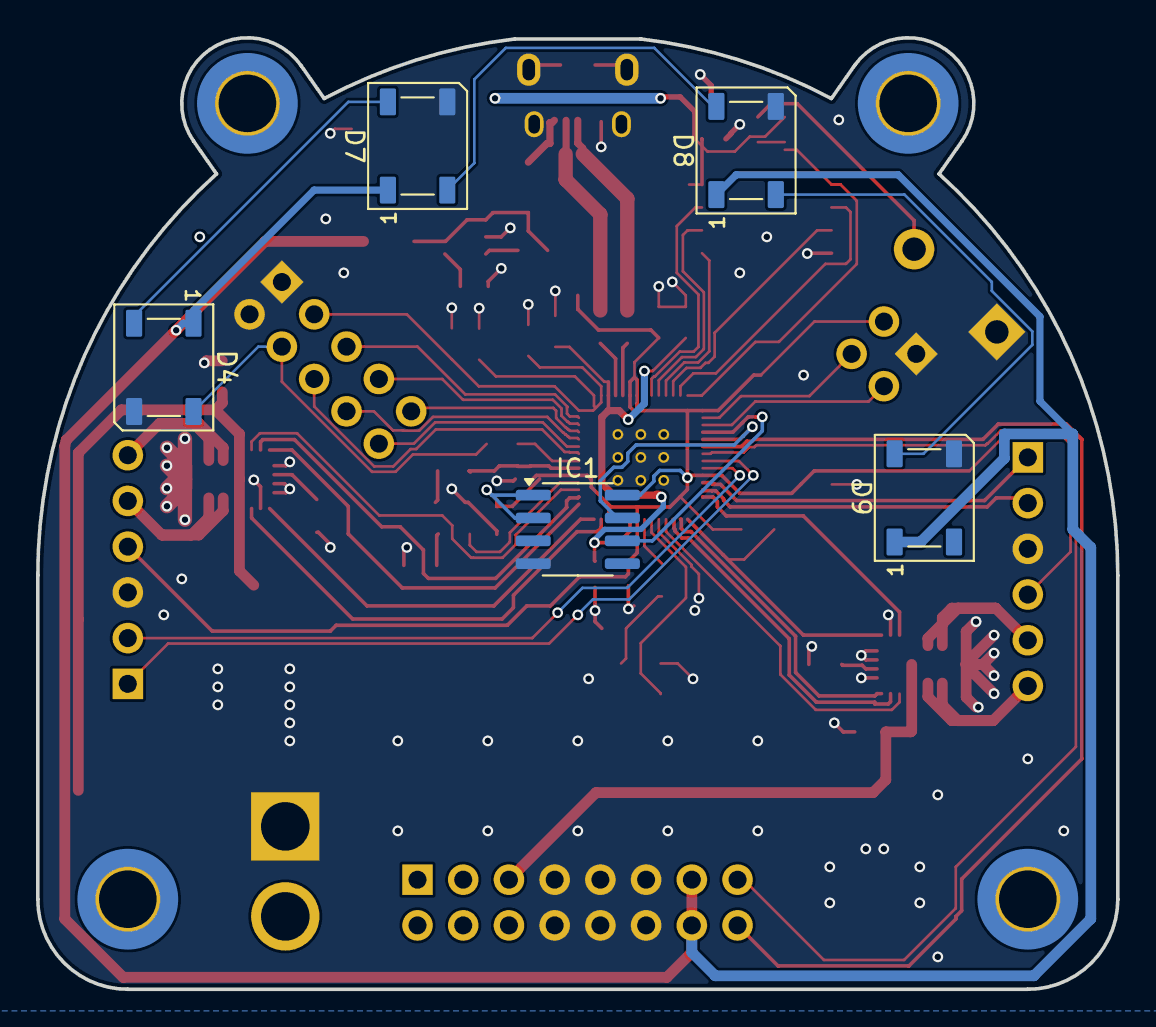
[picture p73: board SwerveModuleBoard.kicad_pcb from below]

Board: 2 copper layers, 60.0 x 52.9 mm, 62 parts (5 on the bottom side), 64 nets.
