notMarque/RomiOnSpeed/PCBs/Main Board/MainBoardPCB/MainBoardPCB.kicad_pcb

## KiCad design PCBs/Main Board/MainBoardPCB/MainBoardPCB.kicad_pcb (2025-04-26)

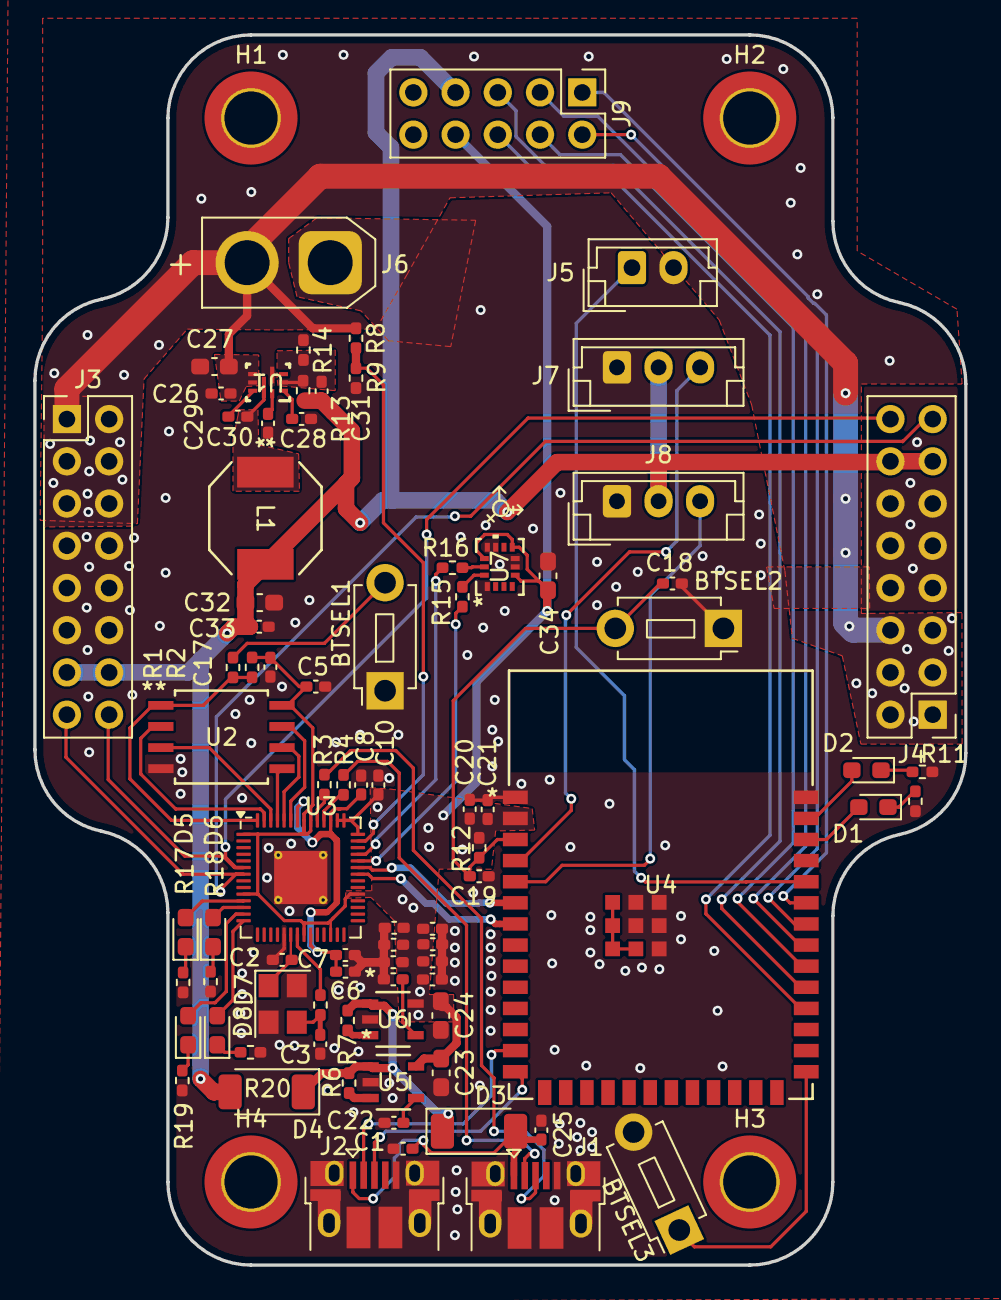
[picture p74: board MainBoardPCB.kicad_pcb from above]

Board: 4 copper layers, 56.0 x 74.0 mm, 87 parts (0 on the bottom side), 64 nets.

Parts:
BTSEL1, BTSEL2, BTSEL3: SW_Push; SW_PUSH_1P1T_6x3.5mm_H5.0_APEM_MJTP1250
C1, C17, C25: 10u; C_0402_1005Metric_Pad0.74x0.62mm_HandSolder
C2, C3: 15p; C_0402_1005Metric_Pad0.74x0.62mm_HandSolder
C4, C22: 470 pF; C_0402_1005Metric_Pad0.74x0.62mm_HandSolder
C5, C6, C7, C9, C11, C12, C13, C14, C15, C16: 100n; C_0402_1005Metric_Pad0.74x0.62mm_HandSolder
C8, C10: 1u; C_0402_1005Metric_Pad0.74x0.62mm_HandSolder
C18, C19, C20: 22μF; C_0402_1005Metric_Pad0.74x0.62mm_HandSolder
C21, C26, C30, C33: 100 nF; C_0402_1005Metric_Pad0.74x0.62mm_HandSolder
C23, C24, C32, C34: 22 uF; C_0603_1608Metric_Pad1.08x0.95mm_HandSolder
C27: 47 uF; C_0603_1608Metric_Pad1.08x0.95mm_HandSolder
C28: 1 uF; C_0402_1005Metric_Pad0.74x0.62mm_HandSolder
C29: 10 nF; C_0402_1005Metric_Pad0.74x0.62mm_HandSolder
C31: 33 pF; C_0402_1005Metric_Pad0.74x0.62mm_HandSolder
D1, D2, D5, D6, D7, D8: LED; LED_0603_1608Metric_Pad1.05x0.95mm_HandSolder
D3, D4: PMEG3020EXEX; D_SOD-128
H1, H2, H3, H4: MountingHole; MountingHole_3.2mm_M3_DIN965_Pad_TopBottom
J1, J2: USB_B_Micro; USB_Micro-B_Amphenol_10103594-0001LF_Horizontal
J3, J4: Conn_02x08_Odd_Even_MountingPin; PinHeader_2x08_P2.54mm_Vertical
J5: Conn_01x02; JST_EH_B2B-EH-A_1x02_P2.50mm_Vertical
J6: Conn_01x02; AMASS_XT30U-M_1x02_P5.0mm_Vertical
J7, J8: Conn_01x03; JST_EH_B3B-EH-A_1x03_P2.50mm_Vertical
J9: Conn_02x05_Counter_Clockwise; PinHeader_2x05_P2.54mm_Vertical
L1: L; IND_SPM6530_TDK
R1, R5: 1k; R_0402_1005Metric_Pad0.72x0.64mm_HandSolder
R2: DNF; R_0402_1005Metric_Pad0.72x0.64mm_HandSolder
R3, R4: 27; R_0402_1005Metric_Pad0.72x0.64mm_HandSolder
R6, R7, R12, R15, R16: 10k; R_0402_1005Metric_Pad0.72x0.64mm_HandSolder
R8: 100k; R_0402_1005Metric_Pad0.72x0.64mm_HandSolder
R9: 20k; R_0402_1005Metric_Pad0.72x0.64mm_HandSolder
R10, R11, R17, R18, R19, R20: 430; R_0402_1005Metric_Pad0.72x0.64mm_HandSolder
R13: 220k; R_0402_1005Metric_Pad0.72x0.64mm_HandSolder
R14: 30k; R_0402_1005Metric_Pad0.72x0.64mm_HandSolder
U1: TPS566238PRQFR; RQF0009A
U2: W25Q128JVS; SOIC_128JVSIQ_WIN
U3: RP2040; QFN-56-1EP_7x7mm_P0.4mm_EP3.2x3.2mm_ThermalVias
U4: ESP32-S3-WROOM-1-N16; ESP32-S3-WROOM-1_EXP
U5, U6: MIC5219-3.3YM5; MIC
U7: LSM6DSVTR; LGA14-L_2P59X3P1X0P5_STM
Y1: ABM8-272-T3; Crystal_SMD_3225-4Pin_3.2x2.5mm

Connections:
2040RX: U3.37 (GPIO25), U4.6 (IO6)
2040TX: U3.36 (GPIO24), U4.7 (IO7)
+1V1: C6.1, C7.1, C8.1, U3.23 (DVDD), U3.45 (VREG_VOUT), U3.50 (DVDD)
+3V3: C5.1, C9.1, C10.1, C11.1, C12.1, C13.1, C14.1, C15.1, C16.1, C17.1, C20.2, C21.2, C23.1, C24.1, C34.1, J9.8, R2.1, R12.2, U2.8 (VCC), U3.1 (IOVDD), U3.10 (IOVDD), U3.22 (IOVDD), U3.26 (RUN), U3.33 (IOVDD), U3.42 (IOVDD), U3.43 (ADC_AVDD), U3.44 (VREG_IN), U3.48 (USB_VDD), U3.49 (IOVDD), U4.2 (3V3), U5.5 (OUT), U6.5 (OUT), U7.5 (VDD_IO), U7.8 (VDD), U7.12 (CS)
+5V: C31.1, C32.1, C33.1, D4.2 (A), J3.13, J3.14, J4.13, J4.14, J7.2, J8.2, J9.7, L1.2, R13.2
/GPIO4: J3.16, J4.16, U3.6 (GPIO4)
/GPIO5: J3.15, J4.15, U3.7 (GPIO5)
/QSPI_SCLK: U2.6 (CLK), U3.52 (QSPI_SCLK)
/QSPI_SD0: U2.5 (DI(IO0)), U3.53 (QSPI_SD0)
/QSPI_SD1: U2.2 (DO(IO1)), U3.55 (QSPI_SD1)
/QSPI_SD2: U2.3 (IO2), U3.54 (QSPI_SD2)
/QSPI_SD3: U2.7 (IO3), U3.51 (QSPI_SD3)
/QSPI_SS: R1.1, R2.2, U2.1 (~CS), U3.56 (QSPI_SS)
/USB_D+: J1.3 (D+), R3.1
/USB_D-: J1.2 (D-), R4.1
/XIN: C2.1, U3.20 (XIN), Y1.1
/XOUT: R5.1, U3.21 (XOUT)
/~USB_BOOT: BTSEL1.2, R1.2
BATT_READ: R8.2, R9.1, U3.41 (GPIO29_ADC3)
D+: J2.3 (D+), U4.14 (IO20)
D-: J2.2 (D-), U4.13 (IO19)
GND: BTSEL1.1, BTSEL2.1, BTSEL3.2, C1.2, C2.2, C3.2, C4.2, C5.2, C6.2, C7.2, C8.2, C9.2, C10.2, C11.2, C12.2, C13.2, C14.2, C15.2, C16.2, C17.2, C18.1, C19.2, C20.1, C21.1, C22.2, C23.2, C24.2, C25.2, C26.2, C27.2, C28.2, C29.2, C32.2, C33.2, C34.2, J1.5 (GND), J1.6 (Shield), J2.5 (GND), J2.6 (Shield), J3.7, J3.8, J3.9, J3.10, J3.11, J3.12, J4.7, J4.8, J4.9, J4.10, J4.11, J4.12, J5.2, J6.1, J7.1, J8.1, J9.9, J9.10, R9.2, R10.1, R11.1, R14.1, R17.1, R18.1, R19.1, R20.1, U1.4 (PGND), U2.4 (GND), U3.19 (TESTEN), U3.57 (GND), U4.1 (GND), U4.40 (GND), U4.41 (GND), U4.46 (GND), U4.47 (GND), U4.48 (GND), U4.49 (GND), U5.2 (GND), U6.2 (GND), U7.1 (SDO/SA0), U7.6 (GND), U7.7 (GND), U7.10 (OCS_AUX), U7.11 (SDO_AUX), Y1.2, Y1.4
GYROSCL: R16.1, U3.39 (GPIO27_ADC1)
GYROSDA: R15.1, U3.38 (GPIO26_ADC0)
LED1: D2.2 (A), U4.39 (IO1)
LED2: D1.2 (A), U4.38 (IO2)
LED3: D5.2 (A), U3.11 (GPIO8)
LED4: D6.2 (A), U3.12 (GPIO9)
LED5: D7.2 (A), U3.13 (GPIO10)
LED6: D8.2 (A), U3.14 (GPIO11)
unnamed: C3.1, R5.2, Y1.3
unnamed: D1.1 (K), R10.2
unnamed: D2.1 (K), R11.2
unnamed: D3.1 (K), D4.1 (K), R6.1, R7.1, U5.1 (IN), U6.1 (IN)
unnamed: D5.1 (K), R17.2
unnamed: D6.1 (K), R18.2
unnamed: D7.1 (K), R19.2
unnamed: D8.1 (K), R20.2
unnamed: J9.1, U4.35 (IO42)
unnamed: J9.2, U4.34 (IO41)
unnamed: J9.3, U4.33 (IO40)
unnamed: J9.4, U4.32 (IO39)
unnamed: J9.5, U4.31 (IO38)
unnamed: J9.6, U4.30 (IO37)
unnamed: C30.1, U1.7 (BST)
unnamed: C31.2, R13.1, R14.2, U1.2 (FB)
unnamed: C29.1, U1.9 (SS)
unnamed: C30.2, L1.1, U1.8 (SW)
unnamed: C28.1, U1.1 (VCC)
unnamed: R4.2, U3.46 (USB_DM)
unnamed: R3.2, U3.47 (USB_DP)
unnamed: BTSEL2.2, C18.2, C19.1, R12.1, U4.3 (EN)
unnamed: BTSEL3.1, U4.27 (IO0)
unnamed: C22.1, U5.4 (BP)
unnamed: R6.2, U5.3 (EN)
unnamed: C4.1, U6.4 (BP)
unnamed: R7.2, U6.3 (EN)
unnamed: R16.2, U7.13 (SCL)
unnamed: R15.2, U7.14 (SDA)
RX: J5.1, U4.36 (RXD0)
Servo1: J7.3, U4.4 (IO4)
Servo2: J8.3, U4.5 (IO5)
VAA: C26.1, C27.1, J3.1, J3.2, J3.3, J3.4, J3.5, J3.6, J4.1, J4.2, J4.3, J4.4, J4.5, J4.6, J6.2, R8.1, U1.5 (VIN), U1.6 (VIN)
VUSB: C1.1, C25.1, D3.2 (A), J1.1 (VBUS), J2.1 (VBUS)
