notMarque/RomiOnSpeed/(commit log)

2025-04-07 vault backup: 2025-04-07 15:24:29
    [RP2040_minimal_r2-BOM.xlsx, RP2040_minimal_r2.kicad_pcb, RP2040_minimal_r2.kicad_sch]
2025-04-08 vault backup: 2025-04-07 20:47:17
    [RP2040_minimal_r2.kicad_sch]
2025-04-08 vault backup: 2025-04-08 00:30:09
    [RP2040_minimal_r2.kicad_pcb, RP2040_minimal_r2.kicad_sch]
2025-04-08 PCB Work
    [RP2040_minimal_r2.kicad_pcb, RP2040_minimal_r2.kicad_sch]
2025-04-10 RUN tied high
    [RP2040_minimal_r2.kicad_pcb, RP2040_minimal_r2.kicad_sch]
2025-04-10 Oop, I forgor to push
    [RP2040_minimal_r2.kicad_pcb, RP2040_minimal_r2.kicad_sch]
2025-04-11 A bunch of pcb files
    [RP2040_minimal_r2-B_Cu.gbr, RP2040_minimal_r2-B_Mask.gbr, RP2040_minimal_r2-B_Paste.gbr, RP2040_minimal_r2-B_Silkscreen.gbr, RP2040_minimal_r2-Edge_Cuts.gbr, RP2040_minimal_r2-F_Cu.gbr, RP2040_minimal_r2-F_Mask.gbr, RP2040_minimal_r2-F_Paste.gbr]
2025-04-14 v1 Manufacturing Files
    [10xBearing Holderv1.step, 1xBase Framev1.step, 1xBottom Pinion(Seperate Parts) v1.step, 1xEncoder Mount(Support)v1.step, 1xMagnetHolder v1.step, 1xMain Plate(Seperate)(Support) v1.step, 1xPlate Standoff(Seperate (4 total))v1.step, 1xSub Frame(Support Maybe)v1.stl]
2025-04-14 OrcaSlicer Project
    [10xBearing Holderv1.step, 1xBase Framev1.step, 1xBottom Pinion(Seperate Parts) v1.step, 1xEncoder Mount(Support)v1.step, 1xMagnetHolder v1.step, 1xMain Plate(Seperate)(Support) v1.step, 1xPlate Standoff(Seperate (4 total))v1.step, 1xSub Frame(Support Maybe)v1.stl]
2025-04-22 vault backup: 2025-04-22 13:09:39
    [RP2040_minimal_r2-BOM.xlsx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]
2025-04-22 Module Board Copied
    [RP2040_minimal_r2.kicad_pcb, RP2040_minimal_r2.kicad_sch]
2025-04-22 vault backup: 2025-04-22 13:30:05
    [RP2040_minimal_r2.kicad_sch]
2025-04-22 First Board Profile draft
    [SwerveModuleBoard.kicad_pcb, SwerveModuleBoard.kicad_sch]
2025-04-24 vault backup: 2025-04-24 00:27:01
    [SwerveModuleBoard.kicad_sch]
2025-04-24 vault backup: 2025-04-24 01:20:25
    [SwerveModuleBoard.kicad_pcb]
2025-04-24 vault backup: 2025-04-24 01:46:54
    [SwerveModuleBoard.kicad_sch]
2025-04-24 vault backup: 2025-04-24 02:18:37
    [SwerveModuleBoard.kicad_sch]
2025-04-24 vault backup: 2025-04-24 02:23:43
    [SwerveModuleBoard.kicad_sch]
2025-04-24 vault backup: 2025-04-24 02:28:50
    [SwerveModuleBoard.kicad_sch]
2025-04-24 vault backup: 2025-04-24 02:39:03
    [SwerveModuleBoard.kicad_sch]
2025-04-24 vault backup: 2025-04-24 02:44:10
    [SwerveModuleBoard.kicad_pcb, SwerveModuleBoard.kicad_sch]
2025-04-24 vault backup: 2025-04-24 02:54:17
    [SwerveModuleBoard.kicad_pcb]
2025-04-24 vault backup: 2025-04-24 03:04:29
    [MainBoardPCB.kicad_pcb, MainBoardPCB.kicad_sch]
2025-04-24 vault backup: 2025-04-24 03:09:35
    [MainBoardPCB.kicad_sch]
2025-04-24 Oopsie, got a bit late
    [MainBoardPCB.kicad_pcb]
2025-04-24 vault backup: 2025-04-24 15:59:31
    [MainBoardPCB.kicad_pcb]
2025-04-24 vault backup: 2025-04-24 16:00:18
    [MainBoardPCB.kicad_pcb]
2025-04-24 vault backup: 2025-04-24 16:36:01
    [SwerveModuleBoard.kicad_pcb]
2025-04-24 vault backup: 2025-04-24 17:06:29
    [SwerveModuleBoard.kicad_sch]
2025-04-24 vault backup: 2025-04-24 19:34:02
    [SwerveModuleBoard.kicad_sch]
2025-04-24 vault backup: 2025-04-24 19:44:10
    [SwerveModuleBoard.kicad_sch]
2025-04-25 SO MUCH POWER
    [MainBoardPCB.kicad_sch]
2025-04-25 added buck boost
    [SwerveModuleBoard.kicad_sch]
2025-04-25 vault backup: 2025-04-25 01:51:37
    [SwerveModuleBoard.kicad_pcb, SwerveModuleBoard.kicad_sch]
2025-04-25 vault backup: 2025-04-25 02:02:09
    [SwerveModuleBoard.kicad_sch]
2025-04-25 vault backup: 2025-04-25 02:07:20
    [SwerveModuleBoard.kicad_sch]
2025-04-25 vault backup: 2025-04-25 03:02:18
    [SwerveModuleBoard.kicad_pcb, SwerveModuleBoard.kicad_sch]
2025-04-25 vault backup: 2025-04-25 03:12:28
    [SwerveModuleBoard.kicad_pcb]
2025-04-25 vault backup: 2025-04-25 03:17:35
    [SwerveModuleBoard.kicad_sch]
2025-04-25 vault backup: 2025-04-25 03:37:54
    [SwerveModuleBoard.kicad_sch]
2025-04-25 vault backup: 2025-04-25 03:43:01
    [SwerveModuleBoard.kicad_pcb]
2025-04-25 vault backup: 2025-04-25 04:03:28
    [SwerveModuleBoard.kicad_sch]
2025-04-25 vault backup: 2025-04-25 04:08:35
    [SwerveModuleBoard.kicad_sch]
2025-04-25 vault backup: 2025-04-25 04:13:42
    [SwerveModuleBoard.kicad_sch]
2025-04-25 vault backup: 2025-04-25 04:34:04
    [SwerveModuleBoard.kicad_pcb]
2025-04-25 vault backup: 2025-04-25 04:39:11
    [SwerveModuleBoard.kicad_pcb]
2025-04-25 vault backup: 2025-04-25 04:44:17
    [SwerveModuleBoard.kicad_pcb]
2025-04-25 vault backup: 2025-04-25 04:54:28
    [SwerveModuleBoard.kicad_pcb]
2025-04-25 vault backup: 2025-04-25 05:09:46
    [SwerveModuleBoard.kicad_pcb]
2025-04-25 vault backup: 2025-04-25 05:14:52
    [SwerveModuleBoard.kicad_pcb]
2025-04-25 vault backup: 2025-04-25 05:19:58
    [SwerveModuleBoard.kicad_pcb]
2025-04-25 vault backup: 2025-04-25 05:25:04
    [SwerveModuleBoard.kicad_pcb]
2025-04-25 AH BOARDS
    [MainBoardPCB.kicad_sch, SwerveModuleBoard.kicad_sch]
2025-04-25 vault backup: 2025-04-25 05:55:47
    [SwerveModuleBoard.kicad_sch]
2025-04-25 vault backup: 2025-04-25 06:06:02
    [SwerveModuleBoard.kicad_sch]
2025-04-25 vault backup: 2025-04-25 06:16:16
    [SwerveModuleBoard.kicad_pcb]
2025-04-25 vault backup: 2025-04-25 06:21:26
    [SwerveModuleBoard.kicad_pcb]
2025-04-25 vault backup: 2025-04-25 06:26:33
    [SwerveModuleBoard.kicad_pcb]
2025-04-25 vault backup: 2025-04-25 06:29:06
    [SwerveModuleBoard.kicad_pcb]
2025-04-25 Module Board Done
    [SwerveModuleBoard.kicad_pcb]
2025-04-25 board go brrr
    [MainBoardPCB.kicad_pcb]
2025-04-26 vault backup: 2025-04-25 21:40:27
    [SwerveModuleBoard.kicad_pcb, SwerveModuleBoard.kicad_sch]
2025-04-26 vault backup: 2025-04-25 21:55:47
    [SwerveModuleBoard.kicad_pcb]
2025-04-26 vault backup: 2025-04-25 22:11:06
    [SwerveModuleBoard.kicad_sch]
2025-04-26 vault backup: 2025-04-25 22:16:16
    [SwerveModuleBoard.kicad_pcb]
2025-04-26 vault backup: 2025-04-25 22:21:27
    [SwerveModuleBoard.kicad_pcb]
2025-04-26 vault backup: 2025-04-25 22:41:57
    [MainBoardPCB.kicad_pcb]
2025-04-26 Go us
    [MainBoardPCB.kicad_pcb, MainBoardPCB.kicad_sch]
2025-04-26 Made your pours cooler
    [SwerveModuleBoard-B_Cu.gbr, SwerveModuleBoard-B_Mask.gbr, SwerveModuleBoard-B_Paste.gbr, SwerveModuleBoard-B_Silkscreen.gbr, SwerveModuleBoard-Edge_Cuts.gbr, SwerveModuleBoard-F_Cu.gbr, SwerveModuleBoard-F_Mask.gbr, SwerveModuleBoard-F_Paste.gbr]
2025-04-26 Exported Board
    [MainBoardPCB-B_Cu.gbr, MainBoardPCB-B_Mask.gbr, MainBoardPCB-B_Paste.gbr, MainBoardPCB-B_Silkscreen.gbr, MainBoardPCB-Edge_Cuts.gbr, MainBoardPCB-F_Cu.gbr, MainBoardPCB-F_Mask.gbr, MainBoardPCB-F_Paste.gbr]
2025-04-26 vault backup: 2025-04-26 15:16:27
    [SwerveModuleBoard.kicad_pcb]
2025-04-26 Added esp 3d model
    [10103594-0001LF.step, ESP32-S3-WROOM-1-N8.STEP, LGA14-L_2P59X3P1X0P5_STM.step, MainBoardPCB.kicad_pcb, PTS636SM43LFS.stp, RQF0009A.stp, SOIC_128JVSIQ_WIN.step, SOT-23-5_M5_MCH.step]
2025-04-26 vault backup: 2025-04-26 17:28:27
    [AMASS_XT60-F_1x02_P7.2mm_Vertical.step, AMASS_XT60-M_1x02_P7.2mm_Vertical.step, MainBoardPCB.kicad_pcb]
2025-04-26 vault backup: 2025-04-26 17:33:33
    [AS5600-ASOT.step, RMW0012A.stp, RXZ0016A.stp, TPS63051RMWR.step]
2025-04-26 vault backup: 2025-04-26 17:38:39
    [AS5600-ASOT.step, RMW0012A.stp, RXZ0016A.stp, TPS63051RMWR.step]
2025-04-26 vault backup: 2025-04-26 17:43:46
    [CAP_E61_CHC.step]
2025-04-26 3d models
    [SwerveModuleBoard.kicad_pcb]
2025-04-26 Changed colors and added models
    [MainBoardPCB.kicad_pcb]
2025-04-26 vault backup: 2025-04-26 17:59:27
    [MainBoardPCB.kicad_pcb]
2025-04-26 added usb micro
    [10103594-0001LF.step]
2025-04-26 Added the 3d models and shit
    [PTS636SM43LFS.stp, SwerveModuleBoard.kicad_pcb]
2025-04-26 vault backup: 2025-04-26 18:14:57
    [SwerveModuleBoard.kicad_pcb]
2025-04-26 fixed models -riley
    [SwerveModuleBoard.kicad_pcb]
2025-05-05 vault backup: 2025-05-05 19:42:36
    [MainBoardPCB.kicad_sch]
2026-10-28 Polishing Schematic
    Teraz 200% więcej polskiego
