notMarque/RomiOnSpeed/(notices)

Notices in the files:
PCBs/Main Board/MainBoardPCB/3dModels/PTS636SM43LFS.stp:
author */ ('License CC BY-ND 4.0'),
